lfantoniosi/CoCoTANG/README.md

# CoCoTANG

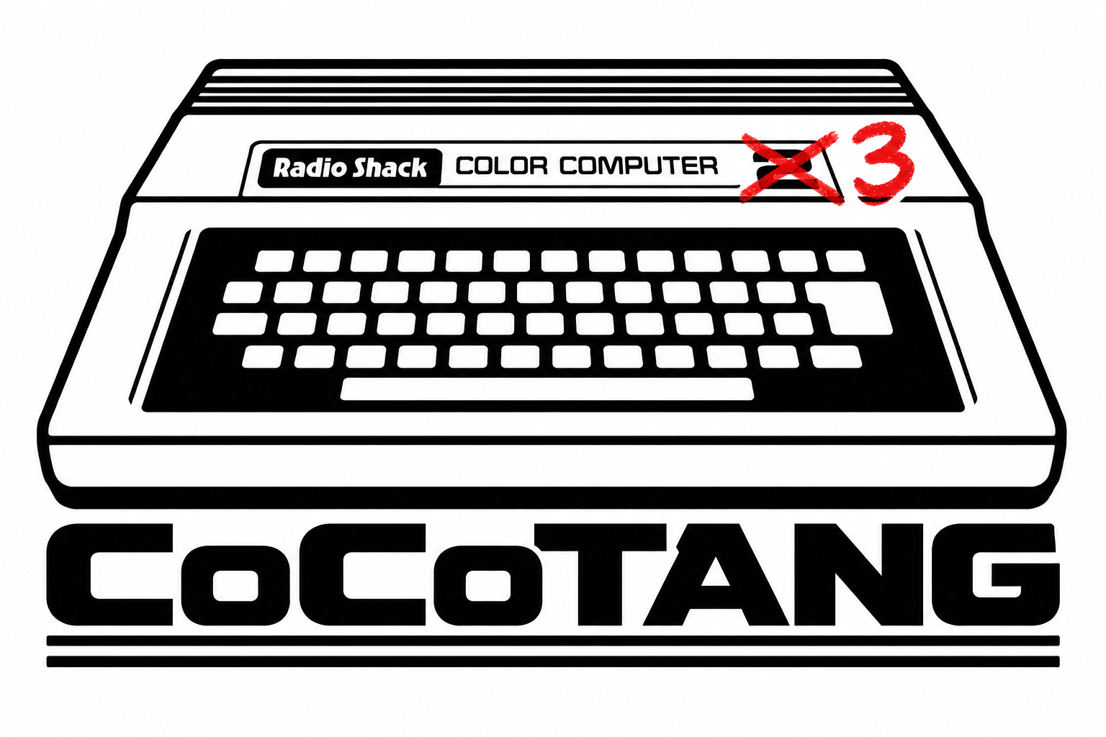
[picture p1: models/logo.png]
CoCoTANG logo


## Overview

CoCoTANG upgrades the Radio Shack/Tandy Color Computer 1 and 2 with a Tang Nano 20K FPGA board and CoCo 3 video and memory features. It retains the MC6809E CPU and motherboard PIAs while the FPGA implements the GIME video and memory subsystem, HDMI and analog video outputs, and a Glenside-compatible IDE interface backed by a microSD card. It also provides 8 MB of RAM, Orchestra-90 audio with stereo over HDMI, and Tandy Speech/Sound Cartridge (SSC) support.

This repository contains the FPGA sources, KiCad designs, fabrication files, and bill of materials.

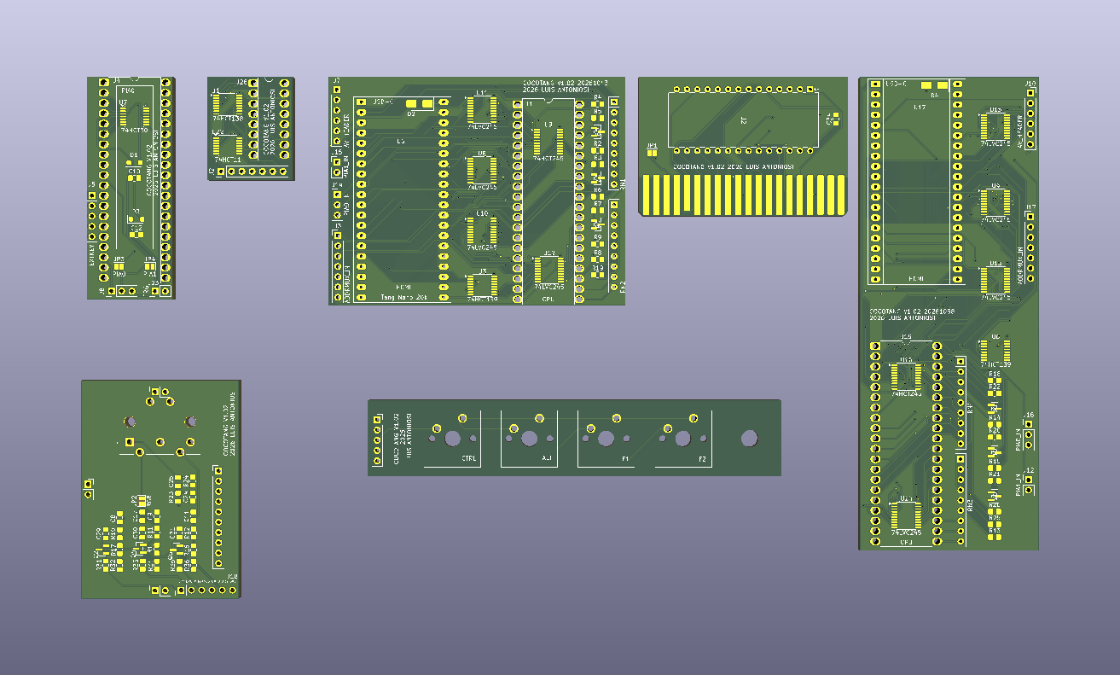
[picture p2: fpga/docs/board-panel.png]
Render of the complete CoCoTANG PCB panel


The assembly uses a **main board** for the CPU and Tang Nano 20K, **PIA0 and PIA1 adapter boards**, and an **address mux board** that replaces the motherboard 74LS138. An **analog video hat** and an **HDB-DOS ROM cartridge** are optional. The render above shows the boards arranged as a PCB panel. HDB-DOS can also be supplied through an FD-502 ROM socket or CoCo SDC flash bank.

The design uses NTSC machine clocking. The GIME's 50 Hz setting remains available, but selecting it does **not** switch to a PAL crystal. PAL-encoded CVBS/S-Video output is also supported. See [Build on macOS or Linux](#build-on-macos-or-linux) for video targets and the [FPGA pin and bus map](fpga/docs/pinout.md) for hardware connections.

## Compatibility

### Color Computer 1 power-supply noise

CoCoTANG has been confirmed working on a Color Computer 1 with added power-supply decoupling: **a 100 µF electrolytic capacitor and a 100 nF ceramic capacitor connected in parallel across the supply**, as shown below. This resolves the power-supply noise that previously caused rolling video interference and intermittent loss of analog sync, and also appeared to affect HDMI.

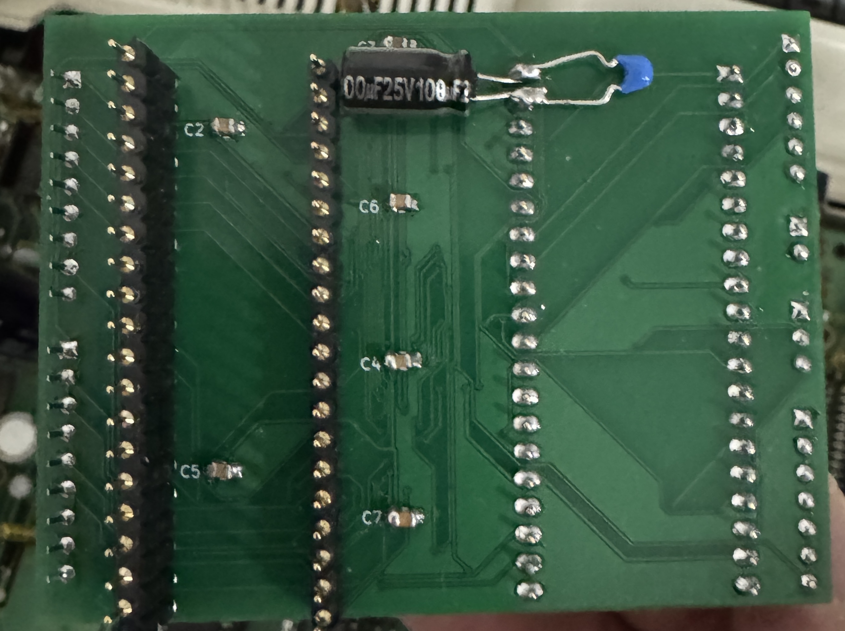
[picture p3: fpga/docs/coco1-decoupler.jpg]
100 µF electrolytic and 100 nF ceramic decoupling capacitors installed on the CoCoTANG board for CoCo 1 operation


### Games

So far, **The Contras is the only game found to fail to load in its original form**. CoCoTANG's **262.5-scanline timing drifts relative to the original CoCo 3**. The resulting timing difference affects an unprotected code section in the game and prevents the original version from loading.

Use the [patched version of The Contras](https://drive.google.com/file/d/1ANGJpljmbaEt34lFBowtTOSvq0qSiGtF/view?usp=sharing) instead. This patched version also includes **keyboard enhancements**.

### Multi-Pak Interface and real floppy drives

A **Multi-Pak Interface (MPI)** holds the cartridge data bus in a way that prevents access to CoCoTANG's internal peripheral registers. With an MPI connected, the **internal Glenside IDE, SSC sound/speech, and Orchestra-90 are unavailable**. Software that uses these internal devices must be run without the MPI.

**An MPI is required to use real floppy drives.** Plug the floppy disk controller into the MPI and connect the drives to that controller. This setup uses the external floppy controller, with the internal IDE, SSC, and Orchestra-90 unavailable as described above.

## Current FPGA features

- GIME video and memory mapping with 8 MB NoCan3-style RAM support and readable Disto MMU page bits.
- Simultaneous HDMI and analog video, with separate RGB, YPbPr, and CVBS/S-Video build targets.
- Six motherboard RESET selections combining normal, reversed, or disabled artifact colours with SSC sound/speech off or on.
- Tandy Speech/Sound Cartridge PSG, buffered allophones, and ASCII English text-to-speech, alongside the CoCo DAC and Orchestra-90 audio.
- HDMI status labels and an optional analog status banner with a larger font.

## Hardware and files

| Item | File or notes |
| --- | --- |
| PCB fabrication files | [Gerber/drill ZIPs for each board](kicad/gerber/) |
| KiCad schematic and PCB | [kicad/](kicad/) |
| Components | Full bill of materials below |
| FPGA project and sources | [fpga/](fpga/) |
| FPGA pin/bus map | [fpga/docs/pinout.md](fpga/docs/pinout.md) |

## Board quantities and Gerber downloads

For one CoCoTANG installation, you need **one main board, one address mux board, and two PIA boards**: one for PIA0 and one for PIA1. There are two main-board versions, for motherboard revisions **20261043** and **20261058**; choose the version that matches your motherboard. The HDB-DOS cartridge and video hat are optional.

| Board | Quantity per installation | Gerber/drill ZIP |
| --- | --- | --- |
| Main board (CPU / Tang Nano 20K) | 1 required; choose the matching version | See the compatibility table below |
| Address mux (addrmux) | 1 required | [gerber_addrmux.zip](kicad/gerber/gerber_addrmux.zip) |
| PIA card | 2 required: PIA0 and PIA1 | [gerber_pia.zip](kicad/gerber/gerber_pia.zip) |
| HDB-DOS cartridge | 1 optional | [gerber_cart.zip](kicad/gerber/gerber_cart.zip) |
| Video hat | 1 optional | [gerber_avideo.zip](kicad/gerber/gerber_avideo.zip) |
| External keyboard extension | 1 optional | [gerber_extkey.zip](kicad/gerber/gerber_extkey.zip) |

Use the same PIA Gerber ZIP to fabricate both PIA cards. Upload each desired board's ZIP separately to your PCB manufacturer and select the quantities above, subject to the manufacturer's minimum order quantity.

Select **1.2 mm PCB thickness** when ordering the adapter boards. The thinner boards reduce the installed profile and help the assembly fit under the keyboard.

## Motherboard compatibility

Tandy used several motherboard layouts for the CoCo 2. Identify your motherboard before ordering boards: the CPU and address mux adapters must fit its layout. Only the revisions marked compatible below are currently supported; other layouts may need different adapters.

| Motherboard revision | Compatible | Main board Gerber ZIP |
| --- | --- | --- |
| [20261043](fpga/docs/20261043.jpg) | Yes | [gerber_main_20261043.zip](kicad/gerber/gerber_main_20261043.zip) |
| [20261058](fpga/docs/20261058.jpg) | Yes | [gerber_main_20261058.zip](kicad/gerber/gerber_main_20261058.zip) |
| [20261044](fpga/docs/20261044.jpg) | No | — |
| [20261045](fpga/docs/20261045.jpg) | No | — |
| [20261059](fpga/docs/20261059.jpg) | No | — |

**CoCo 1 operation is confirmed with added 100 µF + 100 nF supply decoupling.** See the [decoupling details and installation photo](#color-computer-1-power-supply-noise).

## Bill of materials

Both main-board versions (**20261043** and **20261058**) use the same components and quantities; only the PCB layout differs. Use the fabrication drawing and silkscreen for the version you are assembling.

### Logic families and supply voltages

Use **HCT** parts for the 5 V logic: U9/U16 (74HCT245, depending on the main-board version), U1 (74HCT138), U22 (74HCT11), and U7 (74HCT30). Their TTL-compatible inputs accept the logic levels used at the motherboard interface. The table below gives the manufacturer part numbers, matching DigiKey part numbers, and TSSOP packages.

**U3/U6 are 74HC139 decoders powered from 3.3 V**, with their select inputs driven by the FPGA. Keep the HC version here: [74HCT139 is specified for a 4.5–5.5 V supply](https://assets.nexperia.com/documents/data-sheet/74HC_HCT139.pdf). A 3.3 V supply makes HC139 suitable for this 3.3 V logic domain; it does not turn HC into a generally TTL-compatible family. The KiCad labels now identify both decoder instances as HC139.

The four **74LVC245** buffers on each main board remain LVC parts for the 3.3 V interface; their reference designators are listed for both layouts below. Their TSSOP ordering code is **SN74LVC245APWR**.

### Main board — both versions

The reference columns identify the same components on each layout. Lists follow the same order across both columns. The three interrupt/reset resistors and the additional R/W pull-up are listed separately. The other adapter boards below are shared between both versions.

| Qty | Value | Description | DigiKey P/N | 20261043 references | 20261058 references | Alternative link |
| ---: | --- | --- | --- | --- | --- | --- |
| 1 | Tang Nano 20K | Tang Nano 20K FPGA Board | N/A | U5 | U17 | [AliExpress](https://www.aliexpress.com/item/1005010280135538.html) |
| 6 | 0.1 µF | CAP CER 0805 0.1UF 100VDC X7R | [399-C0805F104K1RACAUTOCT-ND](https://www.digikey.com/en/products/detail/kemet/C0805F104K1RACAUTO/26735352) | C2, C3, C4, C5, C6, C7 | C13, C16, C19, C14, C18, C15 |  |
| 3 | MMBT3904-TP | TRANS NPN 40V 0.2A SOT-23 | [MMBT3904TPMSCT-ND](https://www.digikey.com/en/products/detail/mcc-micro-commercial-components/MMBT3904-TP/717280) | Q7, Q8, Q9 | Q1, Q3, Q6 |  |
| 1 | SS14 | DIODE SCHOTTKY 40V 1A DO214AC | [SS14CT-ND](https://www.digikey.com/en/products/detail/onsemi/SS14/965474) | D2 | D4 |  |
| 3 | 10K | RES 10K OHM 1% 1/8W 0805 | [311-10.0KCRCT-ND](https://www.digikey.com/en/products/detail/yageo/RC0805FR-0710KL/727535) | R2, R4, R6 | R14, R18, R15 |  |
| 3 | 4.7K | RES 4.7K OHM 1% 1/8W 0805 | [311-4.70KCRCT-ND](https://www.digikey.com/en/products/detail/yageo/RC0805FR-074K7L/730876) | R3, R5, R7 | R20, R22, R21 |  |
| 1 | 4.7K | R/W pull-up, 1% 1/8W 0805 | [311-4.70KCRCT-ND](https://www.digikey.com/en/products/detail/yageo/RC0805FR-074K7L/730876) | R19 | R13 |  |
| 2 | 47K | RES SMD 47K OHM 1% 1/8W 0805 | [YAG3735CT-ND](https://www.digikey.com/en/products/detail/yageo/AC0805FR-0747KL/6006584) | R8, R9 | R25, R26 |  |
| 2 | 4.7K | RES ARRAY 8 RES 4.7K OHM 9SIP | [4609X-101-472LF-ND](https://www.digikey.ca/en/products/detail/bourns-inc/4609X-101-472LF/3593671) | RN1, RN2 | RN4, RN3 |  |
| 4 | SN74LVC245APWR | 8-bit bus transceiver, 1.65–3.6 V, TSSOP-20 | [296-1233-1-ND](https://www.digikey.com/en/products/detail/texas-instruments/SN74LVC245APWR/276501) | U8, U10, U11, U12 | U4, U13, U15, U14 |  |
| 1 | SN74HCT245PWR | 8-bit bus transceiver, TTL inputs, 4.5–5.5 V, TSSOP-20 | [296-8404-1-ND](https://www.digikey.com/en/products/detail/texas-instruments/SN74HCT245PWR/376998) | U9 | U16 |  |
| 1 | 74HC139PW,118 | Dual 2-to-4 decoder, CMOS inputs, 2–6 V; used at 3.3 V, TSSOP-16 | [1727-6580-1-ND](https://www.digikey.com/en/products/detail/nexperia-usa-inc/74HC139PW-118/2813773) | U3 | U6 |  |
| 1 | SIL FEMALE HDR | MACHINE PIN SOCKET 40P 2.54MM PI | [SMC-1A-40-1-GT-HT](https://www.digikey.com/en/products/detail/adam-tech/SMC-1A-40-1-GT-HT/9831942) | U5 | U17 | [AliExpress](https://www.aliexpress.com/item/1005008648234734.html) |
| 1 | DIP-40 SOCKET | MACHINE PIN SOCKET, IC, DIP, 40P | [ICM-640-1-GT-HT](https://www.digikey.com/en/products/detail/adam-tech/ICM-640-1-GT-HT/9832971) | J1 | J19 | [AliExpress](https://www.aliexpress.com/item/1005006139495909.html) |

### PIA0 adapter

| Qty | Value | Description | DigiKey P/N | References | Alternative link |
| ---: | --- | --- | --- | --- | --- |
| 1 | 0.1 µF | CAP CER 0805 0.1UF 100VDC X7R | [399-C0805F104K1RACAUTOCT-ND](https://www.digikey.com/en/products/detail/kemet/C0805F104K1RACAUTO/26735352) | C1 | |
| 1 | DIP-40 SOCKET | MACHINE PIN SOCKET, IC, DIP, 40P | [ICM-640-1-GT-HT](https://www.digikey.com/en/products/detail/adam-tech/ICM-640-1-GT-HT/9832971) | J4 | [AliExpress](https://www.aliexpress.com/item/1005006139495909.html) |
| 1 | 74HCT30PW,118 | 8-input NAND gate, TTL inputs, 4.5–5.5 V, TSSOP-14 | [1727-6632-1-ND](https://www.digikey.com/en/products/detail/nexperia-usa-inc/74HCT30PW-118/1230819) | U7 | |
| 2 | 1,800 pF | CAP CER 1800PF 250V C0G/NP0 0805 | [490-GCM21A5C2E182FX01DCT-ND](https://www.digikey.ca/en/products/detail/murata-electronics/GCM21A5C2E182FX01D/17845644) | C10,C12 | |
| 2 | SD103BW | DIODE SCHOTTKY 30V 0.35A SOD123F | [4878-SD103BWCT-ND](https://www.digikey.com/en/products/detail/diotec-semiconductor/SD103BW/22600375) | D1,D3 | |

### PIA1 adapter

| Qty | Value | Description | DigiKey P/N | References | Alternative link |
| ---: | --- | --- | --- | --- | --- |
| 1 | DIP-40 SOCKET | MACHINE PIN SOCKET, IC, DIP, 40P | [ICM-640-1-GT-HT](https://www.digikey.com/en/products/detail/adam-tech/ICM-640-1-GT-HT/9832971) | J4 | [AliExpress](https://www.aliexpress.com/item/1005006139495909.html) |

### Address mux board

| Qty | Value | Description | DigiKey P/N | References | Alternative link |
| ---: | --- | --- | --- | --- | --- |
| 2 | 0.1 µF | CAP CER 0805 0.1UF 100VDC X7R | [399-C0805F104K1RACAUTOCT-ND](https://www.digikey.com/en/products/detail/kemet/C0805F104K1RACAUTO/26735352) | C32,C33 | |
| 1 | SN74HCT138PWR | 3-to-8 decoder, TTL inputs, 4.5–5.5 V, TSSOP-16 | [296-8388-1-ND](https://www.digikey.com/en/products/detail/texas-instruments/SN74HCT138PWR/377055) | U1 | |
| 1 | 74HCT11PW,118 | Triple 3-input AND gate, TTL inputs, 4.5–5.5 V, TSSOP-14 | [1727-7964-1-ND](https://www.digikey.com/en/products/detail/nexperia-usa-inc/74HCT11PW-118/1230602) | U22 | |
| 1 | DIP-16 SOCKET | CONN IC DIP SOCKET 16POS GOLD | [SA163000](https://www.digikey.com/en/products/detail/on-shore-technology-inc/SA163000/3313525) | J28 | [AliExpress](https://www.aliexpress.com/item/32866483409.html) |

### HDB-DOS cartridge

| Qty | Value | Description | DigiKey P/N | References | Alternative link |
| ---: | --- | --- | --- | --- | --- |
| 1 | DIP-28 SOCKET | CONN IC DIP SOCKET 28POS GOLD | [110-41-628-41-001000](https://www.digikey.com/en/products/detail/mill-max-manufacturing-corp/110-41-628-41-001000/2538108) | U2 | [AliExpress](https://www.aliexpress.com/item/32866483409.html) |
| 1 | 0.1 µF | CAP CER 0805 0.1UF 100VDC X7R | [399-C0805F104K1RACAUTOCT-ND](https://www.digikey.com/en/products/detail/kemet/C0805F104K1RACAUTO/26735352) | C34 | |
| 1 | AT28C64B-15PU | IC EEPROM 64KBIT PARALLEL 28DIP | [AT28C64B-15PU-ND](https://www.digikey.com/en/products/detail/microchip-technology/AT28C64B-15PU/1008529) | U2 | |

### Analog video board

| Qty | Value | Description | DigiKey P/N | References | Alternative link |
| ---: | --- | --- | --- | --- | --- |
| 3 | 0.1 µF | CAP CER 0805 0.1UF 100VDC X7R | [399-C0805F104K1RACAUTOCT-ND](https://www.digikey.com/en/products/detail/kemet/C0805F104K1RACAUTO/26735352) | C29,C30,C31 | |
| 3 | 470 pF | CAP CER 470PF 50V C0G/NP0 0805 | [490-1617-1-ND](https://www.digikey.com/en/products/detail/murata-electronics/GRM2165C1H471JA01D/587515) | C8,C9,C11 | |
| 1 | 1 µF | CAP CER 1UF 25V X7R 0805 | [399-C0805C105K3RACTUCT-ND](https://www.digikey.com/en/products/detail/kemet/C0805C105K3RACTU/3471727) | C15 | |
| 6 | 1K | RES 1K OHM 1% 1/8W 0805 | [541-3977-1-ND](https://www.digikey.com/en/products/detail/vishay-dale/CRCW08051K00FKEAC/7928660) | R31,R17,R33,R1,R35,R16 | |
| 3 | 75 | RES 75 OHM 1% 1/8W 0805 | [541-CRCW080575R0FKEACCT-ND](https://www.digikey.com/en/products/detail/vishay-dale/CRCW080575R0FKEAC/12745060) | R10,R11,R12 | |
| 3 | 4.7K | RES 4.7K OHM 1% 1/8W 0805 | [311-4.70KCRCT-ND](https://www.digikey.com/en/products/detail/yageo/RC0805FR-074K7L/730876) | R32,R34,R36 | |
| 1 | 6.8 nF | CAP CER 6800PF 250V C0G/NP0 0805 | [490-GCM21B5C2E682JX0ALCT-ND](https://www.digikey.com/en/products/detail/murata-electronics/GCM21B5C2E682JX0AL/17846799) | C24 | |
| 1 | 4.7 µF | CAP CER 4.7UF 16V X7R 0805 | [732-7666-1-ND](https://www.digikey.com/en/products/detail/w%C3%BCrth-elektronik/885012207053/5453521) | C25 | |
| 1 | 100K | RES 100K OHM 1% 1/8W 0805 | [541-3978-1-ND](https://www.digikey.com/en/products/detail/vishay-dale/CRCW0805100KFKEAC/7928661) | R24 | |
| 3 | MMBT3904-TP | TRANS NPN 40V 0.2A SOT-23 | [MMBT3904TPMSCT-ND](https://www.digikey.com/en/products/detail/mcc-micro-commercial-components/MMBT3904-TP/717280) | Q2,Q4,Q5 | |
| 1 | DIN-5 FEMALE | D5 PIN DIN SOCKET 180 DEGREE | [4654-FC680805-ND](https://www.digikey.ca/en/products/detail/cliff-electronic-components-ltd/FC680805/24420883) | J24 | [AliExpress](https://www.aliexpress.com/item/32981543684.html)|

## Boards Interconnection
| Qty | Value | Description | DigiKey P/N | References | Alternative link |
| ---: | --- | --- | --- | --- | --- |
| 2 | PRPC040SBAN-M71RC | CONN HEADER R/A 40POS 2.54MM | [S1111EC-40-ND](https://www.digikey.ca/en/products/detail/sullins-connector-solutions/PRPC040SBAN-M71RC/2775294) | 
| 2 |1950 | JUMPER WIRE F TO F 6" 28AWG | [1528-1961-ND](https://www.digikey.ca/en/products/detail/adafruit-industries-llc/1950/6827084)

*NOTE:* You may need more than one jumper wires pack or source at different place like Amazon. CoCo1 requires longer jumper wires  

## Assembly

Print the [fabrication drawing](fpga/docs/fab.pdf) and use it with the board silkscreen to identify component positions. Check diode orientation before soldering. The main-board bill of materials applies to both supported versions; component positions differ between layouts.

Several adapters have oversized socket holes. They require machined-pin sockets whose pins extend through the adapter to connect to the motherboard socket while holding the original IC above it. Use 1.2 mm PCBs to reduce the overall assembly height and improve clearance under the keyboard.

1. Locate and desolder the CPU, VDG, SAM, PIA0, PIA1, and 74LS138.
2. Keep the SAM, VDG, and 74LS138 as spares; the FPGA replaces their functions.
3. Install sockets in the motherboard. Do not solder the adapter boards directly to it.
4. Check clearance around the adapters. Some original capacitors marked `104` are oversized, and nearby radial capacitors may also interfere. Where necessary, desolder and reposition their leads before bending the capacitors closer to the motherboard.
5. Populate the adapter boards, checking diode orientation. Configure each PIA adapter as described in [PIA adapter configuration](#pia-adapter-configuration).
6. Modify pin 5 of each joystick connector and wire it to the PIA0 adapter as described in [Joystick second-button support](#joystick-second-button-support).
7. Fit the CPU and PIAs to their adapters, install the adapters, and connect the boards as shown in the [installed prototype](fpga/docs/installed_prototype.jpg).
8. Program the Tang Nano 20K with the desired `.fs` bitstream and CoCo 3 ROM, following the programming instructions below.
9. If using the optional HDB-DOS cartridge, program its EEPROM with [hdblba.rom](fpga/roms/hdblba.rom) using an EEPROM programmer.
10. Turn on the computer. The boot screen should look like the example below.

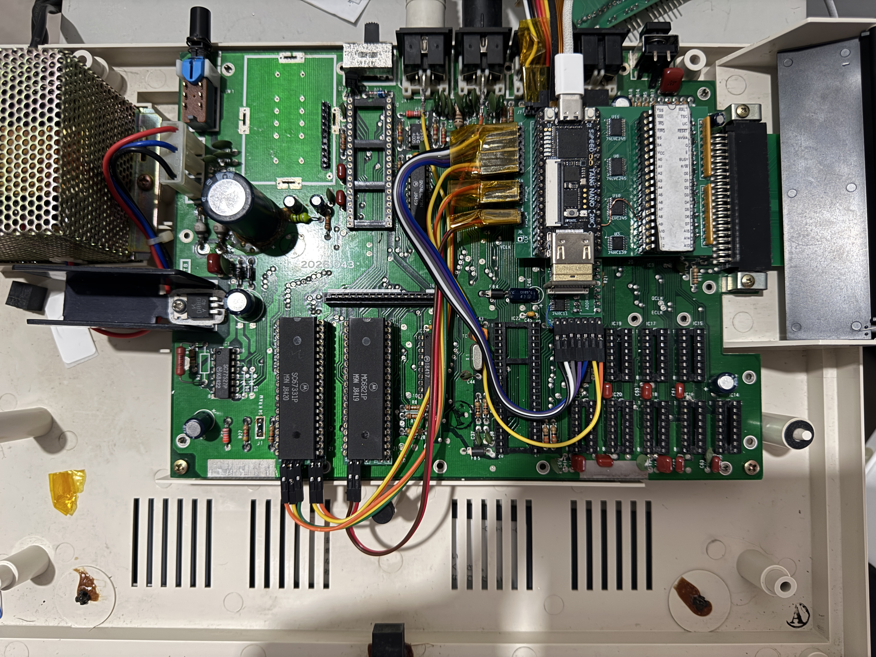
[picture p4: fpga/docs/installed_prototype.jpg]
Installed CoCoTANG prototype showing the adapter boards and wiring


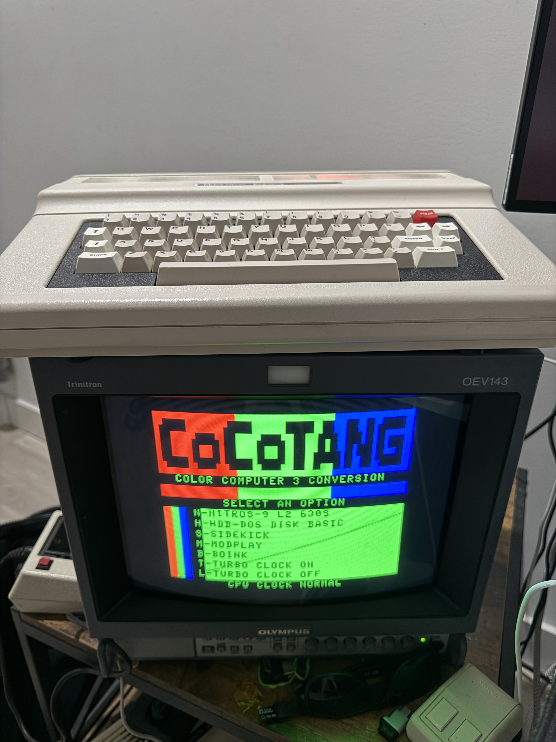
[picture p5: fpga/docs/CoCoTANG-RGB.jpg]
CoCoTANG boot screen


### Assembled boards

The photos below show the component population and header placement, in assembly order. Front and back views are included where available.

#### Main board

The main board carries the CPU socket, Tang Nano 20K headers, bus buffers, and connections to the other adapters. The photos show the assembled board before fitting the CPU and FPGA module. Choose the layout that matches your motherboard revision.

| Front | Back |
| --- | --- |
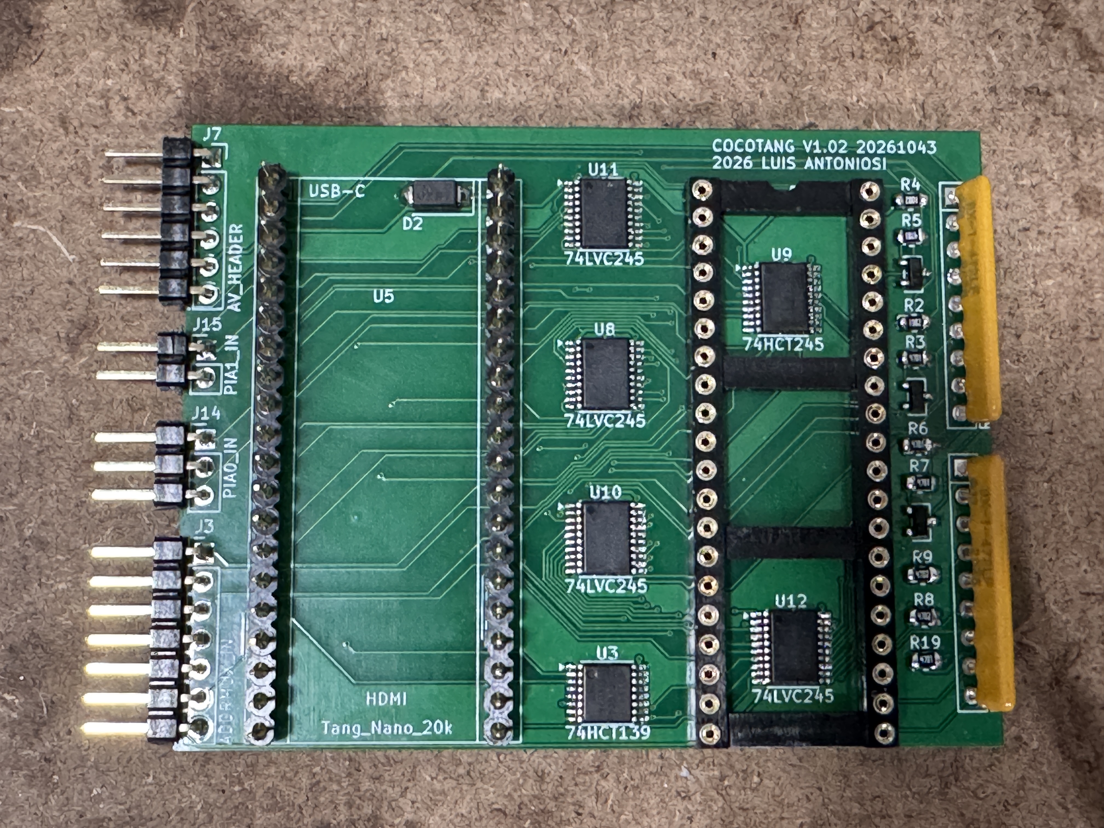
[picture p6: fpga/docs/main-front.JPG]
Assembled main board, front, showing CPU socket, FPGA headers, and bus buffers
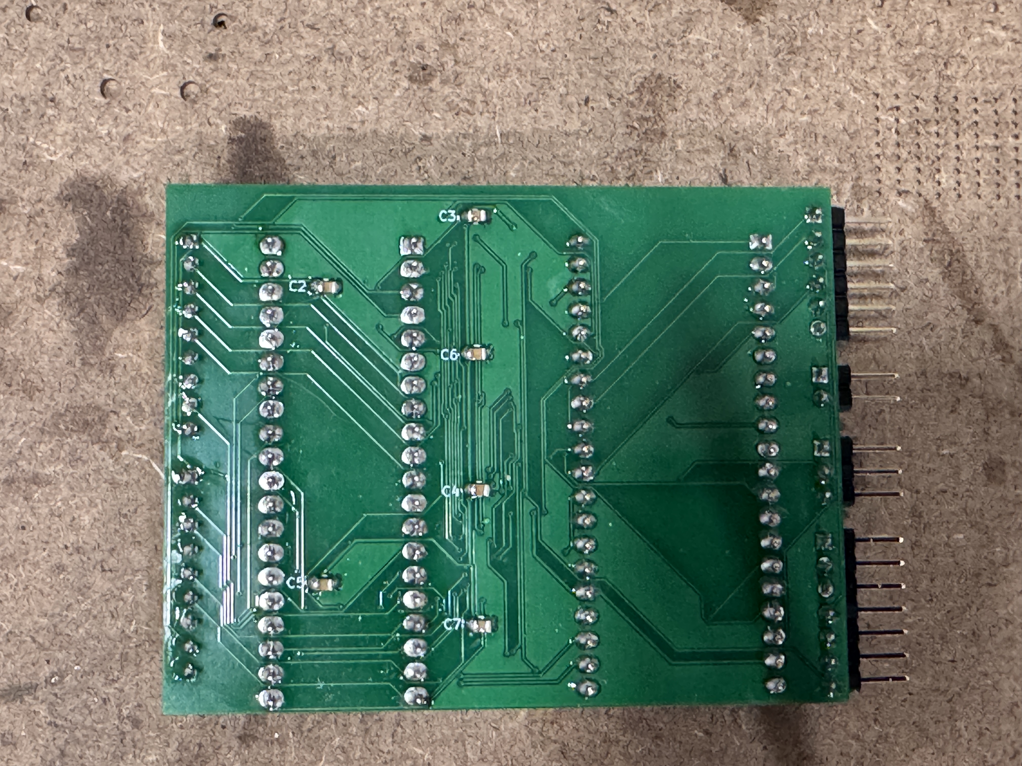
[picture p7: fpga/docs/main-back.JPG]
Assembled main board, back, showing motherboard connection pins
|  |  |

#### ADDRMUX board

The address mux adapter plugs into the motherboard's former **74LS138** position and connects to the main board. **Leave the 74LS138 socket on the ADDRMUX adapter empty; do not reinstall the original IC in it.** The adapter's onboard logic replaces its function.

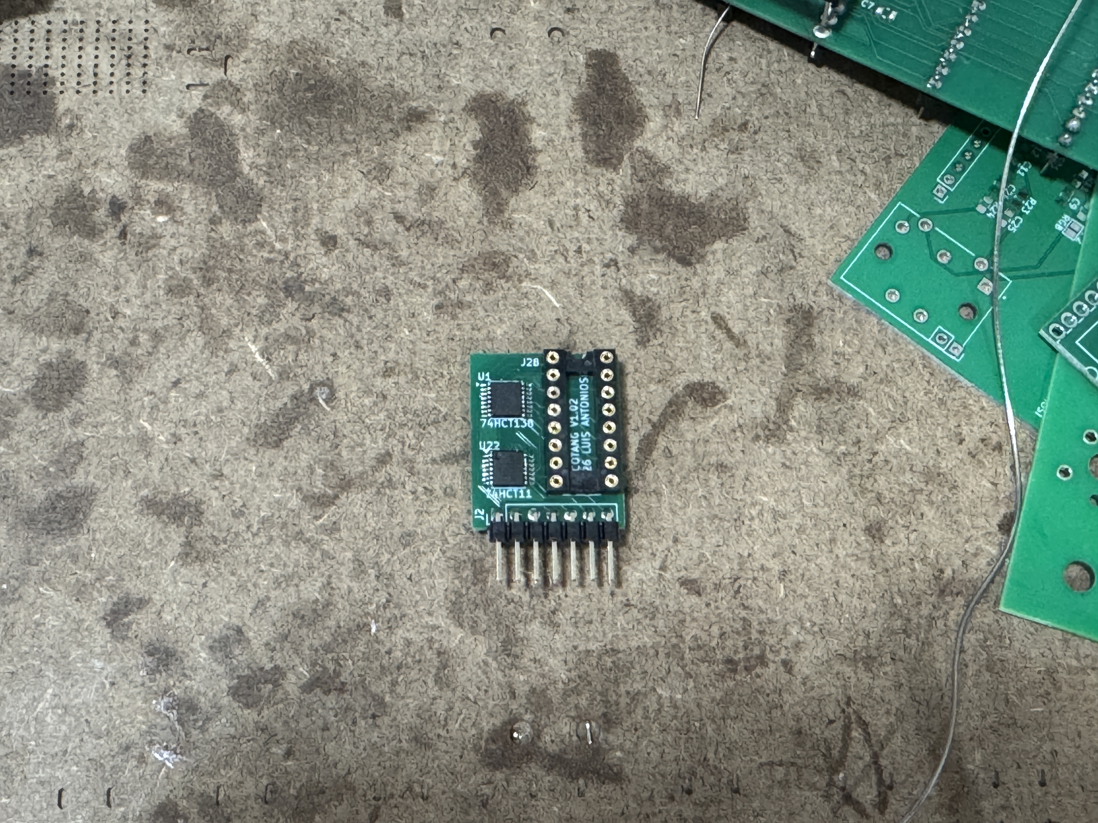
[picture p8: fpga/docs/addrmux-front.JPG]
Assembled ADDRMUX board with its 74LS138 socket deliberately left empty


#### PIA0 adapter

Populate the logic IC, diodes, capacitors, and headers required for PIA0, and select the **PIA0** jumper setting. The external keyboard header is fitted only on this adapter. These photos show the board before installing the PIA.

| Front | Back |
| --- | --- |
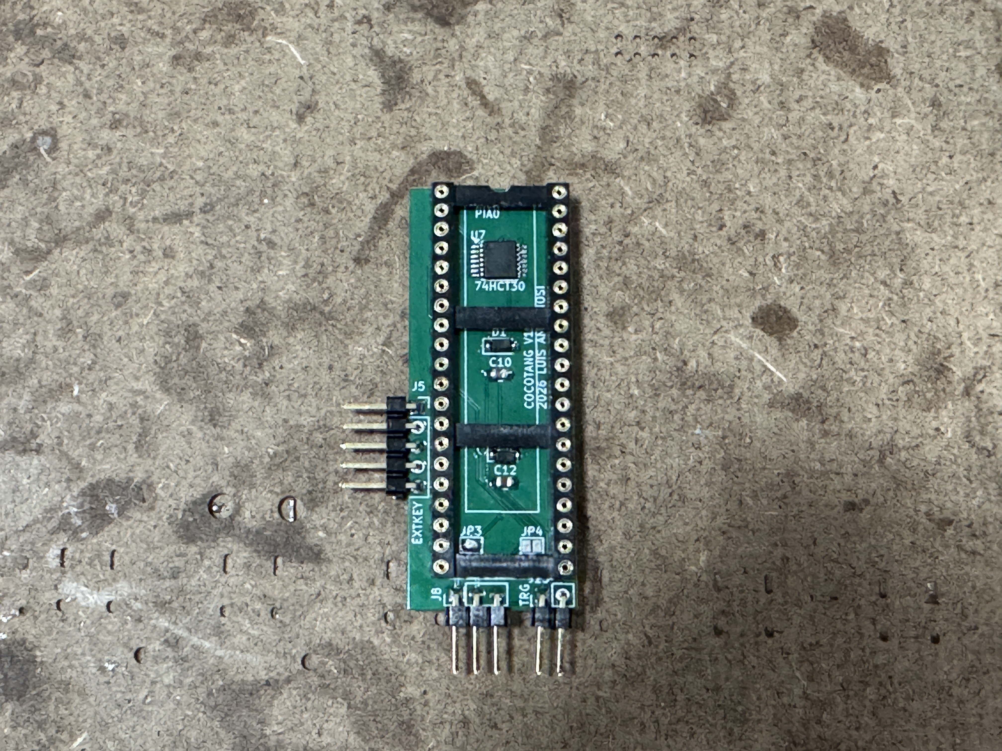
[picture p9: fpga/docs/pia0-front.JPG]
Assembled PIA0 adapter, front, showing populated logic and headers
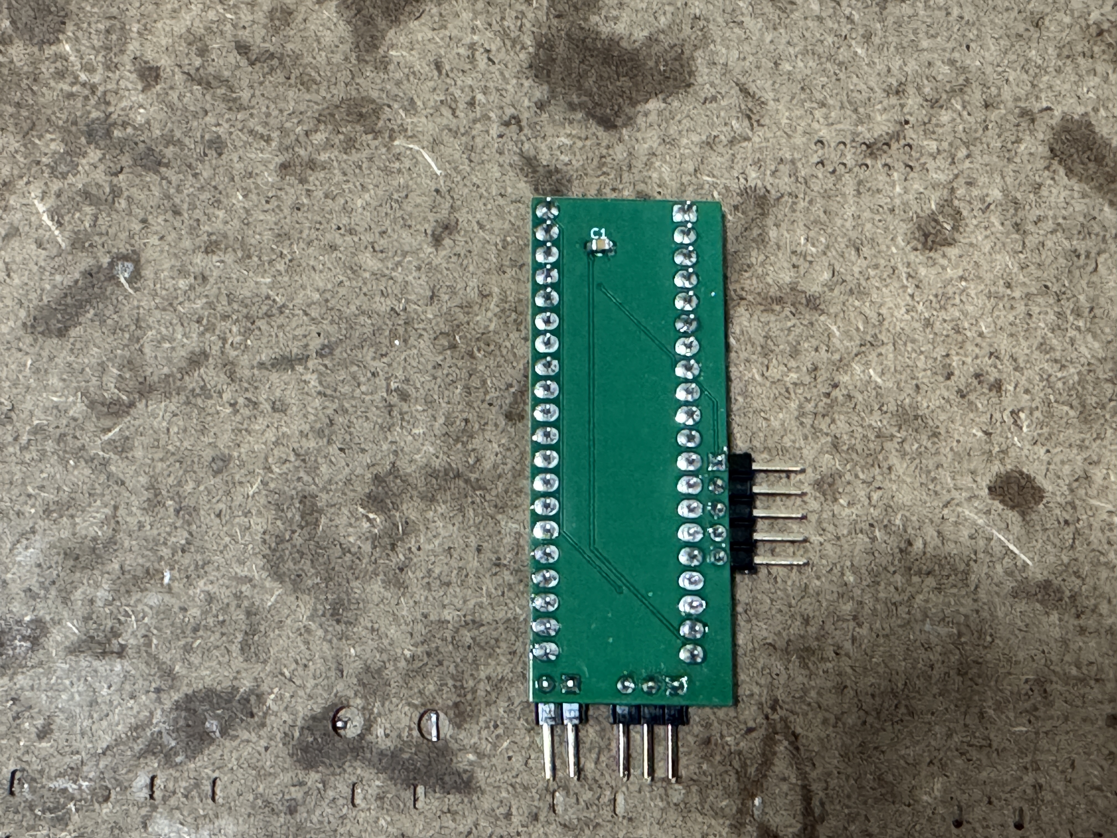
[picture p10: fpga/docs/pia0-back.JPG]
Assembled PIA0 adapter, back, showing motherboard connection pins
|  |  |

#### PIA1 adapter

PIA1 uses the same PCB with the **PIA1** jumper setting. Fit the socket and required signal header; leave the PIA0-only logic, diodes, capacitors, and external keyboard header unpopulated. These photos show the board before installing the PIA.

| Front | Back |
| --- | --- |
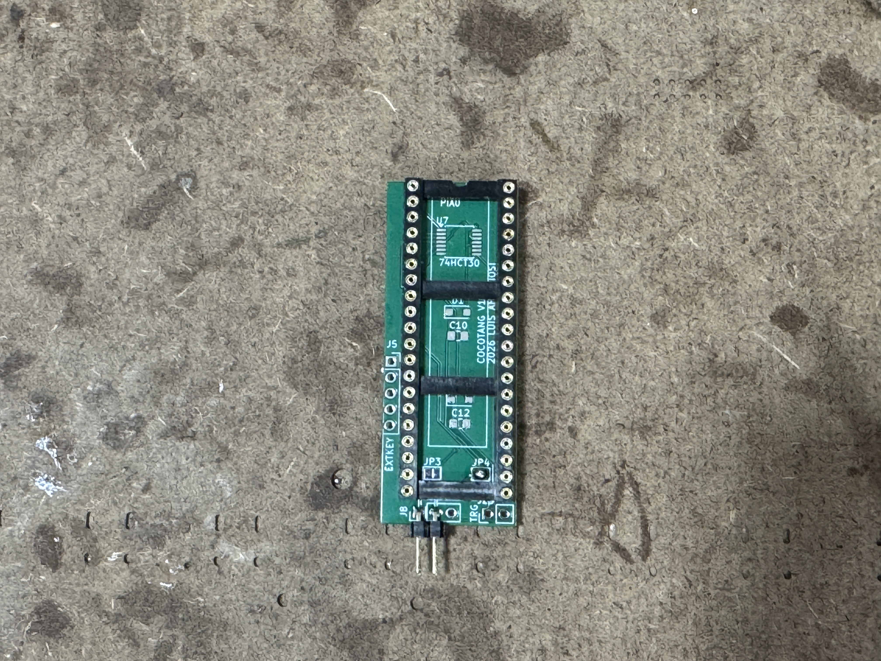
[picture p11: fpga/docs/pia1-front.JPG]
Assembled PIA1 adapter, front, showing the reduced component population
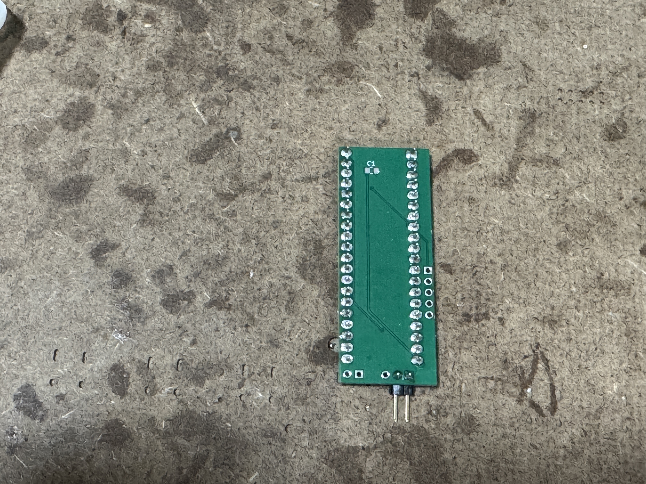
[picture p12: fpga/docs/pia1-back.JPG]
Assembled PIA1 adapter, back, showing motherboard connection pins
|  |  |

#### AVIDEO board

The optional analog audio/video board can be mounted in the **original RF modulator/shield location**. Enlarge the opening in the CoCo's cover to clear the 5-pin DIN connector. Use **pin headers on the back of the AVIDEO PCB to secure it to the CoCo motherboard**, as shown in the back view.

| Front | Back / mounting headers |
| --- | --- |
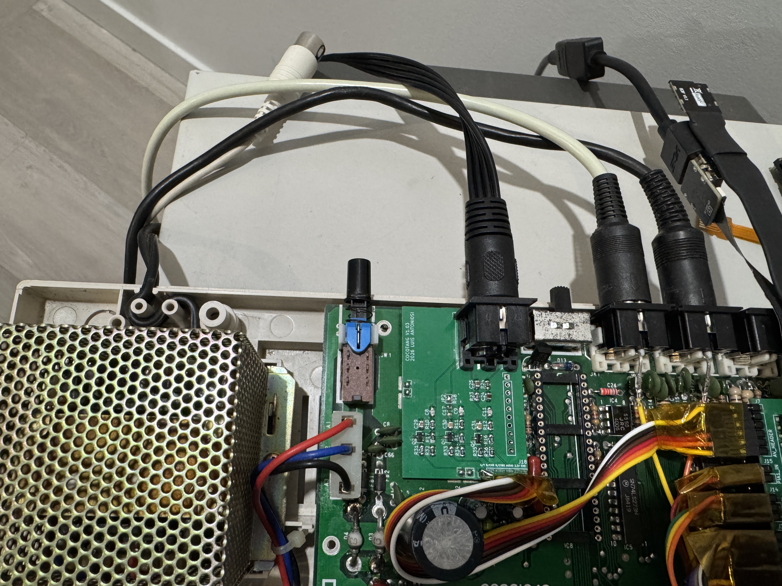
[picture p13: fpga/docs/avideo-front.JPG]
Assembled AVIDEO board, front, showing the analog output circuitry and connector
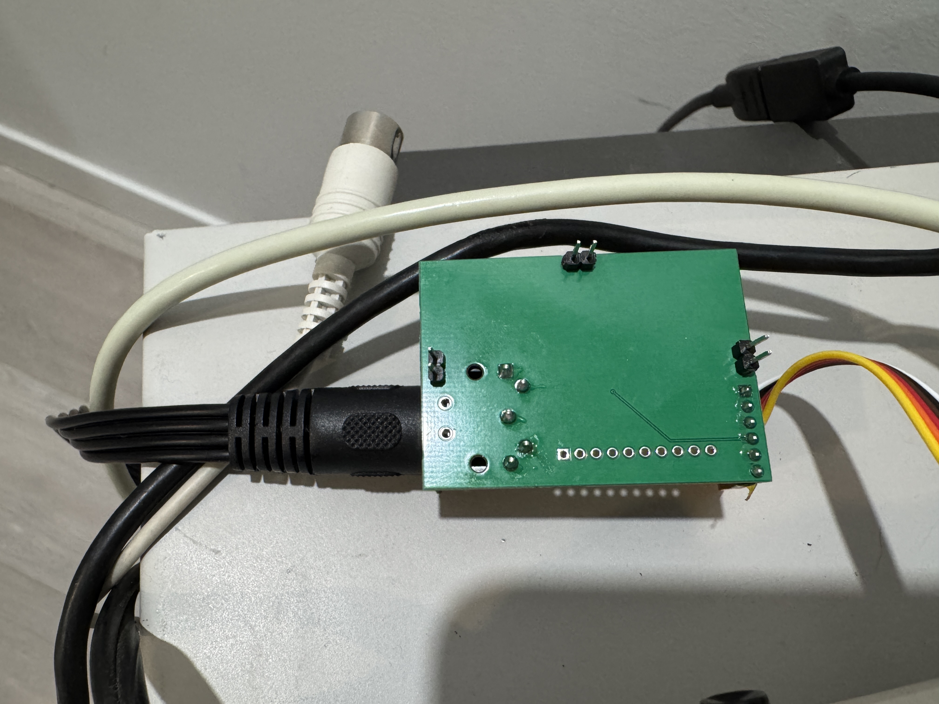
[picture p14: fpga/docs/avideo-back.JPG]
AVIDEO board, back, showing the pin headers used to secure it to the CoCo motherboard
|  |  |

The completed installation brings the main board, ADDRMUX, PIA adapters, and AVIDEO board together:

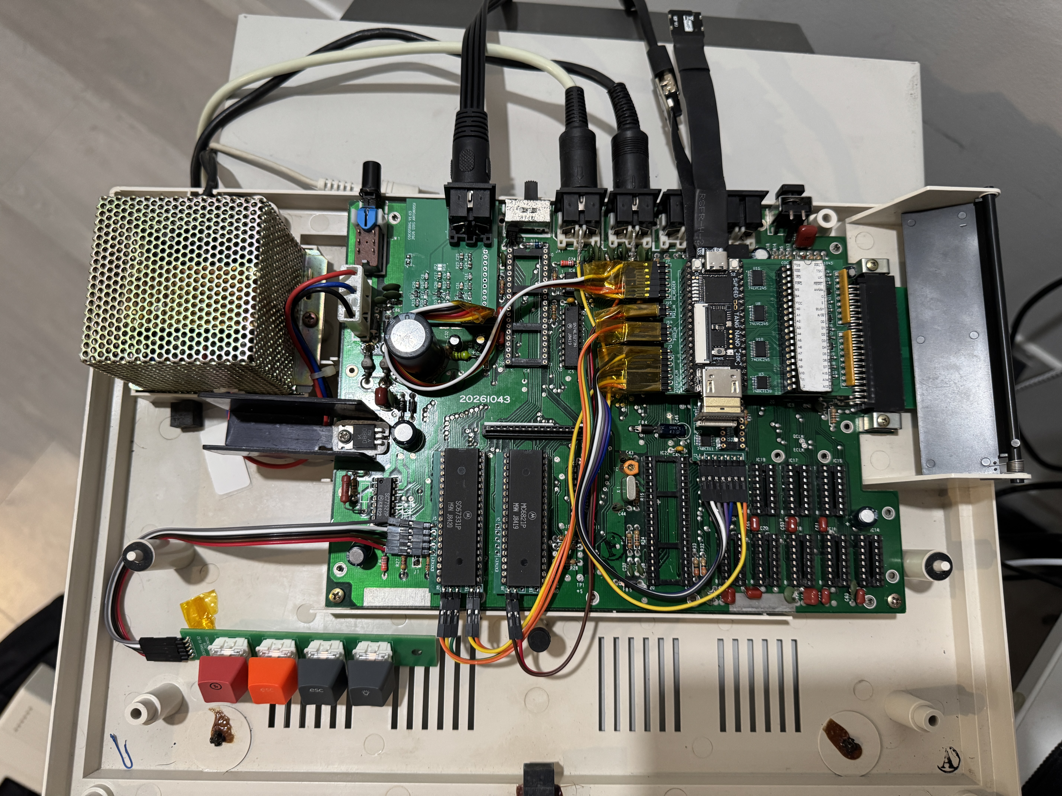
[picture p15: fpga/docs/fully-assembled.JPG]
Fully assembled CoCoTANG installation


### Complete assembly and umbilical cables

The photo below shows the fully assembled main board, PIA0, PIA1, ADDRMUX, AVIDEO, and external keyboard companion with their umbilical cables connected. Use it as an overview alongside the [pin and bus map](fpga/docs/pinout.md) when connecting the boards.

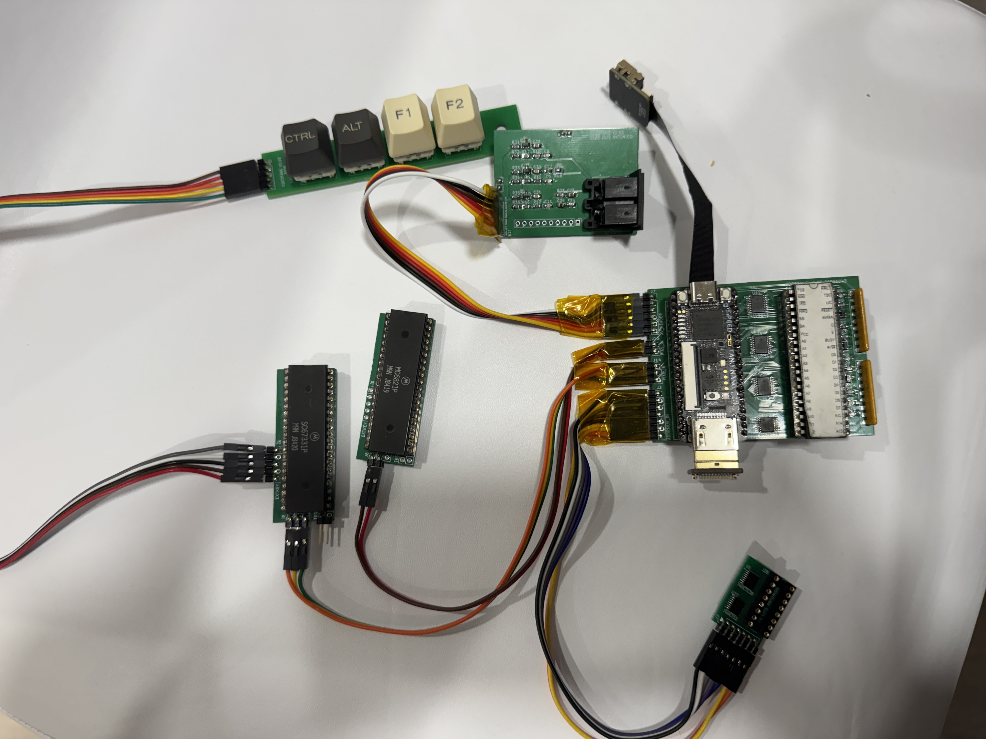
[picture p16: fpga/docs/full-assembled-umbelicals.JPG]
Complete CoCoTANG assembly with the FPGA module, CPU, PIAs, ADDRMUX, AVIDEO, keyboard companion, and connecting umbilical cables


### AVIDEO mounting and case opening

#### Prepare the RF modulator area

With the original RF module removed, prepare its mounting position for AVIDEO. Remove the plastic spacers from the mounting header pins so the AVIDEO PCB can sit close to the motherboard. Leave the metal pins in place for soldering the board, as shown below.

Former RF modulator position prepared for AVIDEO, with the plastic header spacers removed from the mounting pins


#### Trim the underside and solder the board close to the motherboard

Clip all excess component leads and header-pin ends on the **underside of AVIDEO**, and remove excess solder that would prevent the board from sitting close to the motherboard. Retain the mounting pins needed to secure it. Fit the board over the prepared RF-area mounting pins, align the DIN-5 connector with the rear of the case, and solder the mounting pins with the PCB close to the motherboard. Keep clearance between the underside solder joints and the motherboard.

| Trimmed AVIDEO underside | Mounted board, side view |
| --- | --- |
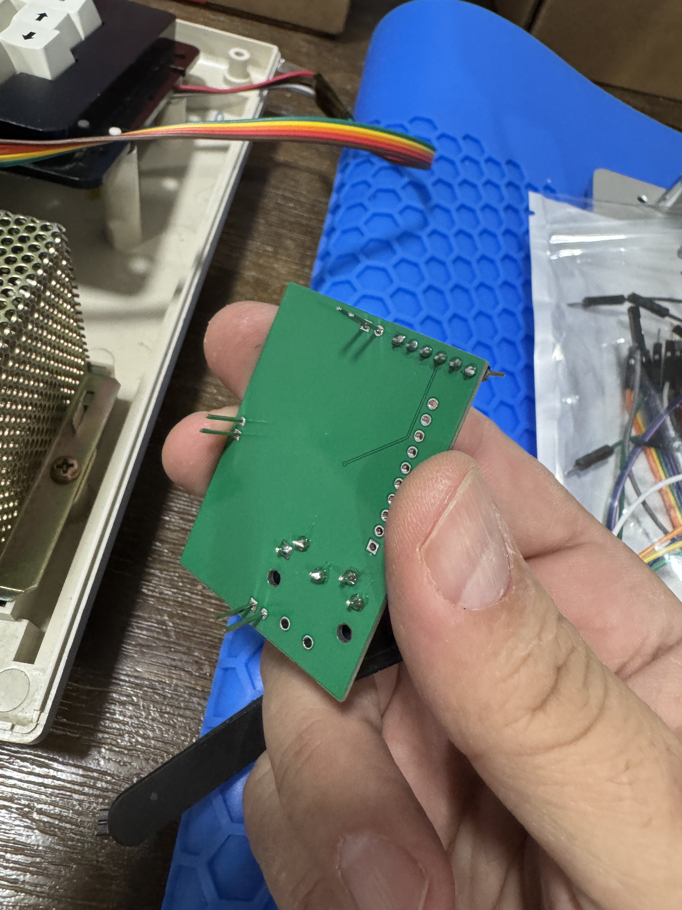
[picture p18: fpga/docs/under-avideo.JPG]
AVIDEO underside showing trimmed component leads and solder joints before mounting
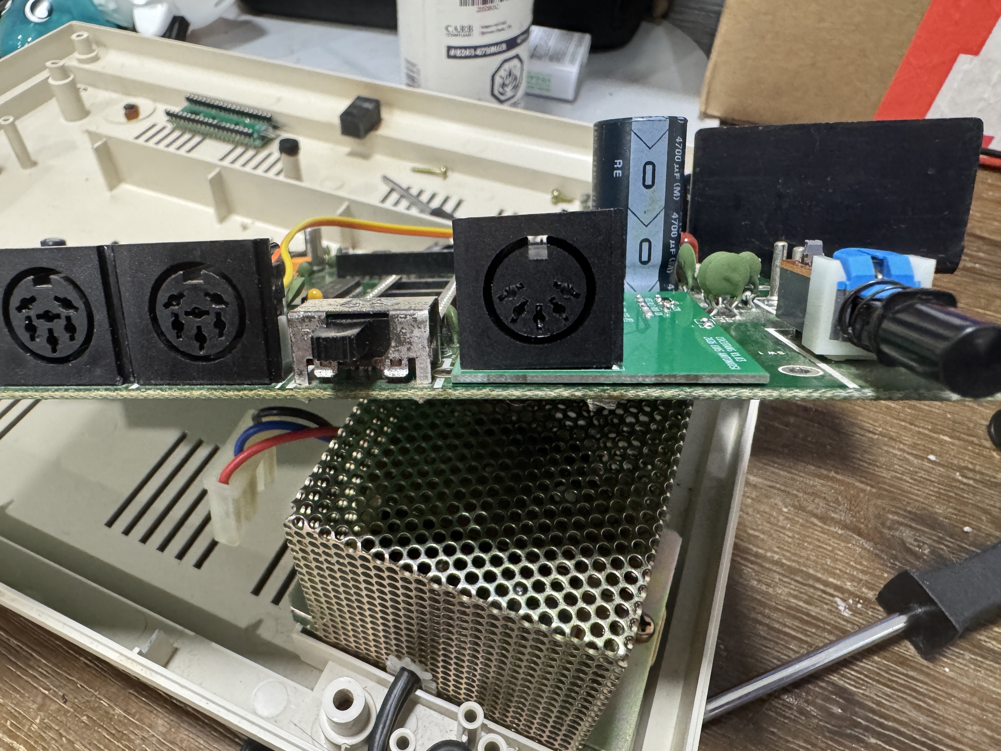
[picture p19: fpga/docs/soldered-close.JPG]
AVIDEO soldered close to the motherboard in the former RF modulator position, with the DIN-5 connector facing the rear
|  |  |

#### Copy an existing opening onto tape

Use a neighboring DIN connector opening as a template. Apply masking tape over it and copy its outline by trimming the tape to match the opening. Peel off the tape and stick it over the original **TO TV** opening, aligning the bottom edge and checking its position against the installed AVIDEO connector. The transferred outline marks the enlarged opening needed for the DIN-5 plug.

| Copy the opening onto masking tape | Transfer the tape to the TO TV opening |
| --- | --- |
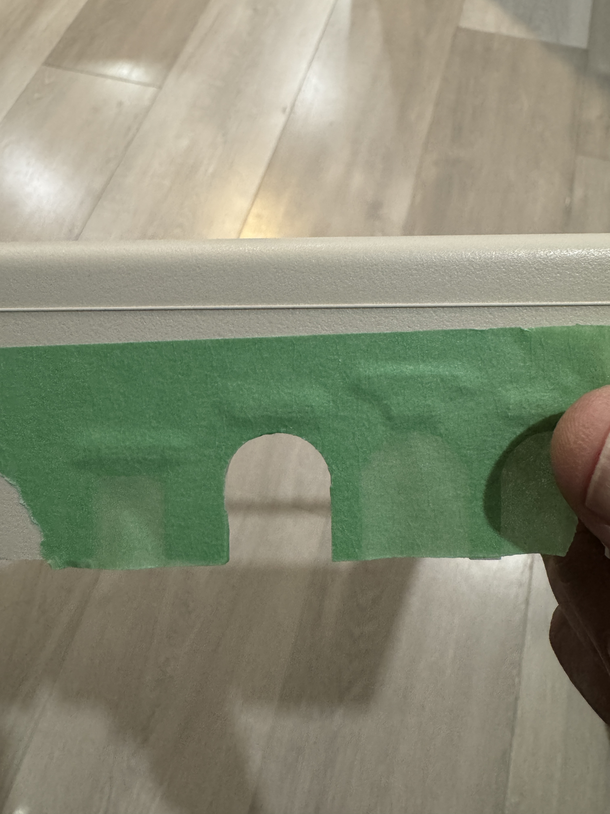
[picture p20: fpga/docs/copy-tape.JPG]
Masking tape cut to copy the shape of an existing DIN connector opening
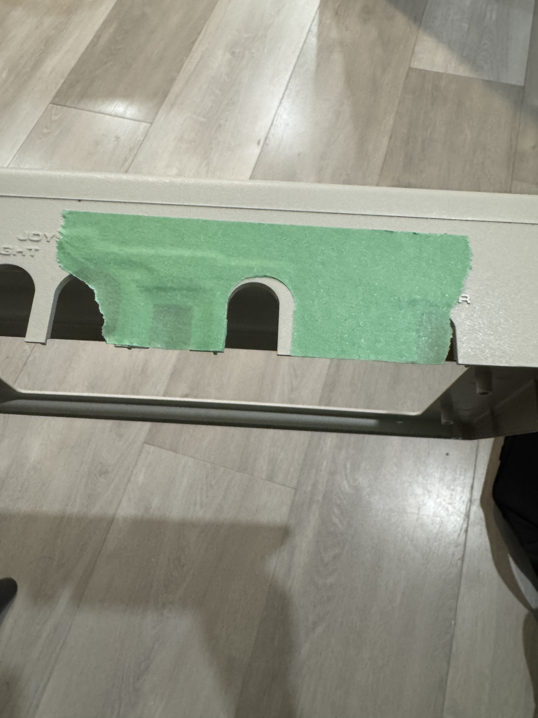
[picture p21: fpga/docs/paste-tape.JPG]
Tape template transferred to the original TO TV opening to mark the larger DIN-5 cutout
|  |  |

#### Enlarge the opening with a Dremel bit

Remove the cover from the computer before machining it. Use a Dremel or similar rotary tool with a bit like the one shown to enlarge the opening to the tape outline. Remove material gradually, smooth the edges, and check the fit of the DIN-5 plug. Clear away the plastic debris before refitting the cover.

| Rotary-tool bit | Finished opening |
| --- | --- |
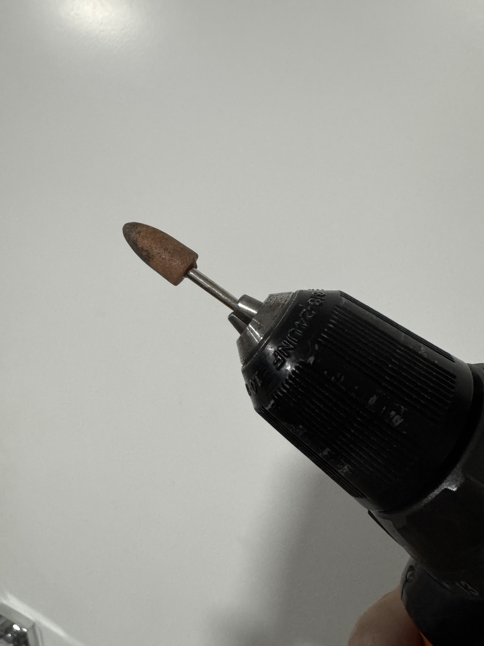
[picture p22: fpga/docs/dremel-bit.JPG]
Rounded abrasive rotary-tool bit used to enlarge the plastic case opening
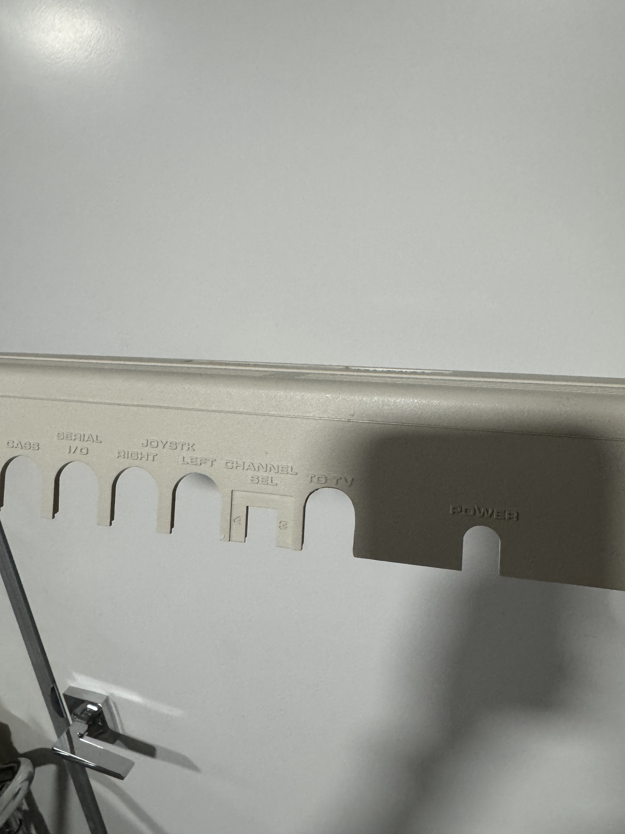
[picture p23: fpga/docs/final-hole.JPG]
Finished enlarged TO TV opening shaped to clear the AVIDEO DIN-5 plug
|  |  |

#### Close the lid and connect the DIN-5 cable

Refit the cover, checking that the internal cables are clear of its edges. The DIN-5 plug should fit through the enlarged opening and seat fully in the AVIDEO socket. The finished installation below shows the closed lid, connected DIN-5 cable, and external keyboard companion.

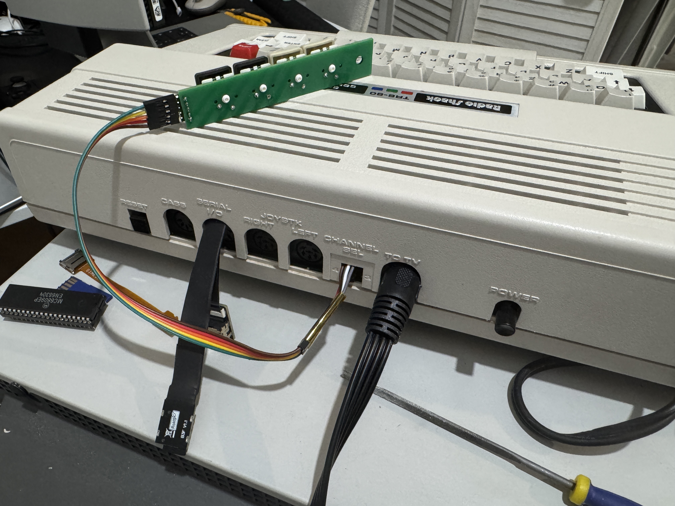
[picture p24: fpga/docs/closed-lid.JPG]
Completed CoCoTANG installation with the lid closed, DIN-5 cable connected through the enlarged TO TV opening, and external keyboard companion attached


### PIA adapter configuration

Both PIAs use the same adapter PCB, but they require different component populations and jumper settings:

- **PIA0:** populate the adapter's logic IC, diodes, and capacitors listed in the PIA0 bill of materials, and set the selection jumper to **PIA0**. The photo below shows PIA0 fitted with the **SC67331P** chip.
- **PIA1:** fit the PIA socket; the additional logic IC, diodes, and capacitors are not required. This adapter brings out only two signal pins. Set its selection jumper to **PIA1**.

The new PIA PCB also includes a pinout for an external keyboard. Populate and connect the external keyboard header **only on PIA0**.

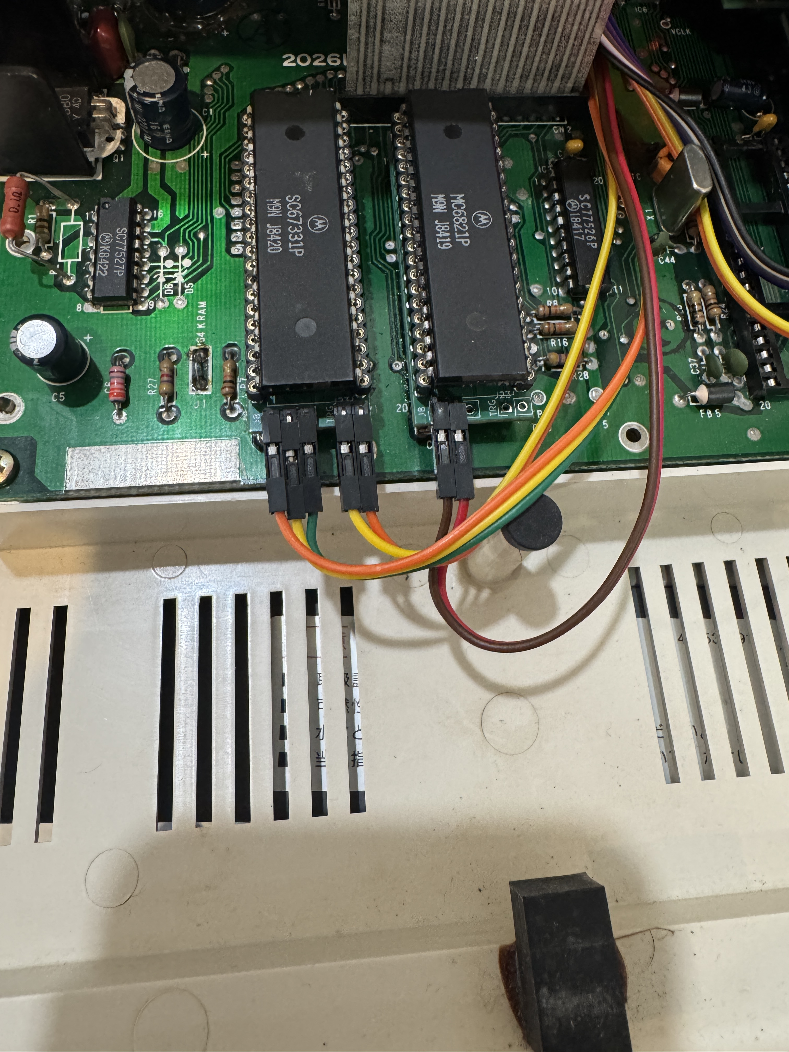
[picture p25: fpga/docs/pias.jpg]
PIA0 and PIA1 adapters showing their installed configuration and wiring


### External keyboard companion

The optional four-key companion board uses **4 Cherry MX key switches**, labeled **CTRL, ALT, F1, and F2**, and connects to the **external keyboard header on PIA0**. The photo shows the assembled companion beside the CoCo 2's built-in keyboard, with its cable attached. The PCB fabrication files are available as [gerber_extkey.zip](kicad/gerber/gerber_extkey.zip).

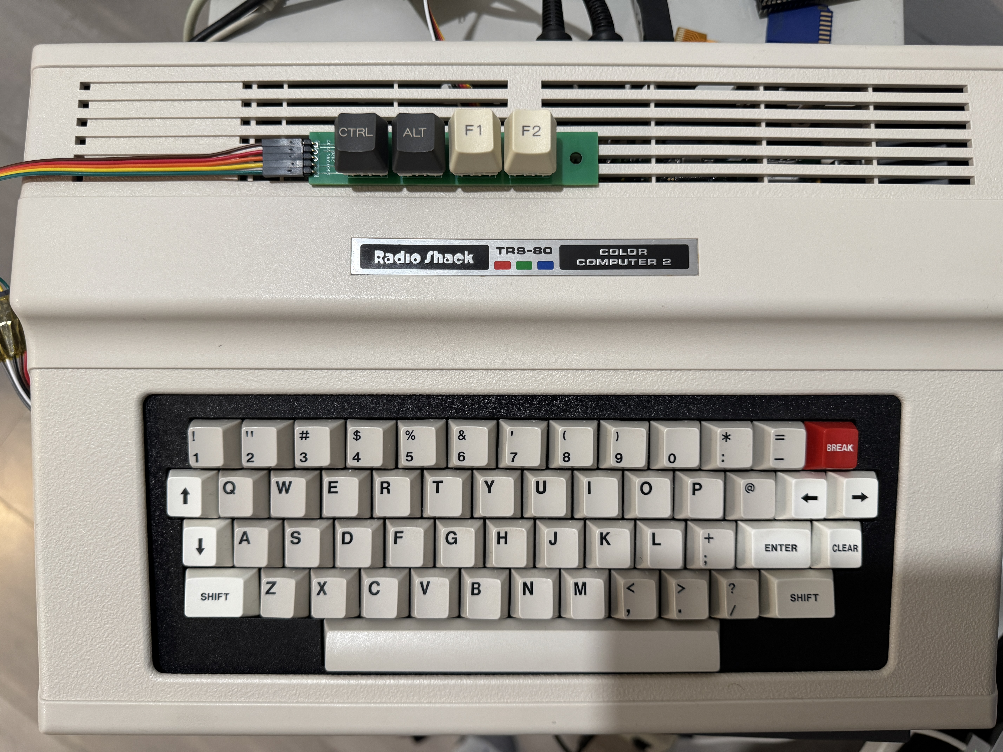
[picture p26: fpga/docs/keyboard-companion.JPG]
Assembled external four-key keyboard companion beside the CoCo 2 keyboard


### Joystick second-button support

To support a second button on each joystick, disconnect **pin 5 of each joystick connector** from its original motherboard ground connection. Desolder the pin, pull it clear of the motherboard, and bend it upward as shown below. Keep the lifted pin clear of its original pad.

Use **two jumper wires**, one from each lifted pin, to connect the joystick second-button signals to the corresponding connections on the **PIA0 adapter (SC67331P in the PIA photo above)**. To attach a jumper lead to a lifted pin, remove the plastic housing at that end and gently widen the metal contact to fit.

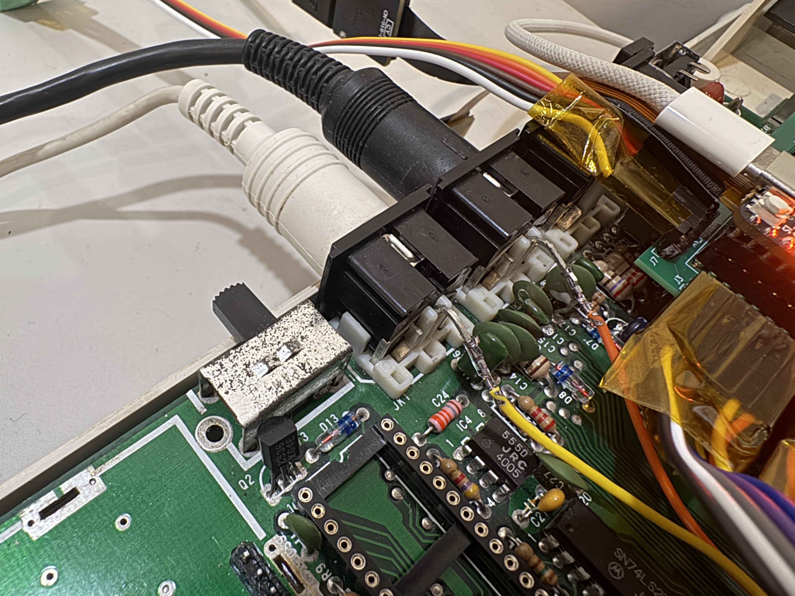
[picture p27: fpga/docs/joy_button.jpg]
Joystick connector pin 5 lifted from the motherboard and connected with jumper wires


## CPU choice: MC6809E or HD6309E

While the CPU is removed, you can replace the MC6809E with an HD6309E. NitrOS-9 supports the HD6309's native mode, and compatible applications can use its additional instructions. Choose the disk image that matches your installed CPU.

## Audio / Video

### HDMI

You can use [this](https://www.aliexpress.com/item/1005002515211106.html) HDMI flat cable to expose the HDMI port outside the CoCo2 case. Being as flat just let it go through some port. Choose a model like A1-A4.

### Audio Video Board

The optional CoCoTANG Audio/Video board provides a 5-pin DIN output and fits in the original RF modulator/shield location. Enlarge the cover opening for the connector and secure the PCB to the motherboard using the rear pin headers shown in the [AVIDEO assembly photos](#avideo-board). Follow the illustrated [mounting and case-opening guide](#avideo-mounting-and-case-opening) to prepare the RF area and enlarge the cover opening.

The revised **J24 DIN-5 connector follows the Atari 800XL monitor pin assignment**, with chroma connected to pin 5. The diagram shows the **female socket viewed from the front**, looking into the connector on the computer, with the keyway at the bottom. The cable plug's mating-face view is mirrored.

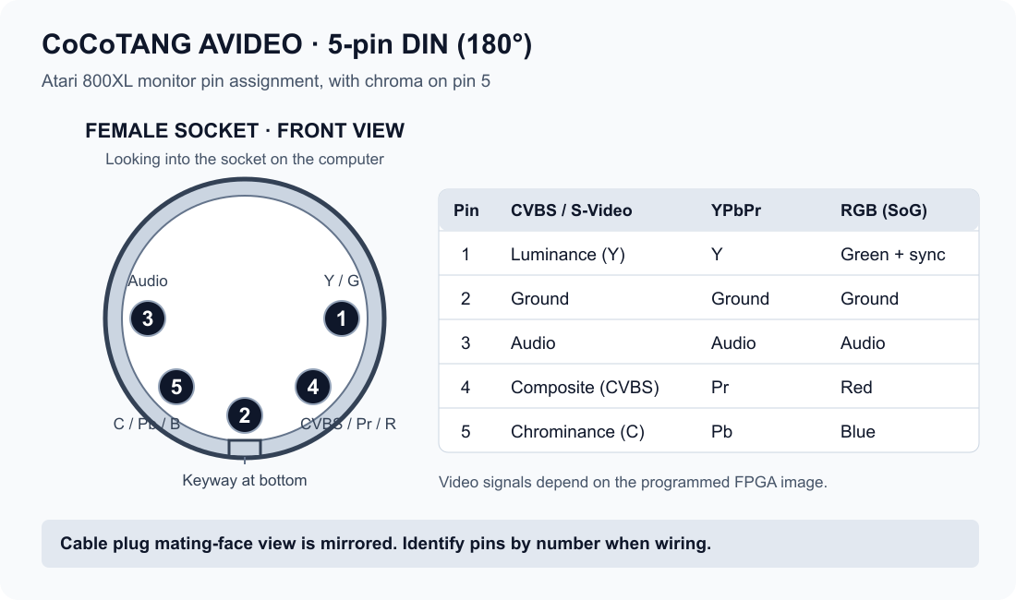
[picture p28: fpga/docs/din5-av-pinout.png]
CoCoTANG DIN-5 pinout: female socket front view, with Atari 800XL-style CVBS/S-Video wiring and YPbPr/RGB assignments


| DIN pin | CVBS / S-Video | YPbPr component | RGB with sync on green |
| --- | --- | --- | --- |
| 1 | Luminance (Y) | Y | Green + sync |
| 2 | Ground | Ground | Ground |
| 3 | Audio | Audio | Audio |
| 4 | Composite video (CVBS) | Pr | Red |
| 5 | Chrominance (C) | Pb | Blue |

Select the matching FPGA video image; the same physical pins carry different signals in each mode. For composite, use pins **4 (video), 3 (audio), and 2 (ground)**. For S-Video, use **1 (Y), 5 (C), and 2 (ground)**, with audio on pin 3.

For an example lead, see this [5-pin DIN to four-RCA cable](https://www.aliexpress.com/item/1005003227813806.html); select the **5-pin version** and verify its wiring against the table above.

Use an Atari 800XL-style monitor cable wired to this table for CVBS/S-Video. RGB and YPbPr need cables wired for their respective columns. Check the actual DIN pin connections rather than relying on RCA plug colors or the connector's pin count. This pinout applies to the revised AVIDEO PCB; check older boards before reusing a cable.

The assignments above match J24's current PCB nets: `1=G_Y`, `2=GND`, `3=AUDIO_RCA`, `4=R_CVBS`, `5=B_CHR`. The diagram's editable source is [din5-av-pinout.svg](fpga/docs/din5-av-pinout.svg). For the Atari monitor-port reference, see the [Atari 800XL service manual](https://www.atarimania.com/documents/Atari%20800XL%20Service%20manual.pdf) and [Atari connector FAQ](https://www.atarimania.com/machines/atari-400-800-xl-xe/faq/16). CoCoTANG supplies chroma on pin 5, which was unconnected on many original 800XL machines.

### Display compatibility and PVM connections

**YPbPr component:** use a TV or monitor that accepts **15 kHz standard-definition 480i/240p signals** over its component inputs, such as a compatible PVM or a CRT TV with YPbPr inputs. Check that the particular display accepts 240p; support for 480i alone does not guarantee it. Connect DIN pin **1 to Y**, **5 to Pb**, and **4 to Pr**, with pin **3 for audio**.

**RGB with sync on green (SoG):** use a cable wired specifically for CoCoTANG's RGB pinout and a display that accepts sync on green. On a compatible PVM, you can instead use the same **5-pin DIN to four-RCA lead** linked above, with **RCA-to-BNC adapters** on the three video leads:

| DIN pin / lead | PVM input |
| --- | --- |
| 1 — Green + sync | G / Y |
| 4 — Red | R / Pr |
| 5 — Blue | B / Pb |
| 3 — Audio | Audio input |

Select **RGB** on the PVM and choose **internal sync (INT)**, or turn **EXT SYNC off**, so it takes sync from green. The fourth RCA lead carries audio; a separate external-sync connection is not needed. For YPbPr, use the same three video connections but select **component / YPbPr** instead. Control names vary by model; see, for example, the [Sony PVM-D14L5A/D20L5A operating instructions](https://pro.sony/s3/cms-static-content/operation-manual/4089510121.pdf).

## Preparing the microSD card

Download the appropriate CPU version of the [microSD disk image](https://drive.google.com/file/d/1VkAMsVHzRIia8T7F_5E-AXlJXhQMgnkP/view?usp=sharing) and write it to the microSD card used by CoCoTANG. These images require HDB-DOS, supplied by the optional cartridge or another supported ROM source.

On Linux, identify and unmount the card, then write the image to the **whole device**, replacing `/dev/sdX` with the correct device path:

```sh
sudo dd if=CF_6309.IMG of=/dev/sdX bs=1M
sync
```

The example uses the HD6309 image. Writing the image replaces the card's contents, so verify the destination device before running the command.

## Artifact colours and SSC sound/speech

The standard build includes the Tandy Speech/Sound Cartridge (SSC) PSG and speech engine. **SSC always starts disabled at cold boot.** Press the CoCo motherboard RESET to advance through these selections:

| RESET presses since cold boot | Status label | SSC PSG and speech |
| --- | --- | --- |
| 0 (cold boot) | `ARTIFACT NORMAL` | Disabled |
| 1 | `ARTIFACT REVERSE` | Disabled |
| 2 | `NO ARTIFACT` | Disabled |
| 3 | `ARTIFACT NORMAL - SSC` | Enabled |
| 4 | `ARTIFACT REVERSE - SSC` | Enabled |
| 5 | `NO ARTIFACT - SSC` | Enabled |

The next RESET returns to `ARTIFACT NORMAL` with SSC disabled. RESET is debounced, and holding it down advances only once. Disabled SSC stays silent, holds both synthesizers in reset, and leaves `$FF7D`/`$FF7E` available to the motherboard/cartridge bus. Software cannot enable SSC by writing its registers while an SSC-off selection is active.

HDMI shows the selected label for about four seconds. The analog banner is optional and **off by default**: set `ENABLE_ANALOG_BANNER=1` in `fpga/src/top_coco3.v` and rebuild to include it. Its font is doubled in both dimensions, with each font row occupying two analog scanlines. This applies to RGB, YPbPr, CVBS, and S-Video; the HDMI label keeps its original size.

When SSC is selected, software resets its interface by writing `1` then `0` to `$FF7D`. `$FF7E` accepts commands/data and returns status; bit 7 high means ready. The implementation supports direct PSG register writes, buffered sound events/register streams, buffered AL2 allophones, and immediate ASCII text terminated by carriage return. English text uses NRL letter-to-sound rules; this is command-level compatibility rather than a TMS7040 CPU emulation. The [speech interface source](fpga/src/audio/coco_ssc_speech.v) documents the supported commands.

PSG and speech are combined and mixed into both HDMI channels and the physical mono output at **1.5× gain (about +3.5 dB)**. The CoCo DAC and Orchestra-90 gains are unchanged. The final sum saturates at the signed PCM limits instead of wrapping, and disabling SSC clamps its contribution to silence.

In custom builds, `ENABLE_SSC_SPEECH=0` removes speech while retaining the PSG; `ENABLE_SSC_PSG=0` removes both SSC engines and restores the three artifact-only reset selections. `make test-ssc-toggle` checks the real top-level reset cycle, disabled bus/audio behavior, and both analog-banner settings using Gowin's installed simulation library.

## Orchestra-90 audio

Orchestra-90 audio is enabled by default and provides two 8-bit DACs without the cartridge ROM. Software writes unsigned samples to **`$FF7A` (left)** and **`$FF7B` (right)**; `128` is the digital midpoint. Each channel holds its last sample until the next write. These are write-only DACs: reading the addresses does not change their values or provide readback.

Orchestra-90 requires no additional cartridge ROM or audio hardware. It is enabled by default in every normal machine image; no separate Orchestra-90 build is needed.

HDMI sends stereo PCM at 48 kHz. The existing CoCo PIA DAC is mixed equally into both channels at its normal gain; each Orchestra-90 DAC contributes at half gain, and the mixer clips at the signed PCM limits to prevent overflow. Both Orchestra-90 channels reset to the midpoint so they contribute silence before software uses them. The analog `audio_out` pin carries a mono mix of both Orchestra-90 channels and the CoCo PIA DAC. Each Orchestra-90 channel contributes at quarter gain to this downmix, while the CoCo PIA DAC keeps its normal gain; the sum is clipped before conversion to the physical 8-bit sigma-delta DAC.

To omit Orchestra-90 audio in a custom build, set the `top_coco3` parameter `ENABLE_ORCHESTRA90=0`. Address and channel assignments follow [XRoar's Orchestra-90 documentation](https://www.6809.org.uk/xroar/doc/xroar.shtml#Orchestra-90_002dCC-sound-cartridge) and [MAME's Orchestra-90 implementation](https://github.com/mamedev/mame/blob/master/src/devices/bus/coco/coco_orch90.cpp).

## Build on macOS or Linux

1. Download **GOWIN EDA Education** for your OS from [Gowin's official download page](https://www.gowinsemi.com/en/support/download_eda/) (an account may be required). Install the full EDA package, not only Gowin Programmer. The Education edition is intended for noncommercial education/research; check Gowin's current terms for your use.
2. Install [openFPGALoader](https://trabucayre.github.io/openFPGALoader/guide/install.html) and, for simulation, Icarus Verilog (`iverilog` and `vvp`). On macOS, `brew install openfpgaloader icarus-verilog` is one option. On Debian/Ubuntu, `sudo apt install openfpgaloader iverilog` is one option. Linux may also need the [openFPGALoader udev rules](https://trabucayre.github.io/openFPGALoader/guide/install.html) for non-root USB access.
3. From the FPGA directory, build and check the routed design:

   ```sh
   cd fpga
   make test
   make rebuild
   make timing
   ```

   `make test` is optional for building the bitstream. Its current recipes write simulation executables to `/private/tmp`, so on Linux that directory must exist and be writable if you run the tests; `make rebuild` and `make timing` do not need it.

The output is [`fpga/impl/pnr/CoCoTANG.fs`](fpga/impl/pnr/CoCoTANG.fs). `make rebuild` always runs synthesis and place-and-route; `make build` rebuilds only when Make considers an input newer than the bitstream. The Makefile expects Gowin at `/Applications/GowinIDE.app/Contents/Resources/Gowin_EDA/IDE` on macOS or `/opt/Gowin/IDE` on Linux. If yours is elsewhere, pass `GOWIN_IDE=/path/to/Gowin_EDA/IDE` to Make.

### Select an analog video output

Each mode has its own bitstream and fixed video-mode setting, independent of the default `ANALOG_VIDEO_MODE` in `src/top_coco3.v`:

| Output | Build if needed and program | Program existing image | Bitstream in `fpga/impl/pnr/` |
| --- | --- | --- | --- |
| RGB with sync on green | `make program-rgb` | `make reprogram-rgb` | `CoCoTANG-rgb.fs` |
| YPbPr component | `make program-ypbpr` | `make reprogram-ypbpr` | `CoCoTANG-ypbpr.fs` |
| NTSC CVBS and S-Video | `make program-cvbs` | `make reprogram-cvbs` | `CoCoTANG-cvbs-minimal.fs` |

Run these commands from `fpga/`. To build without programming, use `make build-rgb`, `make build-ypbpr`, or `make build-cvbs`. Use `make rebuild-rgb`, `make rebuild-ypbpr`, or `make rebuild-cvbs` to force a rebuild, and the corresponding `make timing-rgb`, `make timing-ypbpr`, or `make timing-cvbs` to check the routed timing. The `reprogram-*` targets never rebuild; their named image must already exist.

The artifact/SSC status banner is off on analog outputs by default. Set `ENABLE_ANALOG_BANNER=1` in `fpga/src/top_coco3.v` and rebuild to enable its larger font in any analog video mode. The HDMI status label and reset selector are always available.

### Rebuild every variation

Run these commands from `fpga/`:

```sh
make build-all     # build missing or outdated images
make rebuild-all   # force synthesis and place-and-route for every image
```

Both targets cover six images: standard, RGB, YPbPr, CVBS/S-Video, PAL, and the standalone bus tester. The NTSC S-Video targets share the confirmed CVBS image, so it is built once. Logger/debug images are excluded.

Builds run sequentially, even with `make -j`, because Gowin shares the `impl/` directory between projects. Every variant is attempted, and routed timing is checked after each successful build. The target returns a failure status if any build or timing check fails; it never programs the board or changes placement settings. Per-variant logs and `summary.json` are written to `fpga/impl/build-all/` or `fpga/impl/rebuild-all/`.

### Debug and bus testing

The standalone bus tester is included in the aggregate builds. The normal production images keep the bus logger disabled; logger/debug projects are not restored by the aggregate targets.

For board bring-up, `make data-test-program-sram` builds the standalone bus tester if needed and loads it into FPGA SRAM for a temporary test. Use `make data-test-program` to store the tester in flash. It holds the CPU in reset and displays the data sweep and bus readback over HDMI. See the [bus tester notes](fpga/docs/pinout.md#standalone-bus-tester) for controls and verification commands.

## Program on macOS or Linux

Connect the Tang Nano 20K by USB. The FPGA configuration and CoCo 3 ROM are **two separate writes** to the module's external SPI flash:

| Flash address | Contents | Command from `fpga/` |
| --- | --- | --- |
| `0x000000` | FPGA configuration (`impl/pnr/CoCoTANG.fs`) | `make program` or `make reprogram` |
| `0x100000` (1,048,576 decimal) | 32 KiB CoCo 3 ROM (`roms/coco3.rom`) | `make rom` |

```sh
cd fpga
make program     # builds if needed, then writes persistent FPGA configuration
make rom         # writes the ROM at 0x100000; needed for first setup
```

`make reprogram` flashes the existing bitstream without rebuilding. These Make targets use [openFPGALoader's `tangnano20k` board support](https://trabucayre.github.io/openFPGALoader/vendors/gowin.html). The ROM offset is set by `ROM_OFFSET=1048576` in the Makefile and by the FPGA flash loader; **do not write the ROM at address zero**, or it will overwrite the FPGA configuration. After both writes, power-cycle the board. The FPGA holds the CPU until its clocks, SDRAM, and ROM load are ready.

### Test the bus and addresses in SRAM

Run `make data-test-program-sram` from `fpga/` to build the standalone bus tester if needed and load `CoCoTANG-data-test.fs` into the FPGA's volatile SRAM. The tester holds the CPU in reset and displays the data sweep, address bus readback, and control signals over HDMI. It does not need a CoCo 3 ROM.

This leaves the stored FPGA configuration and ROM unchanged. Power-cycling restores the configuration stored in flash.

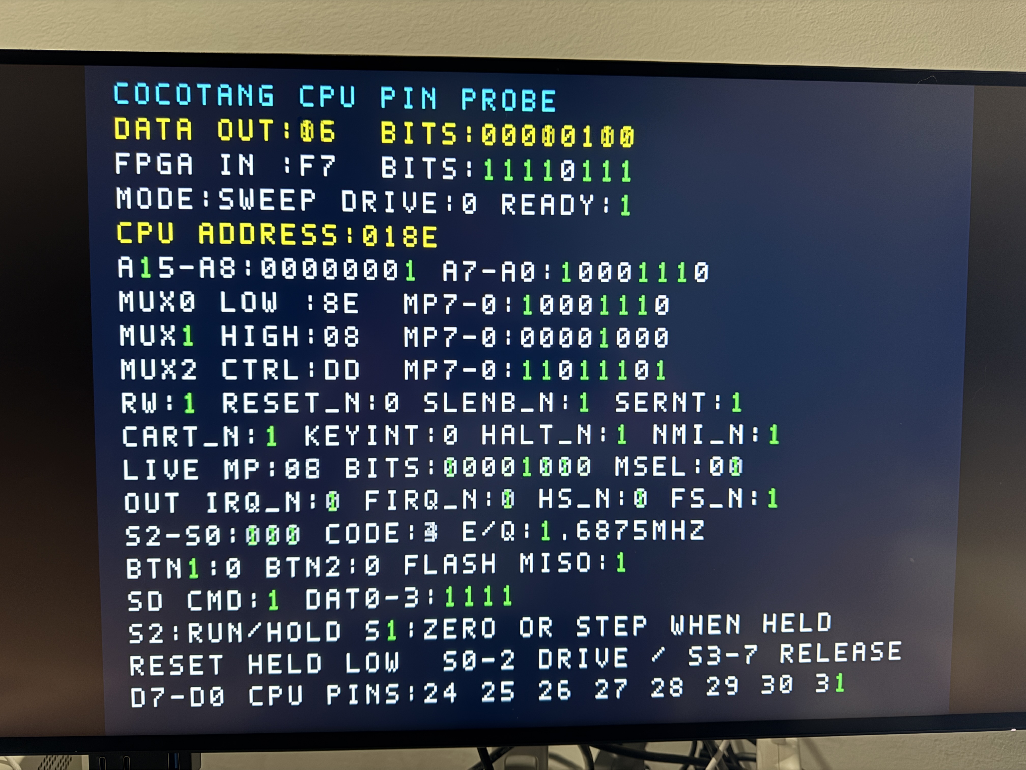
[picture p29: fpga/docs/test-program.jpg]
CoCoTANG standalone bus tester showing data, address, and control signal readback over HDMI


#### Using the tester to diagnose the board

The tester helps locate missing connections, solder bridges, swapped bus lines, and faults in the bus buffers or address mux. `FPGA IN` shows the data bus at the FPGA side of the data transceiver. `CPU ADDRESS` and the `A15–A8` / `A7–A0` fields show the address sampled through the mux; the tester reads these lines rather than driving them.

Use the Tang Nano's **S2** button to switch between sweep and hold. In hold mode, **S1** advances the data byte and S code by one; in sweep mode, S1 restarts both at zero. The S code controls motherboard device selection, so hold mode is useful when probing a fixed condition.

**Prepare for manual pin testing:** turn off the computer and remove the CPU before attaching jumpers. Removing it lets you set each address line independently without fighting the CPU's outputs. Make connections on the CPU/motherboard side of the adapters, using motherboard ground and the board's normal logic levels; do not apply 5 V directly to Tang Nano pins.

**Test each data line:**

1. Load the tester with `make data-test-program-sram` and connect HDMI.
2. Ground **R/W** for manual data-input testing. Check that the screen shows `RW:0` and `DRIVE:0` before grounding any data pin. R/W low releases the FPGA's data outputs and selects the input direction through the data transceiver.
3. With the other data inputs at a known high level through suitable pull-ups, ground **D0** and check that only bit 0 of `FPGA IN` goes low. The expected byte is `$FE`.
4. Move the ground connection to D1 through D7, one pin at a time. The expected bytes are `$FD`, `$FB`, `$F7`, `$EF`, `$DF`, `$BF`, and `$7F`. Remove each connection before testing the next pin. These values assume all ungrounded data lines remain high; floating inputs are not a reliable reference.

`DATA OUT` is the sweep generator's requested byte. While `DRIVE:0`, it is not being driven onto the data bus, so it does not need to match `FPGA IN`. A pin that does not change its displayed bit suggests an open connection or buffer problem; a different bit changing suggests swapped wiring, and two bits changing together suggests a short.

**Test each address line:**

1. Keep the CPU removed and R/W grounded. Establish known levels on A0–A15 using the board's pull-ups or suitable test pull-ups.
2. Ground **A0**, then A1 through A15, one at a time. Check that only the corresponding bit changes in `CPU ADDRESS` and the address bit fields. With all other address lines high, grounding A0 gives `$FFFE`, grounding A1 gives `$FFFD`, and grounding A15 gives `$7FFF`.
3. Check `MUX0 LOW` for A0–A7 and `MUX1 HIGH` for A8–A15. The high-address mux uses a remapped bit order; use the decoded address fields to identify CPU address bits.

A line that never changes can indicate an open joint, missing connection, or buffer/mux fault. An unexpected address bit changing can indicate incorrect wiring or an address-remap problem. The display shows the FPGA's sampled result; a meter or logic analyzer at the CPU socket and buffer pins helps locate where the signal is lost.

Turn off the computer before removing the test jumpers or reinstalling the CPU. Remove the R/W ground connection before returning to normal operation. Power-cycling also restores the FPGA image stored in flash.

## Windows: Gowin Programmer

For Windows, use the [Gowin Programmer](https://www.gowinsemi.com/en/support/download_eda/) supplied with Gowin EDA Education (or Gowin's standalone Programmer). The repository's Makefile is written for macOS/Linux and uses `openFPGALoader`; it is not a native Windows programming recipe. Gowin's [Programmer User Guide](https://www.gowinsemi.com/en/document/main/database/14/) describes the device-configuration dialog.

1. Install Gowin's USB programmer driver, connect the Tang Nano 20K, and open **Gowin Programmer**. Scan the cable/device; the board uses a GW2AR-18C in a QN88 package.
2. To test without preserving the configuration after power-off, choose **SRAM Mode → SRAM Program** and select `fpga/impl/pnr/CoCoTANG.fs`.
3. To make the FPGA configuration persistent, open **Edit → Configure Device**, choose **External Flash Mode**, select **exFlash Erase, Program thru GAO-Bridge** (or its verify variant), choose `fpga/impl/pnr/CoCoTANG.fs`, set **External Flash Options → Start Address** to `0x000000`, save, then click **Program/Configure**.
4. Program the ROM as a **separate raw binary** operation: configure **External Flash Mode**, choose **exFlash C Bin Erase, Program thru GAO-Bridge** (or its verify variant), select `fpga/roms/coco3.rom` under **FW/MCU/Binary Input Options → Firmware/Binary File**, choose **Generic Flash** if a flash-device choice is required, and set **External Flash Options → Start Address** to **`0x100000`**. Save and program. The dialog wording varies between Gowin releases; the important distinction is the raw-binary operation and the 1 MiB start address.
5. Power-cycle the board. If the FPGA configures but the CPU does not start, recheck the ROM write and its offset.

**Windows USB driver choice:** Gowin Programmer and openFPGALoader may require different USB drivers. The normal Windows path above uses Gowin's driver. If you choose to use openFPGALoader on Windows instead, install its Windows build and use [Zadig](https://zadig.akeo.ie/) to bind **WinUSB** to the Tang Nano 20K's *programming/JTAG interface* (enable **Options → List All Devices** if necessary). Check the device/interface identity before clicking **Install/Replace Driver**—do not replace an unrelated USB interface. Switching to WinUSB can stop Gowin Programmer from seeing the board; restore the Gowin driver in Device Manager or reinstall it when returning to Gowin Programmer. [libusb's Windows guidance](https://github.com/libusb/libusb/wiki/Windows) recommends WinUSB for libusb applications.

## Troubleshooting

### Green screen

If CoCoTANG shows a green screen, check that you have programmed the CoCo 3 ROM with `make rom`. Run this command from the `fpga/` directory, then power-cycle the board:

```sh
make rom
```

A faulty **74LVC245 bus buffer** or a poor connection on the data or address bus can also cause a green screen. If programming the ROM does not resolve it:

1. With power off, inspect all data and address bus connections, especially the LVC245 pins, for solder bridges, unsoldered pins, and poor solder joints.
2. Follow the [KiCad schematics](kicad/) and check continuity along each bus line through the sockets, adapters, buffers, and interconnecting cables. Check for shorts between adjacent lines as well as missing connections.
3. Run the SRAM diagnostic from `fpga/` with `make data-test-program-sram`. Follow the [bus and address test procedure](#using-the-tester-to-diagnose-the-board), including its CPU-removal and jumper instructions, to verify **every data line D0–D7 and address line A0–A15 individually**. Each line must change only its corresponding bit in the HDMI readback.
4. If a line fails, trace it through the circuit to locate the open connection, short, or faulty LVC245 buffer. Repair the fault and repeat the test.

### CoCo SDC failures

If the CoCo SDC fails to work reliably, check the CPU's speed rating against the operating clock speed. Try a different CPU, such as an **MC68B09E** or **HD6309E**, using the externally clocked E variant required by the motherboard. See [CPU choice](#cpu-choice-mc6809e-or-hd6309e).

## Project status

This is an actively developed hardware/RTL project. Review the [pin and bus map](fpga/docs/pinout.md), fabrication drawing, and KiCad files before building hardware. Flashing a new FPGA image or ROM changes the board's nonvolatile contents; keep a known-good image available while experimenting.

## Showcase

CoCo 1 booting and running NitrOS-9 with CoCoTANG and the decoupling modification shown above:

| CoCo 1 boot | CoCo 1 NitrOS-9 Level 2 |
| --- | --- |
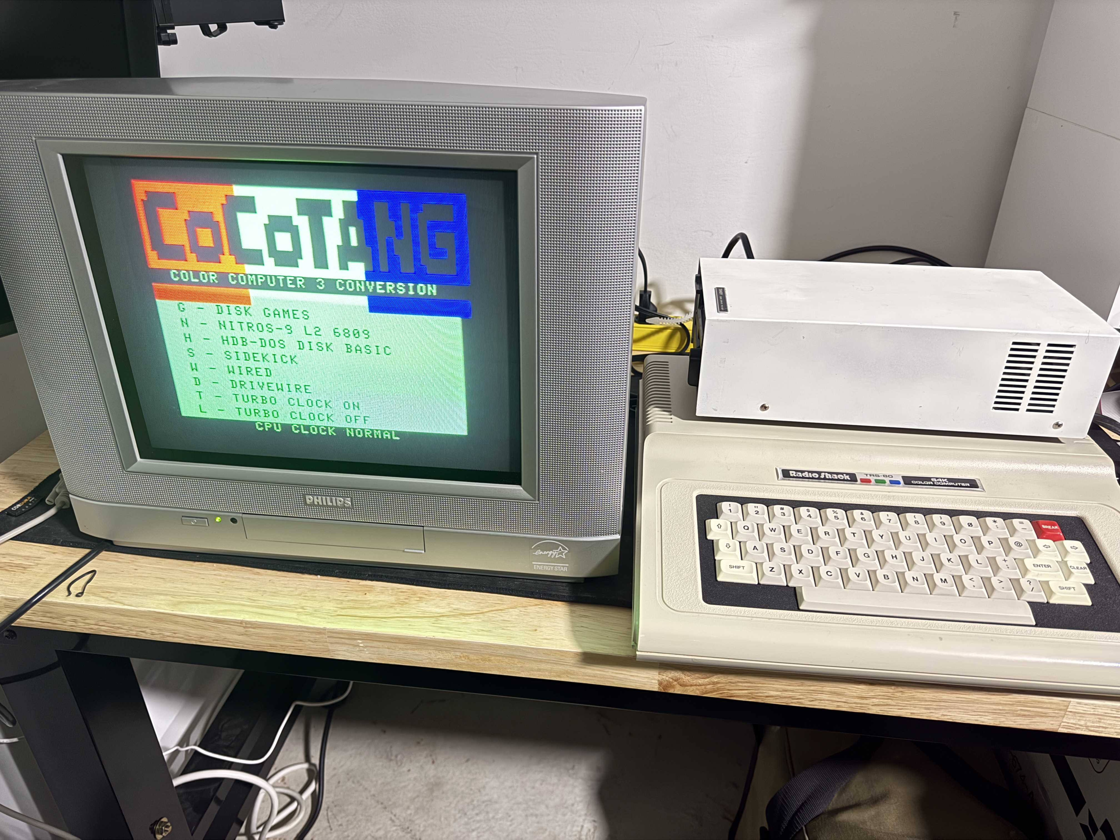
[picture p30: fpga/docs/coco1-boot-screen.JPG]
CoCo 1 boot screen with CoCoTANG
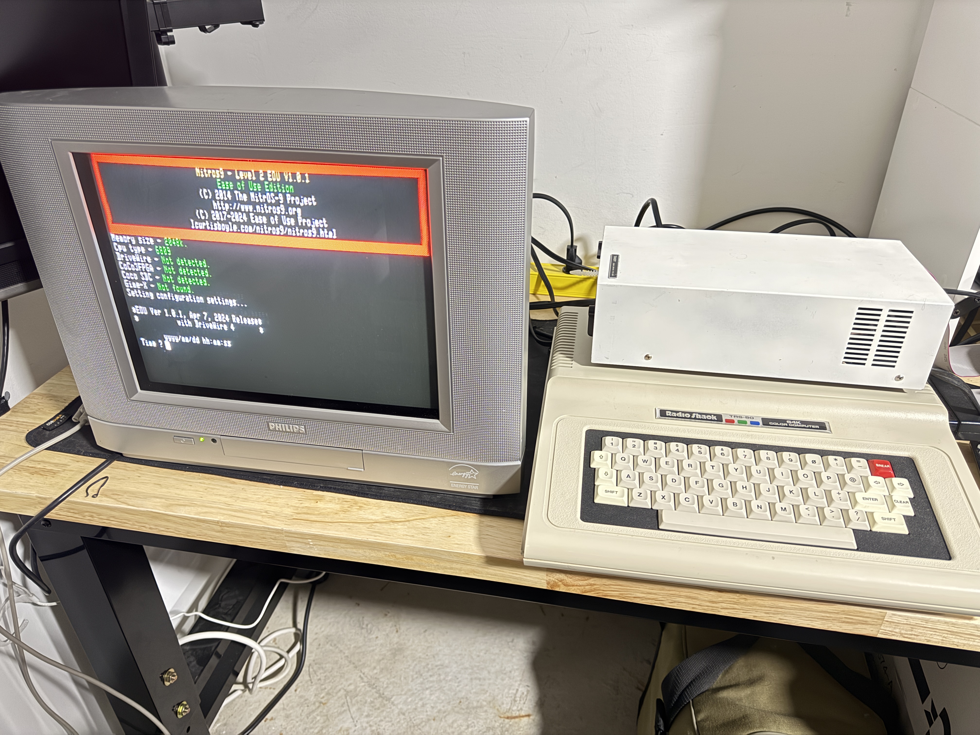
[picture p31: fpga/docs/coco1-nos9l2.JPG]
CoCo 1 running NitrOS-9 Level 2 with CoCoTANG
|  |  |

Games, NitrOS-9, and a graphics demo running on CoCoTANG:

| Calixto Island | Contras |
| --- | --- |
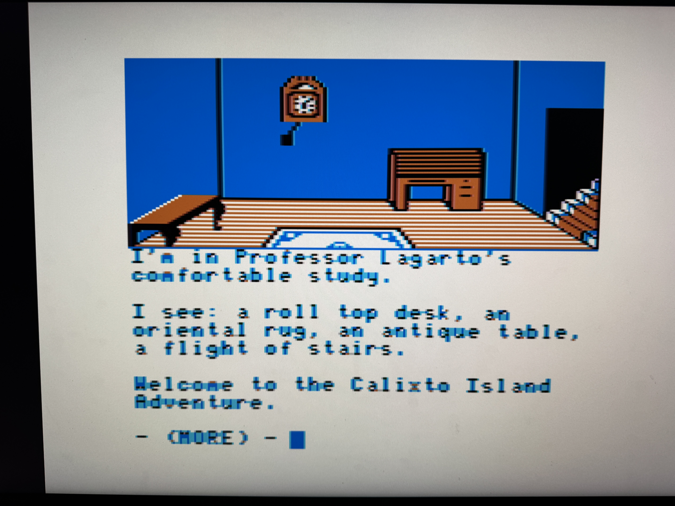
[picture p32: fpga/docs/calixto.JPG]
Calixto Island adventure running on CoCoTANG
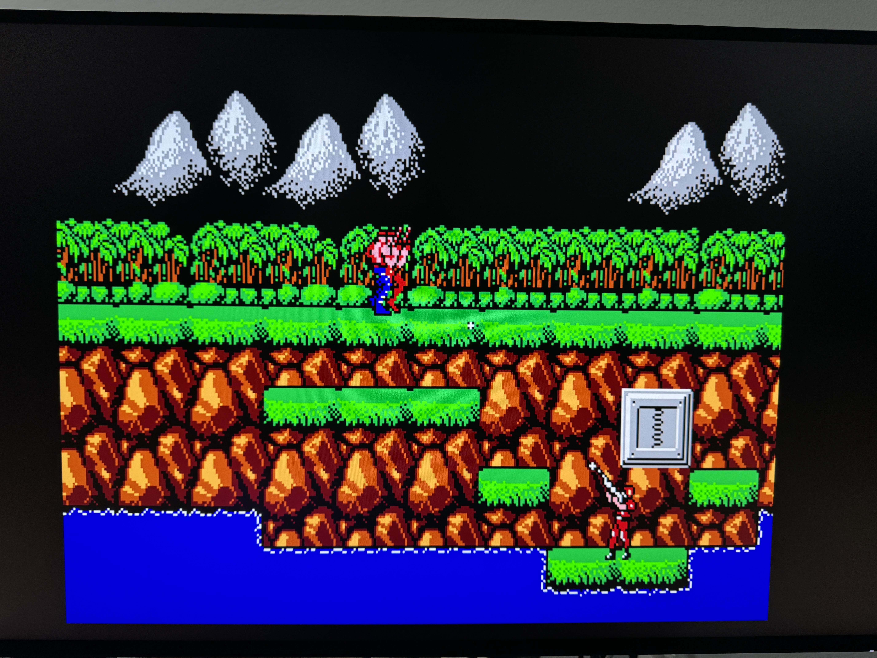
[picture p33: fpga/docs/contras.JPG]
Contras gameplay running on CoCoTANG
|  |  |

| NitrOS-9 | Sock Master's Drive Thru demo |
| --- | --- |
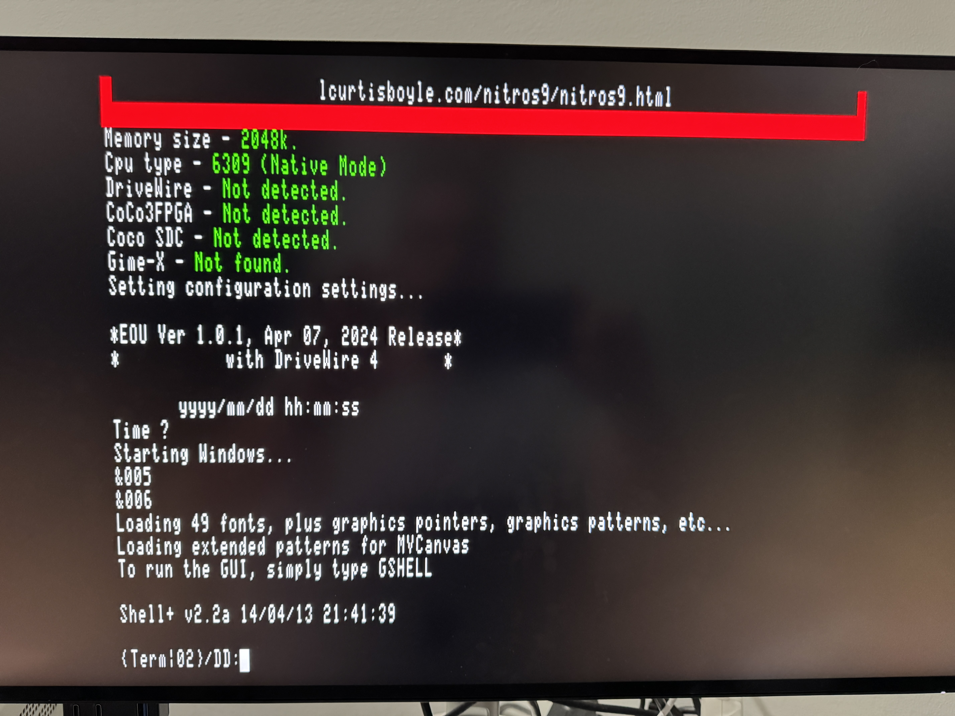
[picture p34: fpga/docs/nitros9.JPG]
NitrOS-9 EOU running on CoCoTANG with a 6309 CPU in native mode
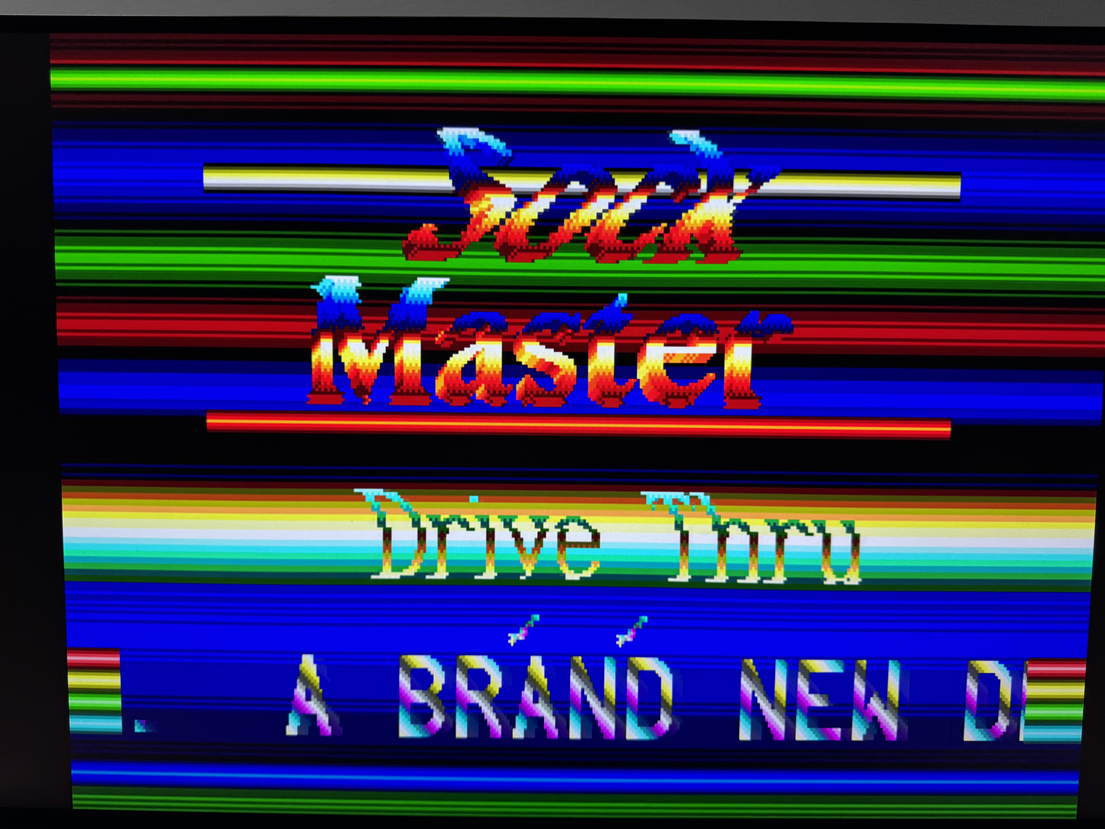
[picture p35: fpga/docs/sockdemo.JPG]
Sock Master's colorful Drive Thru graphics demo running on CoCoTANG
|  |  |
