lfantoniosi/CoCoTANG/fpga/docs/5-pin-din.jpg

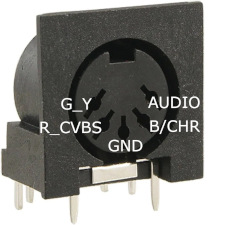
fpga/docs/5-pin-din.jpg
