lfantoniosi/CoCoTANG/fpga/docs/20261043.jpg

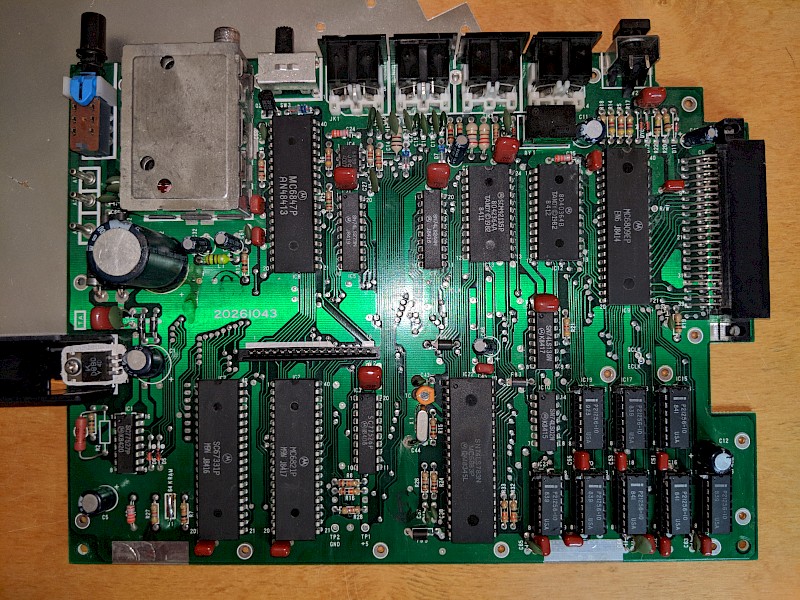
fpga/docs/20261043.jpg
