lfantoniosi/CoCoTANG/fpga/docs/20261044.jpg

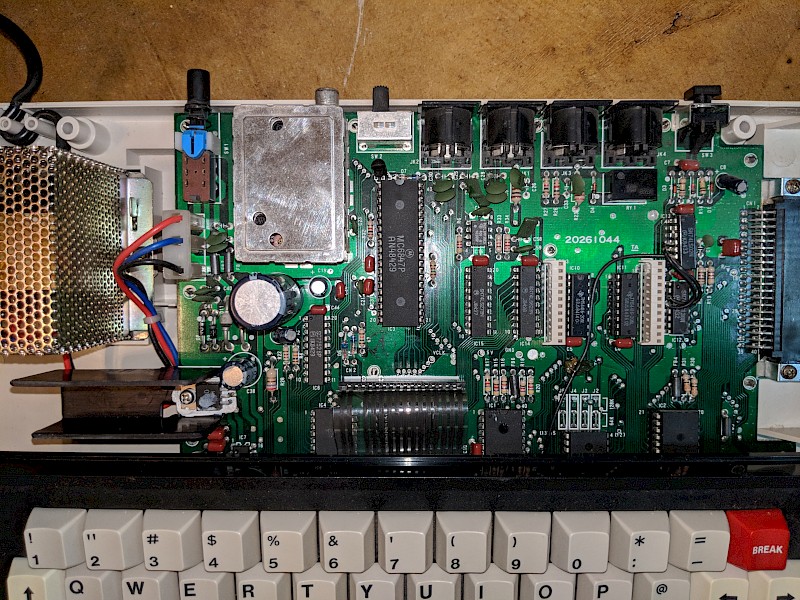
fpga/docs/20261044.jpg
