lfantoniosi/CoCoTANG/fpga/docs/20261045.jpg

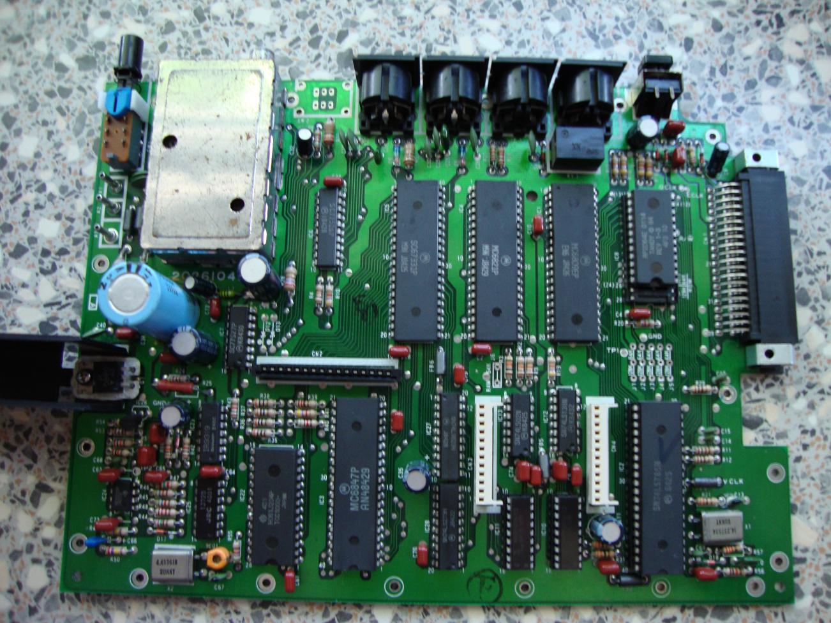
fpga/docs/20261045.jpg
