lfantoniosi/CoCoTANG/fpga/docs/20261058.jpg

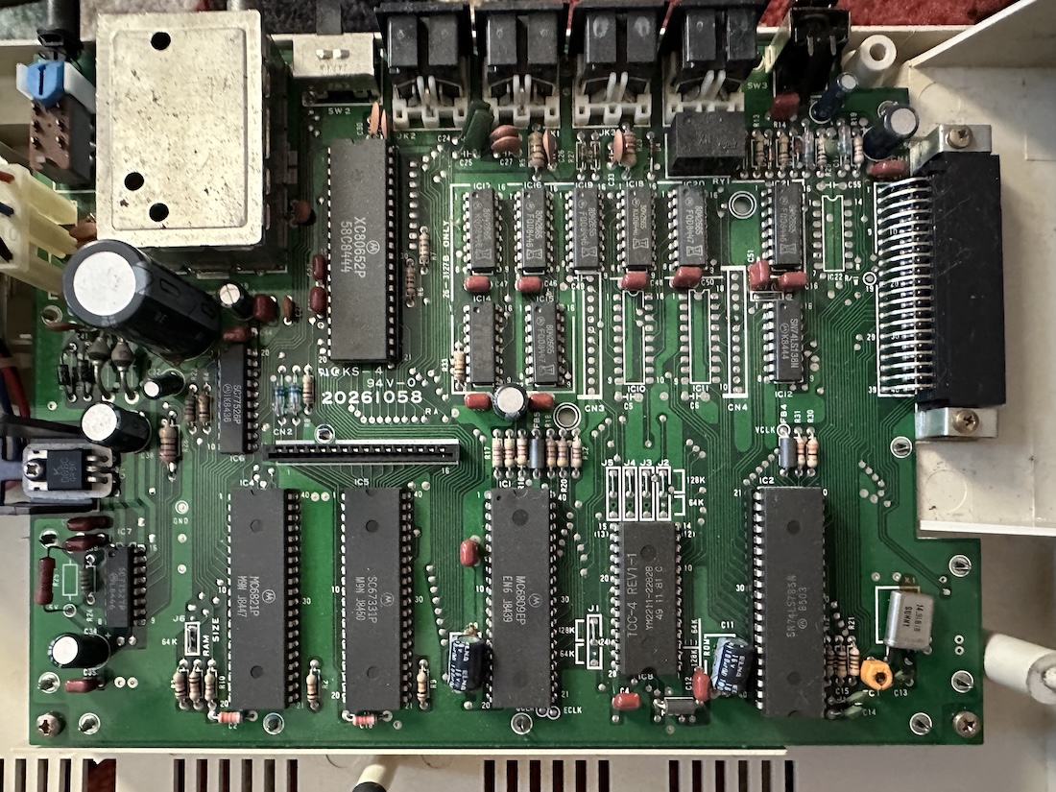
fpga/docs/20261058.jpg
