lfantoniosi/CoCoTANG/fpga/docs/20261059.jpg

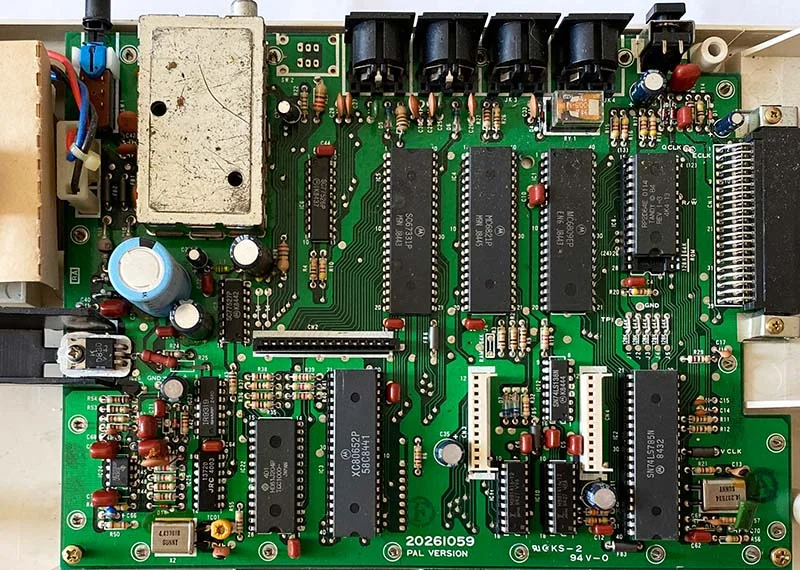
fpga/docs/20261059.jpg
