lfantoniosi/CoCoTANG/fpga/docs/cp400-II.jpg

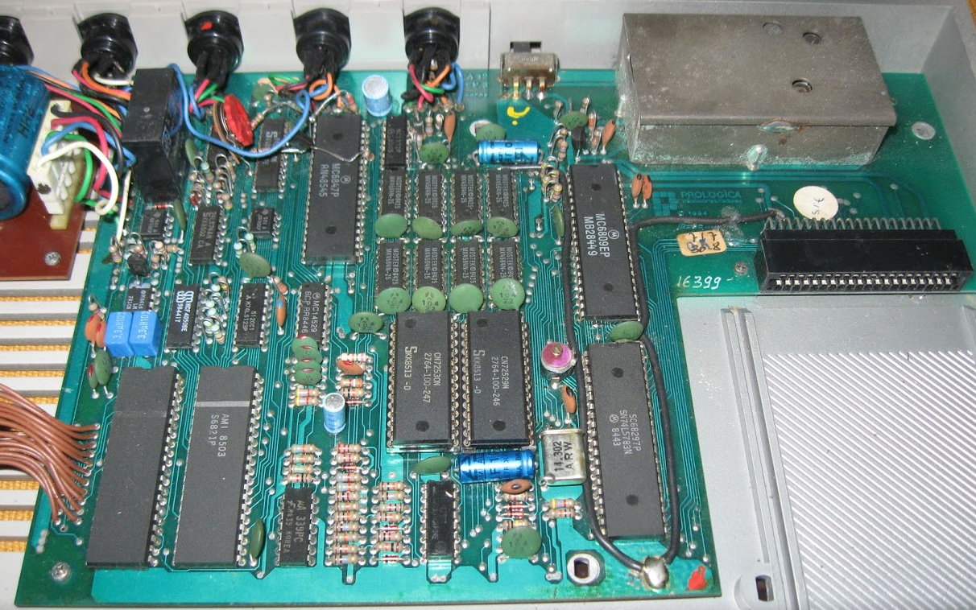
fpga/docs/cp400-II.jpg
