lfantoniosi/CoCoTANG/fpga/docs/IMG_6913.JPG

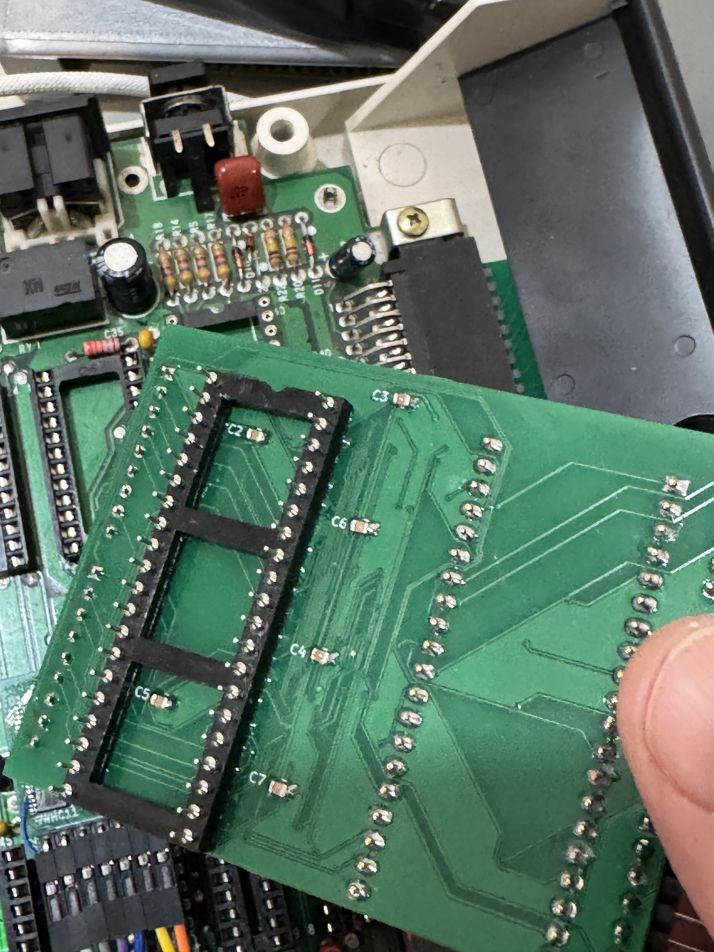
fpga/docs/IMG_6913.JPG
