lfantoniosi/CoCoTANG/fpga/docs/stacking-multiple.JPG

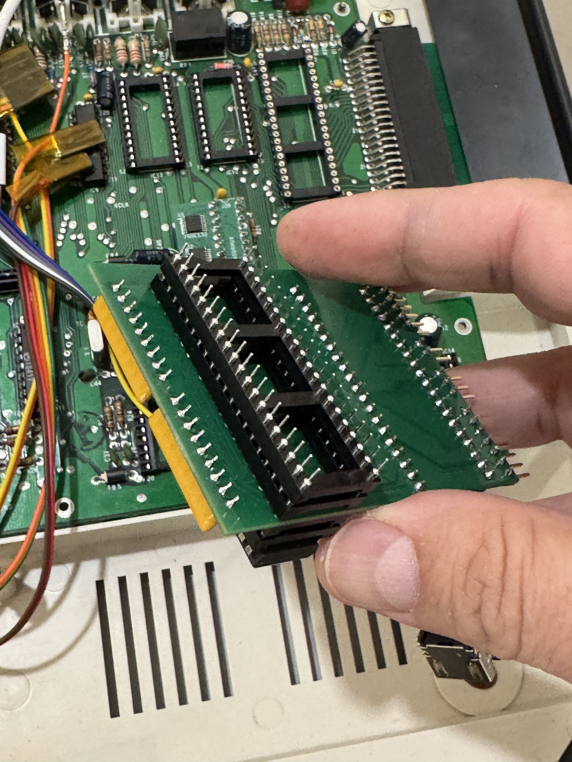
fpga/docs/stacking-multiple.JPG
