lfantoniosi/CoCoTANG/bom/BOM.txt

Qty	Value	Description	DigiKey P/N	References	AliExpress Link
16	0.1uF	CAP CER 0805 0.1UF 100VDC X7R	399-C0805F104K1RACAUTOCT-ND	C1,C2,C3,C4,C5,C6,C7,C26,C27,C28,C29,C30,C31,C32,C33,C34	
6	470pF	CAP CER 470PF 50V C0G/NP0 0805	490-1617-1-ND	C8,C9,C11,C13,C14,C16	
1	1uF	CAP CER 1UF 25V X7R 0805	399-C0805C105K3RACTUCT-ND	C15	
2	6.8nF	CAP CER 6800PF 250V C0G/NP0 0805	490-GCM21B5C2E682JX0ALCT-ND	C22,C24	
2	4.7uF	CAP CER 4.7UF 16V X7R 0805	732-7666-1-ND	C23,C25	
2	SD103BW	DIODE SCHOTTKY 30V 0.35A SOD123F	4878-SD103BWCT-ND	D1,D3	
1	SS14	DIODE SCHOTTKY 40V 1A DO214AC	SS14CT-ND	D2	
14	1K	RES 1K OHM 1% 1/8W 0805	541-3977-1-ND	R1,R16,R17,R18,R23,R25,R27,R29,R31,R33,R35,R37,R38,R39	
3	10K	RES 10K OHM 1% 1/8W 0805	311-10.0KCRCT-ND	R2,R4,R6	
9	4.7K	RES 4.7K OHM 1% 1/8W 0805	311-4.70KCRCT-ND	R3,R5,R7,R26,R28,R30,R32,R34,R36	
2	47K	RES SMD 47K OHM 1% 1/8W 0805	YAG3735CT-ND	R8,R9	
6	75	RES 75 OHM 1% 1/8W 0805	541-CRCW080575R0FKEACCT-ND	R10,R11,R12,R13,R14,R15	
2	100K	RES 100K OHM 1% 1/8W 0805	541-3978-1-ND	R22,R24	
9	MMBT3904-TP	TRANS NPN 40V 0.2A SOT-23	MMBT3904TPMSCT-ND	Q1,Q2,Q3,Q4,Q5,Q6,Q7,Q8,Q9	
1	SN74HC138PWR	IC DECODER/DEMUX 1X3:8 16-TSSOP	296-8228-1-ND	U1	
1	74HC139	IC DECODER/DEMUX 1X2:4 16-TSSOP	1727-6580-1-ND	U3	
1	Tang Nano 20K	Tang Nano 20K FPGA Board	N/A	U5	https://www.aliexpress.com/item/1005010280135538.html
1	74HC30	IC NAND 1-CIR 8-IN 14-TSSOP	1727-6596-1-ND	U7	
4	SN74LVC245AN	IC TXRX 1.65V/3.6V 20-TSSOP	296-1233-1-ND	U8,U10,U11,U12	
1	SN74HC245PWR	IC TXRX 2V/6V 20-TSSOP	296-8279-1-ND	U9	
1	74HC11	IC AND 3-CIR 3-IN 14-TSSOP	296-13611-1-ND	U22	
3	CABLE FFC/FPC 40POS 0.5MM 8"	CABLE FFC/FPC 40POS 0.5MM 8"	WM19595-ND	J2,J22,J26,J24,J29,J8	https://www.aliexpress.com/item/1005007302750085.html
1	CABLE FFC/FPC 16POS 0.5MM 8"	CABLE FFC/FPC 16POS 0.5MM 8"	0151660176-ND	J11,J10	https://www.aliexpress.com/item/1005007302750085.html
1	DIP-16 SOCKET	CONN IC DIP SOCKET 16POS GOLD	SA163000	74LS138	
6	ZIF-CONN 40 POS	CONN FFC FPC 40POS 0.5MM R/A	2987-CF4240FH0R0-05-NHCT-ND	J2,J22,J26,J24,J29,J8	
2	ZIF-CONN 16 POS	CONN FFC FPC 16POS 0.5MM R/A	2987-CF4216FH0R0-05-NHCT-ND	J11,J10	
6	DIP-40 SOCKET	MACHINE PIN SOCKET, IC, DIP, 40P	ICM-640-1-GT-HT	J1,J4,J5,PIA0,PIA1,CPU	https://www.aliexpress.com/item/1005006139495909.html
1	SIL FEMALE HDR	MACHINE PIN SOCKET 40P 2.54MM PI	SMC-1A-40-1-GT-HT	U5	https://www.aliexpress.com/item/1005008648234734.html
8	SIL HEADER	CONN SIL HDR MALE PIN 20POS 	D01-9922046	J9,12,J13,U5	https://www.aliexpress.com/item/1005007563971977.html
2	SIL MALE HEADER	CONN HDR .100" 8POS	TS-108-T-A-1	J28	https://www.aliexpress.com/item/1005007563971977.html
1	AT28C64B-15PU	IC EEPROM 64KBIT PARALLEL 28DIP	AT28C64B-15PU-ND	U2	
1	DIP-28 SOCKET	CONN IC DIP SOCKET 28POS GOLD	110-41-628-41-001000	U2	
1	5-PIN DIN	RECEPTACLE - DIN 5 PIN FEMALE -	NYS325		
1	JUMPER CABLES FEMALE HDR	SET OF MALE-FEMALE CABLES, 40 PI	555035		
1	HEADER PINS RIGHT ANGLE	CONN HEADER R/A 40POS 	PEC36SBAN		https://www.aliexpress.com/item/1005006181766297.html
