lfantoniosi/CoCoTANG/bom/2026-09-24T173707.csv

Index | Quantity | Part Number | Manufacturer Part Number | Description | Unit of Measure | Customer Reference | Available | Backorder | Unit Price | Extended Price CAD
1 | 5 | 296-13611-1-ND | SN74HC11PWR | IC AND 3-CIR 3-IN 14-TSSOP |  |  | 5 | 0 | 0.64000 | $3.20
2 | 10 | 296-8279-1-ND | SN74HC245PWR | IC TXRX 2V/6V 20-TSSOP |  |  | 10 | 0 | 0.98300 | $9.83
3 | 2 | WM1443CT-ND | 5034801600 | CONN FFC FPC 16POS 0.5MM R/A |  |  | 2 | 0 | 2.42000 | $4.84
4 | 6 | WM19595-ND | 0151660440 | CABLE FFC/FPC 40POS 0.5MM 8" |  |  | 6 | 0 | 5.95000 | $35.70
5 | 2 | 0151660176-ND | 0151660176 | CABLE FFC/FPC 16POS 0.5MM 8" |  |  | 2 | 0 | 4.02000 | $8.04
6 | 5 | 296-8228-1-ND | SN74HC138PWR | IC DECODER/DEMUX 1X3:8 16-TSSOP |  |  | 5 | 0 | 0.72000 | $3.60
7 | 10 | 4878-SD103BWCT-ND | SD103BW | DIODE SCHOTTKY 30V 0.35A SOD123F |  |  | 10 | 0 | 0.17400 | $1.74
8 | 6 | 2987-CF4216FH0R0-05-NHCT-ND | CF4216FH0R0-05-NH | CONN FFC FPC 16POS 0.5MM R/A |  |  | 6 | 0 | 0.43000 | $2.58
9 | 20 | 2987-CF4240FH0R0-05-NHCT-ND | CF4240FH0R0-05-NH | CONN FFC FPC 40POS 0.5MM R/A |  |  | 20 | 0 | 0.53200 | $10.64
