lfantoniosi/CoCoTANG/fpga/cpu_test/impl/pnr/CoCoTANG_cpu_test.rpt.txt

//Copyright (C)2014-2025 Gowin Semiconductor Corporation.
//All rights reserved.

1. PnR Messages

  <Report Title>: PnR Report
  <Design File>: /Users/felipe/src/fpga/CoCoTANG/fpga/cpu_test/impl/gwsynthesis/CoCoTANG_cpu_test.vg
  <Physical Constraints File>: /Users/felipe/src/fpga/CoCoTANG/fpga/src/top.cst
  <Timing Constraints File>: /Users/felipe/src/fpga/CoCoTANG/fpga/src/top.sdc
  <Tool Version>: V1.9.11.03 Education
  <Part Number>: GW2AR-LV18QN88C8/I7
  <Device>: GW2AR-18
  <Device Version>: C
  <Created Time>:Tue Sep 15 21:44:50 2026

2. PnR Details

  Running placement:
    Placement Phase 0: CPU time = 0h 0m 0.079s, Elapsed time = 0h 0m 0.079s
    Placement Phase 1: CPU time = 0h 0m 0.063s, Elapsed time = 0h 0m 0.063s
    Placement Phase 2: CPU time = 0h 0m 0.098s, Elapsed time = 0h 0m 0.098s
    Placement Phase 3: CPU time = 0h 0m 0.348s, Elapsed time = 0h 0m 0.348s
    Total Placement: CPU time = 0h 0m 0.588s, Elapsed time = 0h 0m 0.588s
 Running routing:
    Routing Phase 0: CPU time = 0h 0m 0s, Elapsed time = 0h 0m 0s
    Routing Phase 1: CPU time = 0h 0m 0.689s, Elapsed time = 0h 0m 0.689s
    Routing Phase 2: CPU time = 0h 0m 0.389s, Elapsed time = 0h 0m 0.389s
    Routing Phase 3: CPU time = 0h 0m 0s, Elapsed time = 0h 0m 0s
    Total Routing: CPU time = 0h 0m 1s, Elapsed time = 0h 0m 1s
 Generate output files:
    CPU time = 0h 0m 0.576s, Elapsed time = 0h 0m 0.577s

 Total Time and Memory Usage: CPU time = 0h 0m 2s, Elapsed time = 0h 0m 2s, Peak memory usage = 466MB

3. Resource Usage Summary

  --------------------------------------------------------------------------------
  Resources                   | Usage                               | Utilization
  --------------------------------------------------------------------------------
  Logic                       | 1972/20736                          |  10%
    --LUT,ALU,ROM16           | 1972(1713 LUT, 259 ALU, 0 ROM16)    | -
    --SSRAM(RAM16)            | 0                                   | -
  Register                    | 1201/15915                          |  8%
    --Logic Register as Latch | 0/15552                             |  0%
    --Logic Register as FF    | 1150/15552                          |  8%
    --I/O Register as Latch   | 0/363                               |  0%
    --I/O Register as FF      | 51/363                              |  15%
  CLS                         | 1378/10368                          |  14%
  I/O Port                    | 46/66                               |  70%
  I/O Buf                     | 40                                  | -
    --Input Buf               | 11                                  | -
    --Output Buf              | 21                                  | -
    --Inout Buf               | 8                                   | -
  IOLOGIC                     | 14/121                              | 12%
    --ODDR                    | 8
    --OSER10                  | 3
  BSRAM                       | 3/46                                | 7%
    --SDPB                    | 2
    --pROM                    | 1
  ================================================================================

4. I/O Bank Usage Summary

  --------------------------------------
  I/O Bank  | Usage       | Utilization 
  --------------------------------------
  bank 0   | 2/8         | 25%         
  bank 1   | 6/9         | 67%         
  bank 2   | 0/4         | 0%          
  bank 3   | 14/17       | 83%         
  bank 4   | 8/8         | 100%        
  bank 5   | 9/10        | 90%         
  bank 6   | 6/9         | 67%         
  bank 7   | 1/1         | 100%        
  ======================================

5. Clock Resource Usage Summary

  ------------------------------------------
  Clock Resource| Usage         | Utilization 
  ------------------------------------------
  PRIMARY       | 6/8           | 75%
  LW            | 4/8           | 50%
  GCLK_PIN      | 2/5           | 40%
  CLKDIV        | 1/8           | 13%
  rPLL          | 2/2           | 100%
  ==========================================

6. Global Clock Signals

  -------------------------------------------
  Signal         | Global Clock   | Location
  -------------------------------------------
  clkin_d        | PRIMARY        |  TR TL BR BL
  clk27          | PRIMARY        |  TR BR BL
  clk108         | PRIMARY        |  TR TL BR BL
  O_sdram_clk_d  | PRIMARY        |  TR
  clk270         | PRIMARY        |  TR BR
  clk135         | PRIMARY        |  TR TL BR
  board_reset_n_Z| LW             |  -
  sdram_reset_n_Z| LW             |  -
  n283_12        | LW             |  -
  vdg/vdg_0/n2389_5| LW             |  -
  clk135         | HCLK           | BANK4_BANK5_HCLK0
  ===========================================

7. Pinout by Port Name

-------------------------------------------------------------------------------------------------------------------------------------------------------------------------------------------------------------------------
Port Name         | Diff Pair | Loc./Bank     | Constraint | Dir.  | Site     | CFG             | IO Type    | Drive | Pull Mode | PCI Clamp | Hysteresis | Open Drain | Vref       | Single Resistor | Diff Resistor | BankVccio 
-------------------------------------------------------------------------------------------------------------------------------------------------------------------------------------------------------------------------
clkin             | -         | 4/7           | Y          | in    | IOL7[A]  | LPLL1_T_in      | LVCMOS33   | NA    | NONE      | ON        | NONE       | NA         | NA         | OFF             | NA            | 3.3       
s1                | -         | 88/3          | Y          | in    | IOR30[A] | MODE0           | LVCMOS33   | NA    | DOWN      | ON        | NONE       | NA         | NA         | OFF             | NA            | 3.3       
s2                | -         | 87/3          | Y          | in    | IOR30[B] | MODE1           | LVCMOS33   | NA    | DOWN      | ON        | NONE       | NA         | NA         | OFF             | NA            | 3.3       
mp[0]             | -         | 77/1          | Y          | in    | IOT30[A] | GCLKT_1         | LVCMOS33   | NA    | NONE      | ON        | NONE       | NA         | NA         | NA              | NA            | 3.3       
mp[1]             | -         | 27/5          | Y          | in    | IOB8[A]  | -               | LVCMOS33   | NA    | NONE      | ON        | NONE       | NA         | NA         | NA              | NA            | 3.3       
mp[2]             | -         | 28/5          | Y          | in    | IOB8[B]  | -               | LVCMOS33   | NA    | NONE      | ON        | NONE       | NA         | NA         | NA              | NA            | 3.3       
mp[3]             | -         | 25/5          | Y          | in    | IOB6[A]  | -               | LVCMOS33   | NA    | NONE      | ON        | NONE       | NA         | NA         | NA              | NA            | 3.3       
mp[4]             | -         | 26/5          | Y          | in    | IOB6[B]  | -               | LVCMOS33   | NA    | NONE      | ON        | NONE       | NA         | NA         | NA              | NA            | 3.3       
mp[5]             | -         | 29/5          | Y          | in    | IOB14[A] | -               | LVCMOS33   | NA    | NONE      | ON        | NONE       | NA         | NA         | NA              | NA            | 3.3       
mp[6]             | -         | 30/5          | Y          | in    | IOB14[B] | -               | LVCMOS33   | NA    | NONE      | ON        | NONE       | NA         | NA         | NA              | NA            | 3.3       
mp[7]             | -         | 31/5          | Y          | in    | IOB18[A] | -               | LVCMOS33   | NA    | NONE      | ON        | NONE       | NA         | NA         | NA              | NA            | 3.3       
audio_in          | -         | 55/3          | Y          | in    | IOR36[B] | SSPI_CS_N/D0    | LVCMOS33   | NA    | DOWN      | ON        | NONE       | NA         | NA         | OFF             | NA            | 3.3       
mspi_miso         | -         | 62/3          | Y          | in    | IOR33[A] | MI/D7           | LVCMOS33   | NA    | UP        | ON        | NONE       | NA         | NA         | OFF             | NA            | 3.3       
msel[0]           | -         | 17/6          | Y          | out   | IOL49[A] | -               | LVCMOS33   | 8     | UP        | NA        | NA         | OFF        | NA         | OFF             | NA            | 3.3       
msel[1]           | -         | 20/6          | Y          | out   | IOL51[B] | -               | LVCMOS33   | 8     | UP        | NA        | NA         | OFF        | NA         | OFF             | NA            | 3.3       
irq_n_in          | -         | 19/6          | Y          | out   | IOL51[A] | -               | LVCMOS33   | 8     | DOWN      | NA        | NA         | OFF        | NA         | OFF             | NA            | 3.3       
firq_n_in         | -         | 18/6          | Y          | out   | IOL49[B] | -               | LVCMOS33   | 8     | DOWN      | NA        | NA         | OFF        | NA         | OFF             | NA            | 3.3       
halt_drive        | -         | 42/4          | Y          | out   | IOB42[B] | -               | LVCMOS33   | 8     | DOWN      | NA        | NA         | OFF        | NA         | NA              | NA            | 3.3       
e_out             | -         | 51/3          | Y          | out   | IOR45[A] | RPLL2_T_in      | LVCMOS33   | 8     | DOWN      | NA        | NA         | OFF        | NA         | OFF             | NA            | 3.3       
q_out             | -         | 76/1          | Y          | out   | IOT30[B] | GCLKC_1         | LVCMOS33   | 8     | DOWN      | NA        | NA         | OFF        | NA         | NA              | NA            | 3.3       
hs_n              | -         | 73/1          | Y          | out   | IOT40[A] | -               | LVCMOS33   | 8     | UP        | NA        | NA         | OFF        | NA         | NA              | NA            | 3.3       
fs_n              | -         | 74/1          | Y          | out   | IOT34[B] | -               | LVCMOS33   | 8     | UP        | NA        | NA         | OFF        | NA         | NA              | NA            | 3.3       
sam_s[0]          | -         | 15/6          | Y          | out   | IOL47[A] | LPLL2_T_fb      | LVCMOS33   | 8     | DOWN      | NA        | NA         | OFF        | NA         | OFF             | NA            | 3.3       
sam_s[1]          | -         | 41/4          | Y          | out   | IOB43[A] | -               | LVCMOS33   | 8     | DOWN      | NA        | NA         | OFF        | NA         | NA              | NA            | 3.3       
sam_s[2]          | -         | 16/6          | Y          | out   | IOL47[B] | LPLL2_C_fb      | LVCMOS33   | 8     | DOWN      | NA        | NA         | OFF        | NA         | OFF             | NA            | 3.3       
y_out             | -         | 56/3          | Y          | out   | IOR36[A] | SO/D1           | LVCMOS33   | 8     | DOWN      | NA        | NA         | OFF        | NA         | OFF             | NA            | 3.3       
pb_out            | -         | 54/3          | Y          | out   | IOR38[A] | DIN/CLKHOLD_N   | LVCMOS33   | 8     | DOWN      | NA        | NA         | OFF        | NA         | OFF             | NA            | 3.3       
tmds_clk_p        | tmds_clk_n | 33,34/5       | Y          | out   | IOB24    | -               | LVCMOS33D  | 8     | NONE      | NA        | NA         | NA         | NA         | NA              | NA            | 3.3       
tmds_data_p[0]    | tmds_data_n[0] | 35,36/4       | Y          | out   | IOB30    | GCLKT_4         | LVCMOS33D  | 8     | NONE      | NA        | NA         | NA         | NA         | NA              | NA            | 3.3       
tmds_data_p[1]    | tmds_data_n[1] | 37,38/4       | Y          | out   | IOB34    | -               | LVCMOS33D  | 8     | NONE      | NA        | NA         | NA         | NA         | NA              | NA            | 3.3       
tmds_data_p[2]    | tmds_data_n[2] | 39,40/4       | Y          | out   | IOB40    | -               | LVCMOS33D  | 8     | NONE      | NA        | NA         | NA         | NA         | NA              | NA            | 3.3       
mspi_sclk         | -         | 59/3          | Y          | out   | IOR34[B] | MCLK/D4         | LVCMOS33   | 8     | UP        | NA        | NA         | OFF        | NA         | OFF             | NA            | 3.3       
mspi_cs           | -         | 60/3          | Y          | out   | IOR34[A] | MCS_N/D5        | LVCMOS33   | 8     | UP        | NA        | NA         | OFF        | NA         | OFF             | NA            | 3.3       
mspi_mosi         | -         | 61/3          | Y          | out   | IOR33[B] | MO/D6           | LVCMOS33   | 8     | UP        | NA        | NA         | OFF        | NA         | OFF             | NA            | 3.3       
O_sdram_clk       | -         | p73/2         | -          | out   | IOR11[B] | -               | LVTTL33    | -     | UP        | -         | -          | -          | -          | -               | -             | -         
O_sdram_cke       | -         | p18/7         | -          | out   | IOL13[A] | -               | LVTTL33    | -     | UP        | -         | -          | -          | -          | -               | -             | -         
O_sdram_cs_n      | -         | p22/7         | -          | out   | IOL14[B] | -               | LVTTL33    | -     | UP        | -         | -          | -          | -          | -               | -             | -         
O_sdram_cas_n     | -         | p20/7         | -          | out   | IOL14[A] | -               | LVTTL33    | -     | UP        | -         | -          | -          | -          | -               | -             | -         
O_sdram_ras_n     | -         | p21/7         | -          | out   | IOL13[B] | -               | LVTTL33    | -     | UP        | -         | -          | -          | -          | -               | -             | -         
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
cpu_data[1]       | -         | 49/3          | Y          | io    | IOR49[A] | -               | LVCMOS33   | 8     | UP        | NA        | NONE       | OFF        | NA         | OFF             | NA            | 3.3       
cpu_data[2]       | -         | 86/0          | Y          | io    | IOT4[A]  | -               | LVCMOS33   | 8     | UP        | NA        | NONE       | OFF        | NA         | NA              | NA            | 3.3       
cpu_data[3]       | -         | 79/0          | Y          | io    | IOT27[B] | GCLKC_0         | LVCMOS33   | 8     | UP        | NA        | NONE       | OFF        | NA         | NA              | NA            | 3.3       
cpu_data[4]       | -         | 72/1          | Y          | io    | IOT40[B] | -               | LVCMOS33   | 8     | UP        | NA        | NONE       | OFF        | NA         | NA              | NA            | 3.3       
cpu_data[5]       | -         | 71/1          | Y          | io    | IOT44[A] | -               | LVCMOS33   | 8     | UP        | NA        | NONE       | OFF        | NA         | NA              | NA            | 3.3       
cpu_data[6]       | -         | 53/3          | Y          | io    | IOR38[B] | DOUT/WE_N       | LVCMOS33   | 8     | UP        | NA        | NONE       | OFF        | NA         | OFF             | NA            | 3.3       
cpu_data[7]       | -         | 52/3          | Y          | io    | IOR39[A] | SCLK            | LVCMOS33   | 8     | UP        | NA        | NONE       | OFF        | NA         | OFF             | NA            | 3.3       
IO_sdram_dq[0]    | -         | p1/7          | -          | io    | IOL3[A]  | -               | LVTTL33    | -     | UP        | -         | -          | -          | -          | -               | -             | -         
IO_sdram_dq[1]    | -         | p2/7          | -          | io    | IOL3[B]  | -               | LVTTL33    | -     | UP        | -         | -          | -          | -          | -               | -             | -         
IO_sdram_dq[2]    | -         | p5/7          | -          | io    | IOL8[A]  | LPLL1_T_fb      | LVTTL33    | -     | UP        | -         | -          | -          | -          | -               | -             | -         
IO_sdram_dq[3]    | -         | p6/7          | -          | io    | IOL8[B]  | LPLL1_C_fb      | LVTTL33    | -     | UP        | -         | -          | -          | -          | -               | -             | -         
IO_sdram_dq[4]    | -         | p7/7          | -          | io    | IOL9[A]  | -               | LVTTL33    | -     | UP        | -         | -          | -          | -          | -               | -             | -         
IO_sdram_dq[5]    | -         | p8/7          | -          | io    | IOL9[B]  | -               | LVTTL33    | -     | UP        | -         | -          | -          | -          | -               | -             | -         
IO_sdram_dq[6]    | -         | p11/7         | -          | io    | IOL11[A] | -               | LVTTL33    | -     | UP        | -         | -          | -          | -          | -               | -             | -         
IO_sdram_dq[7]    | -         | p12/7         | -          | io    | IOL11[B] | -               | LVTTL33    | -     | UP        | -         | -          | -          | -          | -               | -             | -         
IO_sdram_dq[8]    | -         | p78/2         | -          | io    | IOR9[B]  | -               | LVTTL33    | -     | UP        | -         | -          | -          | -          | -               | -             | -         
IO_sdram_dq[9]    | -         | p79/2         | -          | io    | IOR9[A]  | -               | LVTTL33    | -     | UP        | -         | -          | -          | -          | -               | -             | -         
IO_sdram_dq[10]   | -         | p82/2         | -          | io    | IOR5[B]  | -               | LVTTL33    | -     | UP        | -         | -          | -          | -          | -               | -             | -         
IO_sdram_dq[11]   | -         | p83/2         | -          | io    | IOR6[A]  | -               | LVTTL33    | -     | UP        | -         | -          | -          | -          | -               | -             | -         
IO_sdram_dq[12]   | -         | p84/2         | -          | io    | IOR5[A]  | -               | LVTTL33    | -     | UP        | -         | -          | -          | -          | -               | -             | -         
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
=========================================================================================================================================================================================================================

8. All Package Pins

----------------------------------------------------------------------------------------------------------------------------------------------------------------------------------------------
Loc./Bank| Signal            | Dir.  | Site     | CFG             | IO Type  | Drive | Pull Mode | PCI Clamp | Hysteresis | Open Drain | Vref       | Single Resistor | Diff Resistor | Bank Vccio
----------------------------------------------------------------------------------------------------------------------------------------------------------------------------------------------
86/0     | cpu_data[2]       | io    | IOT4[A]  | -               | LVCMOS33 | 8     | UP        | NA        | NONE       | OFF        | NA         | NA              | NA            | 3.3  
85/0     | -                 | in    | IOT4[B]  | -               | LVCMOS33 | NA    | UP        | ON        | NONE       | NA         | NA         | NA              | NA            | 3.3  
84/0     | -                 | in    | IOT6[A]  | -               | LVCMOS33 | NA    | UP        | ON        | NONE       | NA         | NA         | NA              | NA            | 3.3  
83/0     | -                 | in    | IOT6[B]  | -               | LVCMOS33 | NA    | UP        | ON        | NONE       | NA         | NA         | NA              | NA            | 3.3  
82/0     | -                 | in    | IOT17[A] | -               | LVCMOS33 | NA    | UP        | ON        | NONE       | NA         | NA         | NA              | NA            | 3.3  
81/0     | -                 | in    | IOT17[B] | -               | LVCMOS33 | NA    | UP        | ON        | NONE       | NA         | NA         | NA              | NA            | 3.3  
80/0     | -                 | in    | IOT27[A] | GCLKT_0         | LVCMOS33 | NA    | UP        | ON        | NONE       | NA         | NA         | NA              | NA            | 3.3  
79/0     | cpu_data[3]       | io    | IOT27[B] | GCLKC_0         | LVCMOS33 | 8     | UP        | NA        | NONE       | OFF        | NA         | NA              | NA            | 3.3  
77/1     | mp[0]             | in    | IOT30[A] | GCLKT_1         | LVCMOS33 | NA    | NONE      | ON        | NONE       | NA         | NA         | NA              | NA            | 3.3  
76/1     | q_out             | out   | IOT30[B] | GCLKC_1         | LVCMOS33 | 8     | DOWN      | NA        | NA         | OFF        | NA         | NA              | NA            | 3.3  
75/1     | -                 | in    | IOT34[A] | -               | LVCMOS33 | NA    | UP        | ON        | NONE       | NA         | NA         | NA              | NA            | 3.3  
74/1     | fs_n              | out   | IOT34[B] | -               | LVCMOS33 | 8     | UP        | NA        | NA         | OFF        | NA         | NA              | NA            | 3.3  
73/1     | hs_n              | out   | IOT40[A] | -               | LVCMOS33 | 8     | UP        | NA        | NA         | OFF        | NA         | NA              | NA            | 3.3  
72/1     | cpu_data[4]       | io    | IOT40[B] | -               | LVCMOS33 | 8     | UP        | NA        | NONE       | OFF        | NA         | NA              | NA            | 3.3  
71/1     | cpu_data[5]       | io    | IOT44[A] | -               | LVCMOS33 | 8     | UP        | NA        | NONE       | OFF        | NA         | NA              | NA            | 3.3  
70/1     | -                 | in    | IOT44[B] | -               | LVCMOS33 | NA    | UP        | ON        | NONE       | NA         | NA         | NA              | NA            | 3.3  
69/1     | -                 | in    | IOT50[A] | -               | LVCMOS33 | NA    | UP        | ON        | NONE       | NA         | NA         | NA              | NA            | 3.3  
----------------------------------------------------------------------------------------------------------------------------------------------------------------------------------------------
25/5     | mp[3]             | in    | IOB6[A]  | -               | LVCMOS33 | NA    | NONE      | ON        | NONE       | NA         | NA         | NA              | NA            | 3.3  
26/5     | mp[4]             | in    | IOB6[B]  | -               | LVCMOS33 | NA    | NONE      | ON        | NONE       | NA         | NA         | NA              | NA            | 3.3  
27/5     | mp[1]             | in    | IOB8[A]  | -               | LVCMOS33 | NA    | NONE      | ON        | NONE       | NA         | NA         | NA              | NA            | 3.3  
28/5     | mp[2]             | in    | IOB8[B]  | -               | LVCMOS33 | NA    | NONE      | ON        | NONE       | NA         | NA         | NA              | NA            | 3.3  
29/5     | mp[5]             | in    | IOB14[A] | -               | LVCMOS33 | NA    | NONE      | ON        | NONE       | NA         | NA         | NA              | NA            | 3.3  
30/5     | mp[6]             | in    | IOB14[B] | -               | LVCMOS33 | NA    | NONE      | ON        | NONE       | NA         | NA         | NA              | NA            | 3.3  
31/5     | mp[7]             | in    | IOB18[A] | -               | LVCMOS33 | NA    | NONE      | ON        | NONE       | NA         | NA         | NA              | NA            | 3.3  
32/5     | -                 | in    | IOB18[B] | -               | LVCMOS33 | NA    | UP        | ON        | NONE       | NA         | NA         | NA              | NA            | 3.3  
33/5     | tmds_clk_p        | out   | IOB24[A] | -               | LVCMOS33D | 8     | NONE      | NA        | NA         | NA         | NA         | NA              | NA            | 3.3  
34/5     | tmds_clk_n        | out   | IOB24[B] | -               | LVCMOS33D | 8     | NONE      | NA        | NA         | NA         | NA         | NA              | NA            | 3.3  
35/4     | tmds_data_p[0]    | out   | IOB30[A] | GCLKT_4         | LVCMOS33D | 8     | NONE      | NA        | NA         | NA         | NA         | NA              | NA            | 3.3  
36/4     | tmds_data_n[0]    | out   | IOB30[B] | GCLKC_4         | LVCMOS33D | 8     | NONE      | NA        | NA         | NA         | NA         | NA              | NA            | 3.3  
37/4     | tmds_data_p[1]    | out   | IOB34[A] | -               | LVCMOS33D | 8     | NONE      | NA        | NA         | NA         | NA         | NA              | NA            | 3.3  
38/4     | tmds_data_n[1]    | out   | IOB34[B] | -               | LVCMOS33D | 8     | NONE      | NA        | NA         | NA         | NA         | NA              | NA            | 3.3  
39/4     | tmds_data_p[2]    | out   | IOB40[A] | -               | LVCMOS33D | 8     | NONE      | NA        | NA         | NA         | NA         | NA              | NA            | 3.3  
40/4     | tmds_data_n[2]    | out   | IOB40[B] | -               | LVCMOS33D | 8     | NONE      | NA        | NA         | NA         | NA         | NA              | NA            | 3.3  
42/4     | halt_drive        | out   | IOB42[B] | -               | LVCMOS33 | 8     | DOWN      | NA        | NA         | OFF        | NA         | NA              | NA            | 3.3  
41/4     | sam_s[1]          | out   | IOB43[A] | -               | LVCMOS33 | 8     | DOWN      | NA        | NA         | OFF        | NA         | NA              | NA            | 3.3  
----------------------------------------------------------------------------------------------------------------------------------------------------------------------------------------------
p1/7     | IO_sdram_dq[0]    | io    | IOL3[A]  | -               | LVTTL33  | -     | UP        | -         | -          | -          | -          | -               | -             | -    
p2/7     | IO_sdram_dq[1]    | io    | IOL3[B]  | -               | LVTTL33  | -     | UP        | -         | -          | -          | -          | -               | -             | -    
4/7      | clkin             | in    | IOL7[A]  | LPLL1_T_in      | LVCMOS33 | NA    | NONE      | ON        | NONE       | NA         | NA         | OFF             | NA            | 3.3  
p5/7     | IO_sdram_dq[2]    | io    | IOL8[A]  | LPLL1_T_fb      | LVTTL33  | -     | UP        | -         | -          | -          | -          | -               | -             | -    
p6/7     | IO_sdram_dq[3]    | io    | IOL8[B]  | LPLL1_C_fb      | LVTTL33  | -     | UP        | -         | -          | -          | -          | -               | -             | -    
p7/7     | IO_sdram_dq[4]    | io    | IOL9[A]  | -               | LVTTL33  | -     | UP        | -         | -          | -          | -          | -               | -             | -    
p8/7     | IO_sdram_dq[5]    | io    | IOL9[B]  | -               | LVTTL33  | -     | UP        | -         | -          | -          | -          | -               | -             | -    
p11/7    | IO_sdram_dq[6]    | io    | IOL11[A] | -               | LVTTL33  | -     | UP        | -         | -          | -          | -          | -               | -             | -    
p12/7    | IO_sdram_dq[7]    | io    | IOL11[B] | -               | LVTTL33  | -     | UP        | -         | -          | -          | -          | -               | -             | -    
p14/7    | O_sdram_dqm[0]    | out   | IOL12[A] | -               | LVTTL33  | -     | UP        | -         | -          | -          | -          | -               | -             | -    
p19/7    | O_sdram_wen_n     | out   | IOL12[B] | -               | LVTTL33  | -     | UP        | -         | -          | -          | -          | -               | -             | -    
p18/7    | O_sdram_cke       | out   | IOL13[A] | -               | LVTTL33  | -     | UP        | -         | -          | -          | -          | -               | -             | -    
p21/7    | O_sdram_ras_n     | out   | IOL13[B] | -               | LVTTL33  | -     | UP        | -         | -          | -          | -          | -               | -             | -    
p20/7    | O_sdram_cas_n     | out   | IOL14[A] | -               | LVTTL33  | -     | UP        | -         | -          | -          | -          | -               | -             | -    
p22/7    | O_sdram_cs_n      | out   | IOL14[B] | -               | LVTTL33  | -     | UP        | -         | -          | -          | -          | -               | -             | -    
p23/7    | O_sdram_addr[9]   | out   | IOL15[A] | -               | LVTTL33  | -     | UP        | -         | -          | -          | -          | -               | -             | -    
p24/7    | O_sdram_addr[8]   | out   | IOL15[B] | -               | LVTTL33  | -     | UP        | -         | -          | -          | -          | -               | -             | -    
p26/7    | O_sdram_addr[6]   | out   | IOL16[A] | -               | LVTTL33  | -     | UP        | -         | -          | -          | -          | -               | -             | -    
p28/7    | O_sdram_addr[4]   | out   | IOL16[B] | -               | LVTTL33  | -     | UP        | -         | -          | -          | -          | -               | -             | -    
p25/7    | O_sdram_addr[7]   | out   | IOL17[A] | -               | LVTTL33  | -     | UP        | -         | -          | -          | -          | -               | -             | -    
p27/7    | O_sdram_addr[5]   | out   | IOL17[B] | -               | LVTTL33  | -     | UP        | -         | -          | -          | -          | -               | -             | -    
p29/7    | O_sdram_dqm[2]    | out   | IOL18[A] | -               | LVTTL33  | -     | UP        | -         | -          | -          | -          | -               | -             | -    
p31/7    | IO_sdram_dq[23]   | io    | IOL18[B] | -               | LVTTL33  | -     | UP        | -         | -          | -          | -          | -               | -             | -    
p32/7    | IO_sdram_dq[22]   | io    | IOL20[A] | -               | LVTTL33  | -     | UP        | -         | -          | -          | -          | -               | -             | -    
10/6     | -                 | in    | IOL29[A] | GCLKT_6         | LVCMOS33 | NA    | UP        | ON        | NONE       | NA         | NA         | NA              | NA            | 3.3  
11/6     | -                 | in    | IOL29[B] | GCLKC_6         | LVCMOS33 | NA    | UP        | ON        | NONE       | NA         | NA         | NA              | NA            | 3.3  
p35/6    | IO_sdram_dq[21]   | io    | IOL30[A] | -               | LVTTL33  | -     | UP        | -         | -          | -          | -          | -               | -             | -    
p36/6    | IO_sdram_dq[20]   | io    | IOL30[B] | -               | LVTTL33  | -     | UP        | -         | -          | -          | -          | -               | -             | -    
p37/6    | IO_sdram_dq[19]   | io    | IOL35[A] | -               | LVTTL33  | -     | UP        | -         | -          | -          | -          | -               | -             | -    
p38/6    | IO_sdram_dq[18]   | io    | IOL35[B] | -               | LVTTL33  | -     | UP        | -         | -          | -          | -          | -               | -             | -    
p41/6    | IO_sdram_dq[17]   | io    | IOL39[A] | -               | LVTTL33  | -     | UP        | -         | -          | -          | -          | -               | -             | -    
p42/6    | IO_sdram_dq[16]   | io    | IOL39[B] | -               | LVTTL33  | -     | UP        | -         | -          | -          | -          | -               | -             | -    
13/6     | -                 | in    | IOL45[A] | LPLL2_T_in      | LVCMOS33 | NA    | UP        | ON        | NONE       | NA         | NA         | NA              | NA            | 3.3  
15/6     | sam_s[0]          | out   | IOL47[A] | LPLL2_T_fb      | LVCMOS33 | 8     | DOWN      | NA        | NA         | OFF        | NA         | OFF             | NA            | 3.3  
16/6     | sam_s[2]          | out   | IOL47[B] | LPLL2_C_fb      | LVCMOS33 | 8     | DOWN      | NA        | NA         | OFF        | NA         | OFF             | NA            | 3.3  
17/6     | msel[0]           | out   | IOL49[A] | -               | LVCMOS33 | 8     | UP        | NA        | NA         | OFF        | NA         | OFF             | NA            | 3.3  
18/6     | firq_n_in         | out   | IOL49[B] | -               | LVCMOS33 | 8     | DOWN      | NA        | NA         | OFF        | NA         | OFF             | NA            | 3.3  
19/6     | irq_n_in          | out   | IOL51[A] | -               | LVCMOS33 | 8     | DOWN      | NA        | NA         | OFF        | NA         | OFF             | NA            | 3.3  
20/6     | msel[1]           | out   | IOL51[B] | -               | LVCMOS33 | 8     | UP        | NA        | NA         | OFF        | NA         | OFF             | NA            | 3.3  
----------------------------------------------------------------------------------------------------------------------------------------------------------------------------------------------
p89/2    | IO_sdram_dq[15]   | io    | IOR3[A]  | -               | LVTTL33  | -     | UP        | -         | -          | -          | -          | -               | -             | -    
p88/2    | IO_sdram_dq[14]   | io    | IOR3[B]  | -               | LVTTL33  | -     | UP        | -         | -          | -          | -          | -               | -             | -    
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
8/2      | -                 | out   | IOR25[A] | TDO             | LVCMOS33 | 8     | UP        | NA        | NA         | OFF        | NA         | NA              | NA            | 3.3  
5/2      | -                 | in    | IOR25[B] | TMS             | LVCMOS33 | NA    | UP        | ON        | NONE       | NA         | NA         | NA              | NA            | 3.3  
6/2      | -                 | in    | IOR26[A] | TCK             | LVCMOS33 | NA    | UP        | ON        | NONE       | NA         | NA         | NA              | NA            | 3.3  
7/2      | -                 | in    | IOR26[B] | TDI             | LVCMOS33 | NA    | UP        | ON        | NONE       | NA         | NA         | NA              | NA            | 3.3  
63/3     | -                 | in    | IOR29[A] | GCLKT_3         | LVCMOS33 | NA    | UP        | ON        | NONE       | NA         | NA         | NA              | NA            | 3.3  
88/3     | s1                | in    | IOR30[A] | MODE0           | LVCMOS33 | NA    | DOWN      | ON        | NONE       | NA         | NA         | OFF             | NA            | 3.3  
87/3     | s2                | in    | IOR30[B] | MODE1           | LVCMOS33 | NA    | DOWN      | ON        | NONE       | NA         | NA         | OFF             | NA            | 3.3  
9/3      | -                 | in    | IOR31[B] | RECONFIG_N      | LVCMOS33 | NA    | UP        | ON        | NONE       | NA         | NA         | NA              | NA            | 3.3  
62/3     | mspi_miso         | in    | IOR33[A] | MI/D7           | LVCMOS33 | NA    | UP        | ON        | NONE       | NA         | NA         | OFF             | NA            | 3.3  
61/3     | mspi_mosi         | out   | IOR33[B] | MO/D6           | LVCMOS33 | 8     | UP        | NA        | NA         | OFF        | NA         | OFF             | NA            | 3.3  
60/3     | mspi_cs           | out   | IOR34[A] | MCS_N/D5        | LVCMOS33 | 8     | UP        | NA        | NA         | OFF        | NA         | OFF             | NA            | 3.3  
59/3     | mspi_sclk         | out   | IOR34[B] | MCLK/D4         | LVCMOS33 | 8     | UP        | NA        | NA         | OFF        | NA         | OFF             | NA            | 3.3  
57/3     | -                 | in    | IOR35[A] | FASTRD_N/D3     | LVCMOS33 | NA    | UP        | ON        | NONE       | NA         | NA         | NA              | NA            | 3.3  
56/3     | y_out             | out   | IOR36[A] | SO/D1           | LVCMOS33 | 8     | DOWN      | NA        | NA         | OFF        | NA         | OFF             | NA            | 3.3  
55/3     | audio_in          | in    | IOR36[B] | SSPI_CS_N/D0    | LVCMOS33 | NA    | DOWN      | ON        | NONE       | NA         | NA         | OFF             | NA            | 3.3  
54/3     | pb_out            | out   | IOR38[A] | DIN/CLKHOLD_N   | LVCMOS33 | 8     | DOWN      | NA        | NA         | OFF        | NA         | OFF             | NA            | 3.3  
53/3     | cpu_data[6]       | io    | IOR38[B] | DOUT/WE_N       | LVCMOS33 | 8     | UP        | NA        | NONE       | OFF        | NA         | OFF             | NA            | 3.3  
52/3     | cpu_data[7]       | io    | IOR39[A] | SCLK            | LVCMOS33 | 8     | UP        | NA        | NONE       | OFF        | NA         | OFF             | NA            | 3.3  
p49/3    | IO_sdram_dq[30]   | io    | IOR44[A] | -               | LVTTL33  | -     | UP        | -         | -          | -          | -          | -               | -             | -    
p48/3    | IO_sdram_dq[31]   | io    | IOR44[B] | -               | LVTTL33  | -     | UP        | -         | -          | -          | -          | -               | -             | -    
51/3     | e_out             | out   | IOR45[A] | RPLL2_T_in      | LVCMOS33 | 8     | DOWN      | NA        | NA         | OFF        | NA         | OFF             | NA            | 3.3  
49/3     | cpu_data[1]       | io    | IOR49[A] | -               | LVCMOS33 | 8     | UP        | NA        | NONE       | OFF        | NA         | OFF             | NA            | 3.3  
48/3     | cpu_data[0]       | io    | IOR49[B] | -               | LVCMOS33 | 8     | UP        | NA        | NONE       | OFF        | NA         | OFF             | NA            | 3.3  
----------------------------------------------------------------------------------------------------------------------------------------------------------------------------------------------
==============================================================================================================================================================================================
