lfantoniosi/CoCoTANG/fpga/cpu_test/impl/gwsynthesis/CoCoTANG_cpu_test_syn.rpt.html

- Synthesis Messages
- Synthesis Details
- Resource
  - Resource Usage Summary
  - Resource Utilization Summary
- Timing
  - Clock Summary
  - Max Frequency Summary
  - Detail Timing Paths Informations

# Synthesis Messages

Report Title | GowinSynthesis Report

Design File

/Users/felipe/src/fpga/CoCoTANG/fpga/src/gowin_rpll/clk108.v
/Users/felipe/src/fpga/CoCoTANG/fpga/src/gowin_rpll/clk270.v
/Users/felipe/src/fpga/CoCoTANG/fpga/src/coco_clocks.v
/Users/felipe/src/fpga/CoCoTANG/fpga/src/coco_startup.v
/Users/felipe/src/fpga/CoCoTANG/fpga/src/bus/input_filter.v
/Users/felipe/src/fpga/CoCoTANG/fpga/src/bus/coco_bus_mux.v
/Users/felipe/src/fpga/CoCoTANG/fpga/src/coco2/coco_sam.v
/Users/felipe/src/fpga/CoCoTANG/fpga/src/memory/spi_flash_reader.v
/Users/felipe/src/fpga/CoCoTANG/fpga/src/memory/coco_flash_loader.v
/Users/felipe/src/fpga/CoCoTANG/fpga/src/memory/sdram.v
/Users/felipe/src/fpga/CoCoTANG/fpga/src/memory/cpu_sdram_arbiter.v
/Users/felipe/src/fpga/CoCoTANG/fpga/src/memory/cpu_test_memory.v
/Users/felipe/src/fpga/CoCoTANG/fpga/src/coco2/mc6847_char_rom.v
/Users/felipe/src/fpga/CoCoTANG/fpga/src/coco2/coco_vdg.v
/Users/felipe/src/fpga/CoCoTANG/fpga/src/video/coco_framebuffer.v
/Users/felipe/src/fpga/CoCoTANG/fpga/src/video/coco_cvbs_ntsc.v
/Users/felipe/src/fpga/CoCoTANG/fpga/src/video/hdmi/audio_clock_regeneration_packet.sv
/Users/felipe/src/fpga/CoCoTANG/fpga/src/video/hdmi/audio_info_frame.sv
/Users/felipe/src/fpga/CoCoTANG/fpga/src/video/hdmi/audio_sample_packet.sv
/Users/felipe/src/fpga/CoCoTANG/fpga/src/video/hdmi/auxiliary_video_information_info_frame.sv
/Users/felipe/src/fpga/CoCoTANG/fpga/src/video/hdmi/source_product_description_info_frame.sv
/Users/felipe/src/fpga/CoCoTANG/fpga/src/video/hdmi/packet_assembler.sv
/Users/felipe/src/fpga/CoCoTANG/fpga/src/video/hdmi/packet_picker.sv
/Users/felipe/src/fpga/CoCoTANG/fpga/src/video/hdmi/tmds_channel.sv
/Users/felipe/src/fpga/CoCoTANG/fpga/src/video/hdmi/hdmi.sv
/Users/felipe/src/fpga/CoCoTANG/fpga/src/video/hdmi/serializer.sv
/Users/felipe/src/fpga/CoCoTANG/fpga/src/video/hdmi_debug_overlay.sv
/Users/felipe/src/fpga/CoCoTANG/fpga/src/video/cpu_test_hdmi.sv
/Users/felipe/src/fpga/CoCoTANG/fpga/src/top_cpu_test.v
/Users/felipe/src/fpga/CoCoTANG/fpga/src/coco2/mc6847.vhd
GowinSynthesis Constraints File | ---
Tool Version | V1.9.11.03 Education
Part Number | GW2AR-LV18QN88C8/I7
Device | GW2AR-18
Device Version | C
Created Time | Tue Sep 15 21:44:48 2026
Legal Announcement | Copyright (C)2014-2025 Gowin Semiconductor Corporation. ALL rights reserved.

# Synthesis Details

Top Level Module | top_cpu_test

Synthesis Process

Running parser:
CPU time = 0h 0m 0.106s, Elapsed time = 0h 0m 0.106s, Peak memory usage = 56.922MB
Running netlist conversion:
CPU time = 0h 0m 0s, Elapsed time = 0h 0m 0s, Peak memory usage = 0MB
Running device independent optimization:
Optimizing Phase 0: CPU time = 0h 0m 0.034s, Elapsed time = 0h 0m 0.034s, Peak memory usage = 57.500MB
Optimizing Phase 1: CPU time = 0h 0m 0.012s, Elapsed time = 0h 0m 0.012s, Peak memory usage = 57.594MB
Optimizing Phase 2: CPU time = 0h 0m 0.063s, Elapsed time = 0h 0m 0.063s, Peak memory usage = 57.906MB
Running inference:
Inferring Phase 0: CPU time = 0h 0m 0.013s, Elapsed time = 0h 0m 0.013s, Peak memory usage = 58.438MB
Inferring Phase 1: CPU time = 0h 0m 0.001s, Elapsed time = 0h 0m 0.001s, Peak memory usage = 58.609MB
Inferring Phase 2: CPU time = 0h 0m 0.001s, Elapsed time = 0h 0m 0.001s, Peak memory usage = 58.672MB
Inferring Phase 3: CPU time = 0h 0m 0.006s, Elapsed time = 0h 0m 0.01s, Peak memory usage = 58.719MB
Running technical mapping:
Tech-Mapping Phase 0: CPU time = 0h 0m 0.059s, Elapsed time = 0h 0m 0.059s, Peak memory usage = 58.797MB
Tech-Mapping Phase 1: CPU time = 0h 0m 0.011s, Elapsed time = 0h 0m 0.011s, Peak memory usage = 58.797MB
Tech-Mapping Phase 2: CPU time = 0h 0m 0.01s, Elapsed time = 0h 0m 0.01s, Peak memory usage = 58.797MB
Tech-Mapping Phase 3: CPU time = 0h 0m 4s, Elapsed time = 0h 0m 4s, Peak memory usage = 106.625MB
Tech-Mapping Phase 4: CPU time = 0h 0m 0.06s, Elapsed time = 0h 0m 0.06s, Peak memory usage = 106.906MB
Generate output files:
CPU time = 0h 0m 0.039s, Elapsed time = 0h 0m 0.039s, Peak memory usage = 126.422MB
Total Time and Memory Usage | CPU time = 0h 0m 4s, Elapsed time = 0h 0m 4s, Peak memory usage = 126.422MB

# Resource

## Resource Usage Summary

Resource | Usage
I/O Port | 46
Embedded Port | 55
I/O Buf | 95
IBUF | 11
OBUF | 40
IOBUF | 40
ELVDS_OBUF | 4
Register | 1201
DFF | 7
DFFE | 97
DFFS | 18
DFFSE | 9
DFFR | 195
DFFRE | 92
DFFP | 6
DFFPE | 127
DFFC | 116
DFFCE | 534
LUT | 1680
LUT2 | 202
LUT3 | 539
LUT4 | 939
ALU | 214
ALU | 214
INV | 37
INV | 37
IOLOGIC | 11
ODDR | 8
OSER10 | 3
BSRAM | 3
SDPB | 2
pROM | 1
CLOCK | 3
CLKDIV | 1
rPLL | 2

## Resource Utilization Summary

Resource | Usage | Utilization
Logic | 1931(1717 LUT, 214 ALU) / 20736 | 10%
Register | 1201 / 15915 | 8%
--Register as Latch | 0 / 15915 | 0%
--Register as FF | 1201 / 15915 | 8%
BSRAM | 3 / 46 | 7%

# Timing

## Clock Summary:

NO. | Clock Name | Type | Period | Frequency(MHz) | Rise | Fall | Source | Master | Object
1 | clkin | Base | 37.037 | 27.000 | 0.000 | 18.519 | | | clkin_ibuf/I
2 | clocks/sdram_pll/rpll_inst/CLKOUT.default_gen_clk | Generated | 9.259 | 108.000 | 0.000 | 4.630 | clkin_ibuf/I | clkin | clocks/sdram_pll/rpll_inst/CLKOUT
3 | clocks/sdram_pll/rpll_inst/CLKOUTP.default_gen_clk | Generated | 9.259 | 108.000 | 4.630 | 0.000 | clkin_ibuf/I | clkin | clocks/sdram_pll/rpll_inst/CLKOUTP
4 | clocks/sdram_pll/rpll_inst/CLKOUTD.default_gen_clk | Generated | 18.519 | 54.000 | 0.000 | 9.259 | clkin_ibuf/I | clkin | clocks/sdram_pll/rpll_inst/CLKOUTD
5 | clocks/sdram_pll/rpll_inst/CLKOUTD3.default_gen_clk | Generated | 27.778 | 36.000 | 0.000 | 13.889 | clkin_ibuf/I | clkin | clocks/sdram_pll/rpll_inst/CLKOUTD3
6 | clocks/video_pll/rpll_inst/CLKOUT.default_gen_clk | Generated | 3.704 | 270.000 | 0.000 | 1.852 | clkin_ibuf/I | clkin | clocks/video_pll/rpll_inst/CLKOUT
7 | clocks/video_pll/rpll_inst/CLKOUTP.default_gen_clk | Generated | 3.704 | 270.000 | 0.000 | 1.852 | clkin_ibuf/I | clkin | clocks/video_pll/rpll_inst/CLKOUTP
8 | clocks/video_pll/rpll_inst/CLKOUTD.default_gen_clk | Generated | 7.407 | 135.000 | 0.000 | 3.704 | clkin_ibuf/I | clkin | clocks/video_pll/rpll_inst/CLKOUTD
9 | clocks/video_pll/rpll_inst/CLKOUTD3.default_gen_clk | Generated | 11.111 | 90.000 | 0.000 | 5.556 | clkin_ibuf/I | clkin | clocks/video_pll/rpll_inst/CLKOUTD3
10 | clocks/video_pixel_divider/CLKOUT.default_gen_clk | Generated | 37.037 | 27.000 | 0.000 | 18.519 | clocks/video_pll/rpll_inst/CLKOUTD | clocks/video_pll/rpll_inst/CLKOUTD.default_gen_clk | clocks/video_pixel_divider/CLKOUT

## Max Frequency Summary:

NO. | Clock Name | Constraint | Actual Fmax | Logic Level | Entity
1 | clkin | 27.000(MHz) | 373.273(MHz) | 3 | TOP
2 | clocks/sdram_pll/rpll_inst/CLKOUT.default_gen_clk | 108.000(MHz) | 109.018(MHz) | 10 | TOP
3 | clocks/video_pll/rpll_inst/CLKOUT.default_gen_clk | 270.000(MHz) | 417.397(MHz) | 3 | TOP
4 | clocks/video_pll/rpll_inst/CLKOUTD.default_gen_clk | 135.000(MHz) | 145.412(MHz) | 7 | TOP
5 | clocks/video_pixel_divider/CLKOUT.default_gen_clk | 27.000(MHz) | 139.758(MHz) | 8 | TOP

## Detail Timing Paths Information

### Path 1

Path Summary:

Slack | -4.513
Data Arrival Time | 14.562
Data Required Time | 10.049
From | bus_mux/address_high_1_s0
To | vdg/pia1_pb_7_s0
Launch Clk | clocks/video_pll/rpll_inst/CLKOUTD.default_gen_clk[R]
Latch Clk | clocks/sdram_pll/rpll_inst/CLKOUT.default_gen_clk[R]

Data Arrival Path:

AT | DELAY | TYPE | RF | FANOUT | NODE
7.407 | 0.000 | | | | clocks/video_pll/rpll_inst/CLKOUTD.default_gen_clk
7.891 | 0.484 | tCL | RR | 185 | clocks/video_pll/rpll_inst/CLKOUTD
8.251 | 0.360 | tNET | RR | 1 | bus_mux/address_high_1_s0/CLK
8.483 | 0.232 | tC2Q | RF | 3 | bus_mux/address_high_1_s0/Q
8.957 | 0.474 | tNET | FF | 1 | memory/cpu_mem_read_s3/I1
9.512 | 0.555 | tINS | FF | 3 | memory/cpu_mem_read_s3/F
9.986 | 0.474 | tNET | FF | 1 | cpu_started_s5/I3
10.357 | 0.371 | tINS | FF | 7 | cpu_started_s5/F
10.831 | 0.474 | tNET | FF | 1 | vdg/n679_s3/I3
11.202 | 0.371 | tINS | FF | 1 | vdg/n679_s3/F
11.676 | 0.474 | tNET | FF | 1 | vdg/n679_s1/I1
12.231 | 0.555 | tINS | FF | 2 | vdg/n679_s1/F
12.705 | 0.474 | tNET | FF | 1 | vdg/n687_s1/I2
13.158 | 0.453 | tINS | FF | 2 | vdg/n687_s1/F
13.632 | 0.474 | tNET | FF | 1 | vdg/n687_s0/I1
14.202 | 0.570 | tINS | FR | 3 | vdg/n687_s0/F
14.562 | 0.360 | tNET | RR | 1 | vdg/pia1_pb_7_s0/CE

Data Required Path:

AT | DELAY | TYPE | RF | FANOUT | NODE
9.259 | 0.000 | | | | clocks/sdram_pll/rpll_inst/CLKOUT.default_gen_clk
9.759 | 0.500 | tCL | RR | 914 | clocks/sdram_pll/rpll_inst/CLKOUT
10.119 | 0.360 | tNET | RR | 1 | vdg/pia1_pb_7_s0/CLK
10.084 | -0.035 | tUnc | | | vdg/pia1_pb_7_s0
10.049 | -0.035 | tSu | | 1 | vdg/pia1_pb_7_s0

Path Statistics:

Clock Skew: | 0.016
Setup Relationship: | 1.852
Logic Level: | 7
Arrival Clock Path Delay: | cell: 0.000, 0.000%; route: 0.360, 100.000%
Arrival Data Path Delay: | cell: 2.875, 45.555%; route: 3.204, 50.769%; tC2Q: 0.232, 3.676%
Required Clock Path Delay: | cell: 0.000, 0.000%; route: 0.360, 100.000%

### Path 2

Path Summary:

Slack | -4.513
Data Arrival Time | 14.562
Data Required Time | 10.049
From | bus_mux/address_high_1_s0
To | vdg/pia1_ddrb_3_s0
Launch Clk | clocks/video_pll/rpll_inst/CLKOUTD.default_gen_clk[R]
Latch Clk | clocks/sdram_pll/rpll_inst/CLKOUT.default_gen_clk[R]

Data Arrival Path:

AT | DELAY | TYPE | RF | FANOUT | NODE
7.407 | 0.000 | | | | clocks/video_pll/rpll_inst/CLKOUTD.default_gen_clk
7.891 | 0.484 | tCL | RR | 185 | clocks/video_pll/rpll_inst/CLKOUTD
8.251 | 0.360 | tNET | RR | 1 | bus_mux/address_high_1_s0/CLK
8.483 | 0.232 | tC2Q | RF | 3 | bus_mux/address_high_1_s0/Q
8.957 | 0.474 | tNET | FF | 1 | memory/cpu_mem_read_s3/I1
9.512 | 0.555 | tINS | FF | 3 | memory/cpu_mem_read_s3/F
9.986 | 0.474 | tNET | FF | 1 | cpu_started_s5/I3
10.357 | 0.371 | tINS | FF | 7 | cpu_started_s5/F
10.831 | 0.474 | tNET | FF | 1 | vdg/n679_s3/I3
11.202 | 0.371 | tINS | FF | 1 | vdg/n679_s3/F
11.676 | 0.474 | tNET | FF | 1 | vdg/n679_s1/I1
12.231 | 0.555 | tINS | FF | 2 | vdg/n679_s1/F
12.705 | 0.474 | tNET | FF | 1 | vdg/n687_s1/I2
13.158 | 0.453 | tINS | FF | 2 | vdg/n687_s1/F
13.632 | 0.474 | tNET | FF | 1 | vdg/pia1_ddrb_7_s2/I1
14.202 | 0.570 | tINS | FR | 3 | vdg/pia1_ddrb_7_s2/F
14.562 | 0.360 | tNET | RR | 1 | vdg/pia1_ddrb_3_s0/CE

Data Required Path:

AT | DELAY | TYPE | RF | FANOUT | NODE
9.259 | 0.000 | | | | clocks/sdram_pll/rpll_inst/CLKOUT.default_gen_clk
9.759 | 0.500 | tCL | RR | 914 | clocks/sdram_pll/rpll_inst/CLKOUT
10.119 | 0.360 | tNET | RR | 1 | vdg/pia1_ddrb_3_s0/CLK
10.084 | -0.035 | tUnc | | | vdg/pia1_ddrb_3_s0
10.049 | -0.035 | tSu | | 1 | vdg/pia1_ddrb_3_s0

Path Statistics:

Clock Skew: | 0.016
Setup Relationship: | 1.852
Logic Level: | 7
Arrival Clock Path Delay: | cell: 0.000, 0.000%; route: 0.360, 100.000%
Arrival Data Path Delay: | cell: 2.875, 45.555%; route: 3.204, 50.769%; tC2Q: 0.232, 3.676%
Required Clock Path Delay: | cell: 0.000, 0.000%; route: 0.360, 100.000%

### Path 3

Path Summary:

Slack | -4.513
Data Arrival Time | 14.562
Data Required Time | 10.049
From | bus_mux/address_high_1_s0
To | vdg/pia1_ddrb_4_s0
Launch Clk | clocks/video_pll/rpll_inst/CLKOUTD.default_gen_clk[R]
Latch Clk | clocks/sdram_pll/rpll_inst/CLKOUT.default_gen_clk[R]

Data Arrival Path:

AT | DELAY | TYPE | RF | FANOUT | NODE
7.407 | 0.000 | | | | clocks/video_pll/rpll_inst/CLKOUTD.default_gen_clk
7.891 | 0.484 | tCL | RR | 185 | clocks/video_pll/rpll_inst/CLKOUTD
8.251 | 0.360 | tNET | RR | 1 | bus_mux/address_high_1_s0/CLK
8.483 | 0.232 | tC2Q | RF | 3 | bus_mux/address_high_1_s0/Q
8.957 | 0.474 | tNET | FF | 1 | memory/cpu_mem_read_s3/I1
9.512 | 0.555 | tINS | FF | 3 | memory/cpu_mem_read_s3/F
9.986 | 0.474 | tNET | FF | 1 | cpu_started_s5/I3
10.357 | 0.371 | tINS | FF | 7 | cpu_started_s5/F
10.831 | 0.474 | tNET | FF | 1 | vdg/n679_s3/I3
11.202 | 0.371 | tINS | FF | 1 | vdg/n679_s3/F
11.676 | 0.474 | tNET | FF | 1 | vdg/n679_s1/I1
12.231 | 0.555 | tINS | FF | 2 | vdg/n679_s1/F
12.705 | 0.474 | tNET | FF | 1 | vdg/n687_s1/I2
13.158 | 0.453 | tINS | FF | 2 | vdg/n687_s1/F
13.632 | 0.474 | tNET | FF | 1 | vdg/pia1_ddrb_7_s2/I1
14.202 | 0.570 | tINS | FR | 3 | vdg/pia1_ddrb_7_s2/F
14.562 | 0.360 | tNET | RR | 1 | vdg/pia1_ddrb_4_s0/CE

Data Required Path:

AT | DELAY | TYPE | RF | FANOUT | NODE
9.259 | 0.000 | | | | clocks/sdram_pll/rpll_inst/CLKOUT.default_gen_clk
9.759 | 0.500 | tCL | RR | 914 | clocks/sdram_pll/rpll_inst/CLKOUT
10.119 | 0.360 | tNET | RR | 1 | vdg/pia1_ddrb_4_s0/CLK
10.084 | -0.035 | tUnc | | | vdg/pia1_ddrb_4_s0
10.049 | -0.035 | tSu | | 1 | vdg/pia1_ddrb_4_s0

Path Statistics:

Clock Skew: | 0.016
Setup Relationship: | 1.852
Logic Level: | 7
Arrival Clock Path Delay: | cell: 0.000, 0.000%; route: 0.360, 100.000%
Arrival Data Path Delay: | cell: 2.875, 45.555%; route: 3.204, 50.769%; tC2Q: 0.232, 3.676%
Required Clock Path Delay: | cell: 0.000, 0.000%; route: 0.360, 100.000%

### Path 4

Path Summary:

Slack | -4.513
Data Arrival Time | 14.562
Data Required Time | 10.049
From | bus_mux/address_high_1_s0
To | vdg/pia1_ddrb_7_s0
Launch Clk | clocks/video_pll/rpll_inst/CLKOUTD.default_gen_clk[R]
Latch Clk | clocks/sdram_pll/rpll_inst/CLKOUT.default_gen_clk[R]

Data Arrival Path:

AT | DELAY | TYPE | RF | FANOUT | NODE
7.407 | 0.000 | | | | clocks/video_pll/rpll_inst/CLKOUTD.default_gen_clk
7.891 | 0.484 | tCL | RR | 185 | clocks/video_pll/rpll_inst/CLKOUTD
8.251 | 0.360 | tNET | RR | 1 | bus_mux/address_high_1_s0/CLK
8.483 | 0.232 | tC2Q | RF | 3 | bus_mux/address_high_1_s0/Q
8.957 | 0.474 | tNET | FF | 1 | memory/cpu_mem_read_s3/I1
9.512 | 0.555 | tINS | FF | 3 | memory/cpu_mem_read_s3/F
9.986 | 0.474 | tNET | FF | 1 | cpu_started_s5/I3
10.357 | 0.371 | tINS | FF | 7 | cpu_started_s5/F
10.831 | 0.474 | tNET | FF | 1 | vdg/n679_s3/I3
11.202 | 0.371 | tINS | FF | 1 | vdg/n679_s3/F
11.676 | 0.474 | tNET | FF | 1 | vdg/n679_s1/I1
12.231 | 0.555 | tINS | FF | 2 | vdg/n679_s1/F
12.705 | 0.474 | tNET | FF | 1 | vdg/n687_s1/I2
13.158 | 0.453 | tINS | FF | 2 | vdg/n687_s1/F
13.632 | 0.474 | tNET | FF | 1 | vdg/pia1_ddrb_7_s2/I1
14.202 | 0.570 | tINS | FR | 3 | vdg/pia1_ddrb_7_s2/F
14.562 | 0.360 | tNET | RR | 1 | vdg/pia1_ddrb_7_s0/CE

Data Required Path:

AT | DELAY | TYPE | RF | FANOUT | NODE
9.259 | 0.000 | | | | clocks/sdram_pll/rpll_inst/CLKOUT.default_gen_clk
9.759 | 0.500 | tCL | RR | 914 | clocks/sdram_pll/rpll_inst/CLKOUT
10.119 | 0.360 | tNET | RR | 1 | vdg/pia1_ddrb_7_s0/CLK
10.084 | -0.035 | tUnc | | | vdg/pia1_ddrb_7_s0
10.049 | -0.035 | tSu | | 1 | vdg/pia1_ddrb_7_s0

Path Statistics:

Clock Skew: | 0.016
Setup Relationship: | 1.852
Logic Level: | 7
Arrival Clock Path Delay: | cell: 0.000, 0.000%; route: 0.360, 100.000%
Arrival Data Path Delay: | cell: 2.875, 45.555%; route: 3.204, 50.769%; tC2Q: 0.232, 3.676%
Required Clock Path Delay: | cell: 0.000, 0.000%; route: 0.360, 100.000%

### Path 5

Path Summary:

Slack | -4.513
Data Arrival Time | 14.562
Data Required Time | 10.049
From | bus_mux/address_high_1_s0
To | vdg/pia1_pb_3_s0
Launch Clk | clocks/video_pll/rpll_inst/CLKOUTD.default_gen_clk[R]
Latch Clk | clocks/sdram_pll/rpll_inst/CLKOUT.default_gen_clk[R]

Data Arrival Path:

AT | DELAY | TYPE | RF | FANOUT | NODE
7.407 | 0.000 | | | | clocks/video_pll/rpll_inst/CLKOUTD.default_gen_clk
7.891 | 0.484 | tCL | RR | 185 | clocks/video_pll/rpll_inst/CLKOUTD
8.251 | 0.360 | tNET | RR | 1 | bus_mux/address_high_1_s0/CLK
8.483 | 0.232 | tC2Q | RF | 3 | bus_mux/address_high_1_s0/Q
8.957 | 0.474 | tNET | FF | 1 | memory/cpu_mem_read_s3/I1
9.512 | 0.555 | tINS | FF | 3 | memory/cpu_mem_read_s3/F
9.986 | 0.474 | tNET | FF | 1 | cpu_started_s5/I3
10.357 | 0.371 | tINS | FF | 7 | cpu_started_s5/F
10.831 | 0.474 | tNET | FF | 1 | vdg/n679_s3/I3
11.202 | 0.371 | tINS | FF | 1 | vdg/n679_s3/F
11.676 | 0.474 | tNET | FF | 1 | vdg/n679_s1/I1
12.231 | 0.555 | tINS | FF | 2 | vdg/n679_s1/F
12.705 | 0.474 | tNET | FF | 1 | vdg/n687_s1/I2
13.158 | 0.453 | tINS | FF | 2 | vdg/n687_s1/F
13.632 | 0.474 | tNET | FF | 1 | vdg/n687_s0/I1
14.202 | 0.570 | tINS | FR | 3 | vdg/n687_s0/F
14.562 | 0.360 | tNET | RR | 1 | vdg/pia1_pb_3_s0/CE

Data Required Path:

AT | DELAY | TYPE | RF | FANOUT | NODE
9.259 | 0.000 | | | | clocks/sdram_pll/rpll_inst/CLKOUT.default_gen_clk
9.759 | 0.500 | tCL | RR | 914 | clocks/sdram_pll/rpll_inst/CLKOUT
10.119 | 0.360 | tNET | RR | 1 | vdg/pia1_pb_3_s0/CLK
10.084 | -0.035 | tUnc | | | vdg/pia1_pb_3_s0
10.049 | -0.035 | tSu | | 1 | vdg/pia1_pb_3_s0

Path Statistics:

Clock Skew: | 0.016
Setup Relationship: | 1.852
Logic Level: | 7
Arrival Clock Path Delay: | cell: 0.000, 0.000%; route: 0.360, 100.000%
Arrival Data Path Delay: | cell: 2.875, 45.555%; route: 3.204, 50.769%; tC2Q: 0.232, 3.676%
Required Clock Path Delay: | cell: 0.000, 0.000%; route: 0.360, 100.000%
