lfantoniosi/CoCoTANG/fpga/cpu_test/impl/gwsynthesis/CoCoTANG_cpu_test_syn_resource.html

# Hierarchy Module Resource

MODULE NAME | REG NUMBER | ALU NUMBER | LUT NUMBER | DSP NUMBER | BSRAM NUMBER | SSRAM NUMBER | ROM16 NUMBER
top_cpu_test (/Users/felipe/src/fpga/CoCoTANG/fpga/src/top_cpu_test.v) | 55 | - | 90 | - | - | - | -
|--clocks (/Users/felipe/src/fpga/CoCoTANG/fpga/src/top_cpu_test.v) | 20 | 7 | 24 | - | - | - | -
|--sdram_pll (/Users/felipe/src/fpga/CoCoTANG/fpga/src/coco_clocks.v) | - | - | - | - | - | - | -
|--video_pll (/Users/felipe/src/fpga/CoCoTANG/fpga/src/coco_clocks.v) | - | - | - | - | - | - | -
|--sam (/Users/felipe/src/fpga/CoCoTANG/fpga/src/top_cpu_test.v) | 41 | 21 | 33 | - | - | - | -
|--bus_mux (/Users/felipe/src/fpga/CoCoTANG/fpga/src/top_cpu_test.v) | 24 | - | 13 | - | - | - | -
|--startup (/Users/felipe/src/fpga/CoCoTANG/fpga/src/top_cpu_test.v) | 13 | - | 24 | - | - | - | -
|--sdram_controller (/Users/felipe/src/fpga/CoCoTANG/fpga/src/top_cpu_test.v) | 55 | 14 | 69 | - | - | - | -
|--memory (/Users/felipe/src/fpga/CoCoTANG/fpga/src/top_cpu_test.v) | 333 | 34 | 430 | - | - | - | -
|--loader (/Users/felipe/src/fpga/CoCoTANG/fpga/src/memory/cpu_test_memory.v) | 23 | 14 | 23 | - | - | - | -
|--reader (/Users/felipe/src/fpga/CoCoTANG/fpga/src/memory/coco_flash_loader.v) | 57 | - | 86 | - | - | - | -
|--arbiter (/Users/felipe/src/fpga/CoCoTANG/fpga/src/memory/cpu_test_memory.v) | 104 | - | 139 | - | - | - | -
|--vdg (/Users/felipe/src/fpga/CoCoTANG/fpga/src/top_cpu_test.v) | 14 | 7 | 14 | - | - | - | -
|--character_rom (/Users/felipe/src/fpga/CoCoTANG/fpga/src/coco2/coco_vdg.v) | - | - | - | - | 1 | - | -
|--vdg (/Users/felipe/src/fpga/CoCoTANG/fpga/src/coco2/coco_vdg.v) | 187 | 7 | 374 | - | 1 | - | -
|--hdmi_output (/Users/felipe/src/fpga/CoCoTANG/fpga/src/top_cpu_test.v) | 32 | 8 | 73 | - | 1 | - | -
|--encoder (/Users/felipe/src/fpga/CoCoTANG/fpga/src/video/cpu_test_hdmi.sv) | 30 | 9 | 31 | - | - | - | -
|--tmds_gen[0].tmds_channel (/Users/felipe/src/fpga/CoCoTANG/fpga/src/video/hdmi/hdmi.sv) | 11 | 6 | 36 | - | - | - | -
|--tmds_gen[1].tmds_channel (/Users/felipe/src/fpga/CoCoTANG/fpga/src/video/hdmi/hdmi.sv) | 11 | 6 | 30 | - | - | - | -
|--tmds_gen[2].tmds_channel (/Users/felipe/src/fpga/CoCoTANG/fpga/src/video/hdmi/hdmi.sv) | 11 | 6 | 30 | - | - | - | -
|--serializer_inst (/Users/felipe/src/fpga/CoCoTANG/fpga/src/video/cpu_test_hdmi.sv) | - | - | - | - | - | - | -
|--analog_encoder (/Users/felipe/src/fpga/CoCoTANG/fpga/src/top_cpu_test.v) | 180 | 75 | 198 | - | - | - | -
