lfantoniosi/CoCoTANG/fpga/impl/pnr/cvbs-chroma-timing-fix-pnr-options.txt

-d /Users/felipe/src/fpga/CoCoTANG/fpga/impl/gwsynthesis/CoCoTANG-cvbs-minimal.vg
-p GW2AR-18C-QFN88-8
-pn GW2AR-LV18QN88C8/I7
-cst /Users/felipe/src/fpga/CoCoTANG/fpga/src/top_coco3.cst
-cfg /Users/felipe/src/fpga/CoCoTANG/fpga/impl/pnr/device.cfg
-sdc /Users/felipe/src/fpga/CoCoTANG/fpga/src/top_coco3_pal.sdc
-bit
-tr
-ph
-timing
-cst_error
-convert_sdp32_36_to_sdp16_18
-place_option 1
-route_option 1
-clock_route_order 0
-correct_hold 1
-route_maxfan 23
-global_freq 100.000
