lfantoniosi/CoCoTANG/fpga/impl/pnr/CoCoTANG-contras-debug.rpt.txt

//Copyright (C)2014-2025 Gowin Semiconductor Corporation.
//All rights reserved.

1. PnR Messages

  <Report Title>: PnR Report
  <Design File>: /Users/felipe/src/fpga/CoCoTANG/fpga/impl/gwsynthesis/CoCoTANG-contras-debug.vg
  <Physical Constraints File>: /Users/felipe/src/fpga/CoCoTANG/fpga/src/top_coco3.cst
  <Timing Constraints File>: /Users/felipe/src/fpga/CoCoTANG/fpga/src/top_coco3_pal.sdc
  <Tool Version>: V1.9.11.03 Education
  <Part Number>: GW2AR-LV18QN88C8/I7
  <Device>: GW2AR-18
  <Device Version>: C
  <Created Time>:Fri Oct  9 02:03:47 2026

2. PnR Details

  Running placement:
    Placement Phase 0: CPU time = 0h 0m 0.561s, Elapsed time = 0h 0m 0.561s
    Placement Phase 1: CPU time = 0h 0m 0.113s, Elapsed time = 0h 0m 0.113s
    Placement Phase 2: CPU time = 0h 0m 1s, Elapsed time = 0h 0m 1s
    Placement Phase 3: CPU time = 0h 0m 1s, Elapsed time = 0h 0m 1s
    Total Placement: CPU time = 0h 0m 3s, Elapsed time = 0h 0m 3s
 Running routing:
    Routing Phase 0: CPU time = 0h 0m 0.001s, Elapsed time = 0h 0m 0.001s
    Routing Phase 1: CPU time = 0h 0m 0.819s, Elapsed time = 0h 0m 0.822s
    Routing Phase 2: CPU time = 0h 0m 5s, Elapsed time = 0h 0m 5s
    Routing Phase 3: CPU time = 0h 0m 0s, Elapsed time = 0h 0m 0s
    Total Routing: CPU time = 0h 0m 6s, Elapsed time = 0h 0m 6s
 Generate output files:
    CPU time = 0h 0m 0.684s, Elapsed time = 0h 0m 0.689s

 Total Time and Memory Usage: CPU time = 0h 0m 10s, Elapsed time = 0h 0m 10s, Peak memory usage = 500MB

3. Resource Usage Summary

  --------------------------------------------------------------------------------
  Resources                   | Usage                               | Utilization
  --------------------------------------------------------------------------------
  Logic                       | 9050/20736                          |  44%
    --LUT,ALU,ROM16           | 8726(7614 LUT, 1112 ALU, 0 ROM16)   | -
    --SSRAM(RAM16)            | 54                                  | -
  Register                    | 4682/15915                          |  30%
    --Logic Register as Latch | 0/15552                             |  0%
    --Logic Register as FF    | 4625/15552                          |  30%
    --I/O Register as Latch   | 0/363                               |  0%
    --I/O Register as FF      | 57/363                              |  16%
  CLS                         | 6452/10368                          |  63%
  I/O Port                    | 53/66                               |  81%
  I/O Buf                     | 49                                  | -
    --Input Buf               | 12                                  | -
    --Output Buf              | 28                                  | -
    --Inout Buf               | 9                                   | -
  IOLOGIC                     | 22/121                              | 19%
    --IDDR                    | 8
    --ODDR                    | 8
    --OSER10                  | 3
  BSRAM                       | 43/46                               | 94%
    --SDPB                    | 40
    --DPB                     | 1
    --pROM                    | 2
  DSP                         | 1.25/24                             | 6%
    --MULT9X9                 | 1
    --MULTADDALU18X18         | 1
  ================================================================================

4. I/O Bank Usage Summary

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

5. Clock Resource Usage Summary

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

6. Global Clock Signals

  -------------------------------------------
  Signal         | Global Clock   | Location
  -------------------------------------------
  clkin_d        | PRIMARY        |  BR BL
  O_sdram_clk_d  | PRIMARY        |  TR
  core/clk27     | PRIMARY        |  TR TL BR BL
  core/clk108    | PRIMARY        |  TR TL BR BL
  core/clk270    | PRIMARY        |  TL BR BL
  core/clk135    | PRIMARY        |  TR TL BR BL
  core/pia1_audio_clk| PRIMARY        |  BR
  core/n857_6    | LW             |  -
  core/sdram_reset_n_Z| LW             |  -
  core/system_ready_Z| LW             |  -
  core/gime_register_debug[79]| LW             |  -
  core/machine/n689_5| LW             |  -
  core/machine/fill_border_rgb_3_20| LW             |  -
  core/machine/scanlines/artifact_shift_260_7| LW             |  -
  core/hdmi_output/encoder/true_hdmi_output.packet_picker/n3827_4| LW             |  -
  core/clk135    | HCLK           | BANK4_BANK5_HCLK0
  ===========================================

7. Pinout by Port Name

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

8. All Package Pins

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
