lfantoniosi/CoCoTANG/fpga/docs/fab.pdf

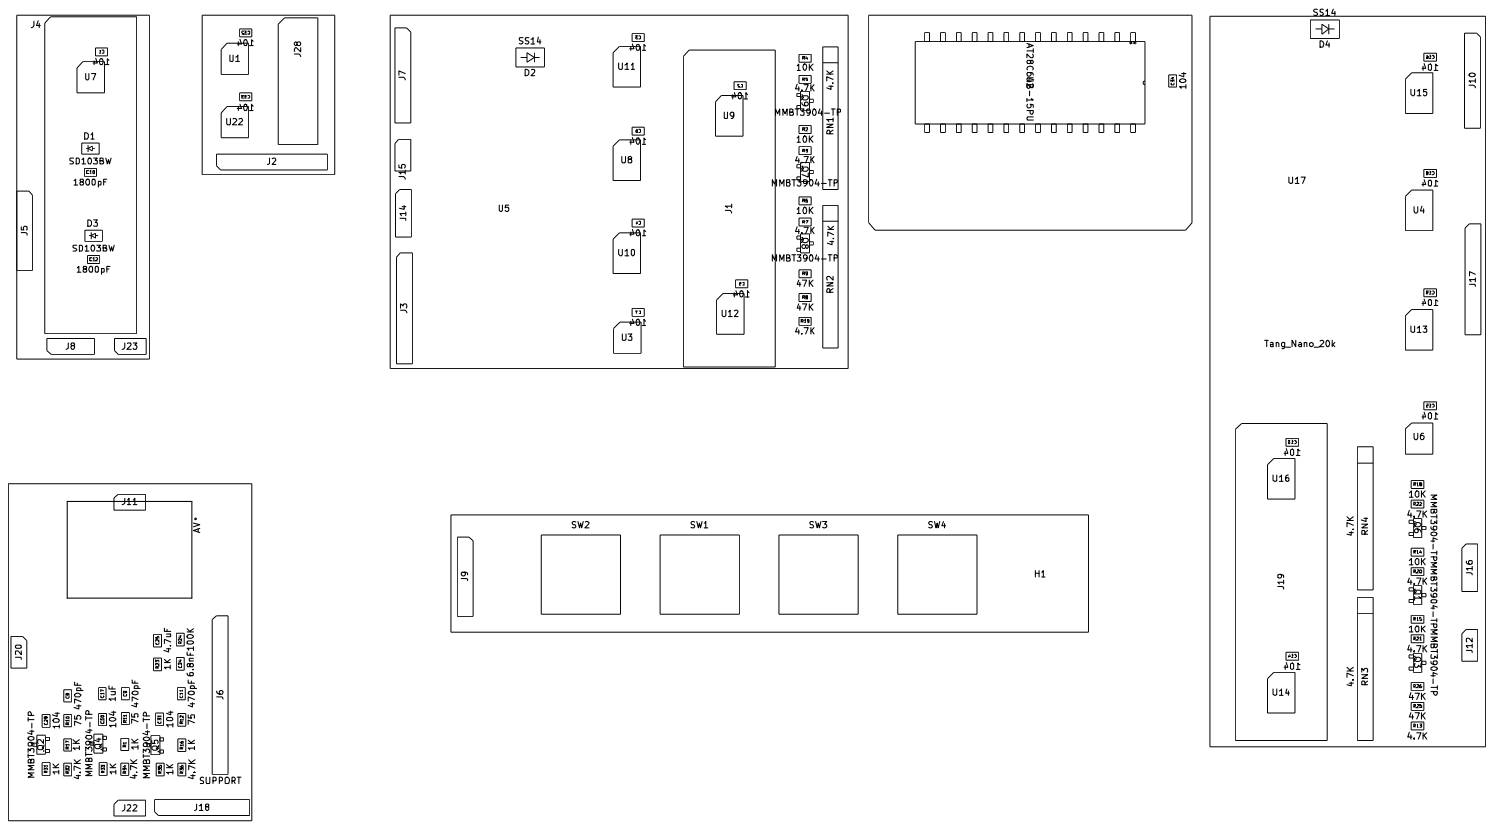
[picture p45: page 1]
