lfantoniosi/CoCoTANG/kicad/CoCoTANG.kicad_pcb

## KiCad design kicad/CoCoTANG.kicad_pcb (2026-11-13)

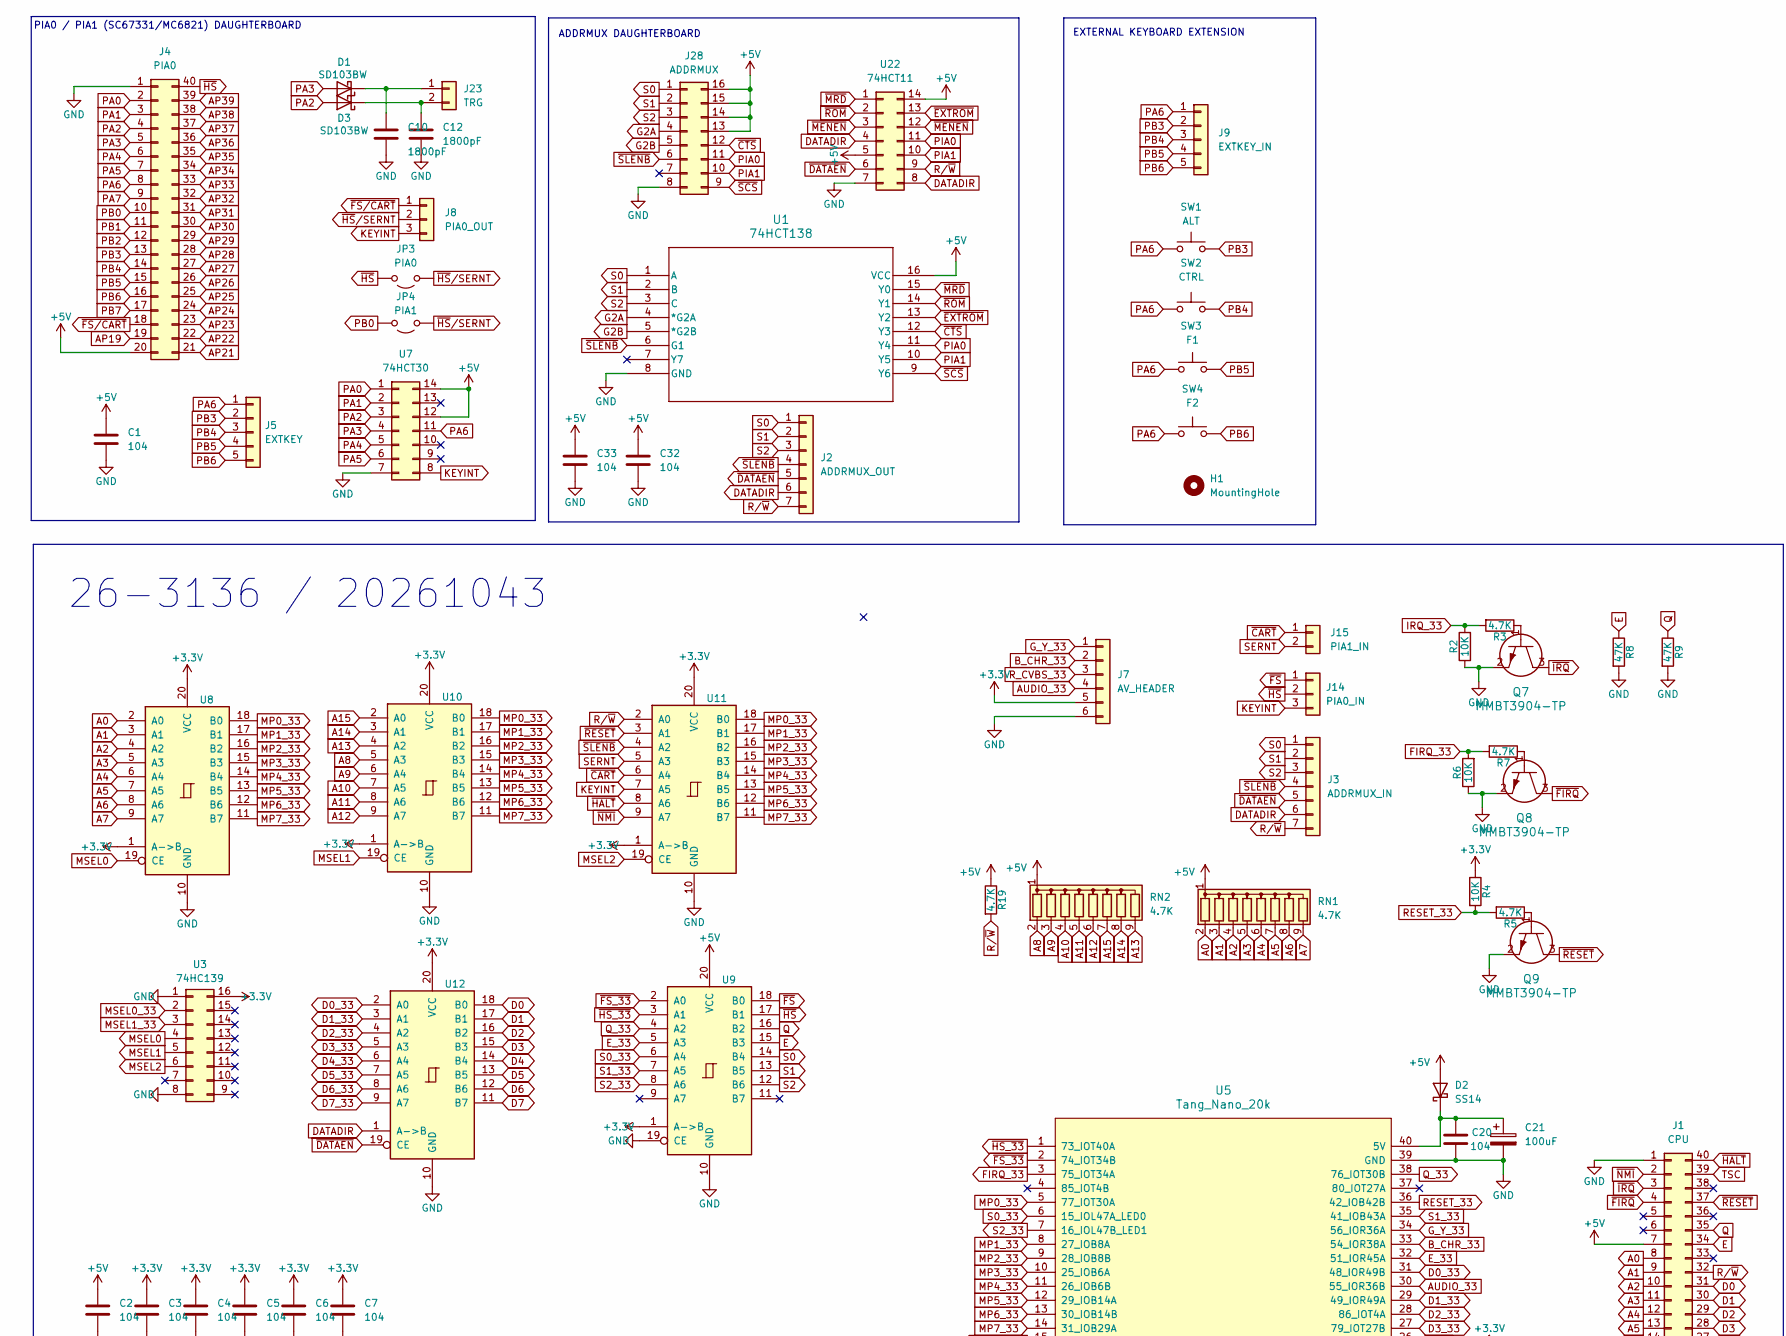
[picture p46: schematic CoCoTANG.kicad_sch, part in row 1, column 1]

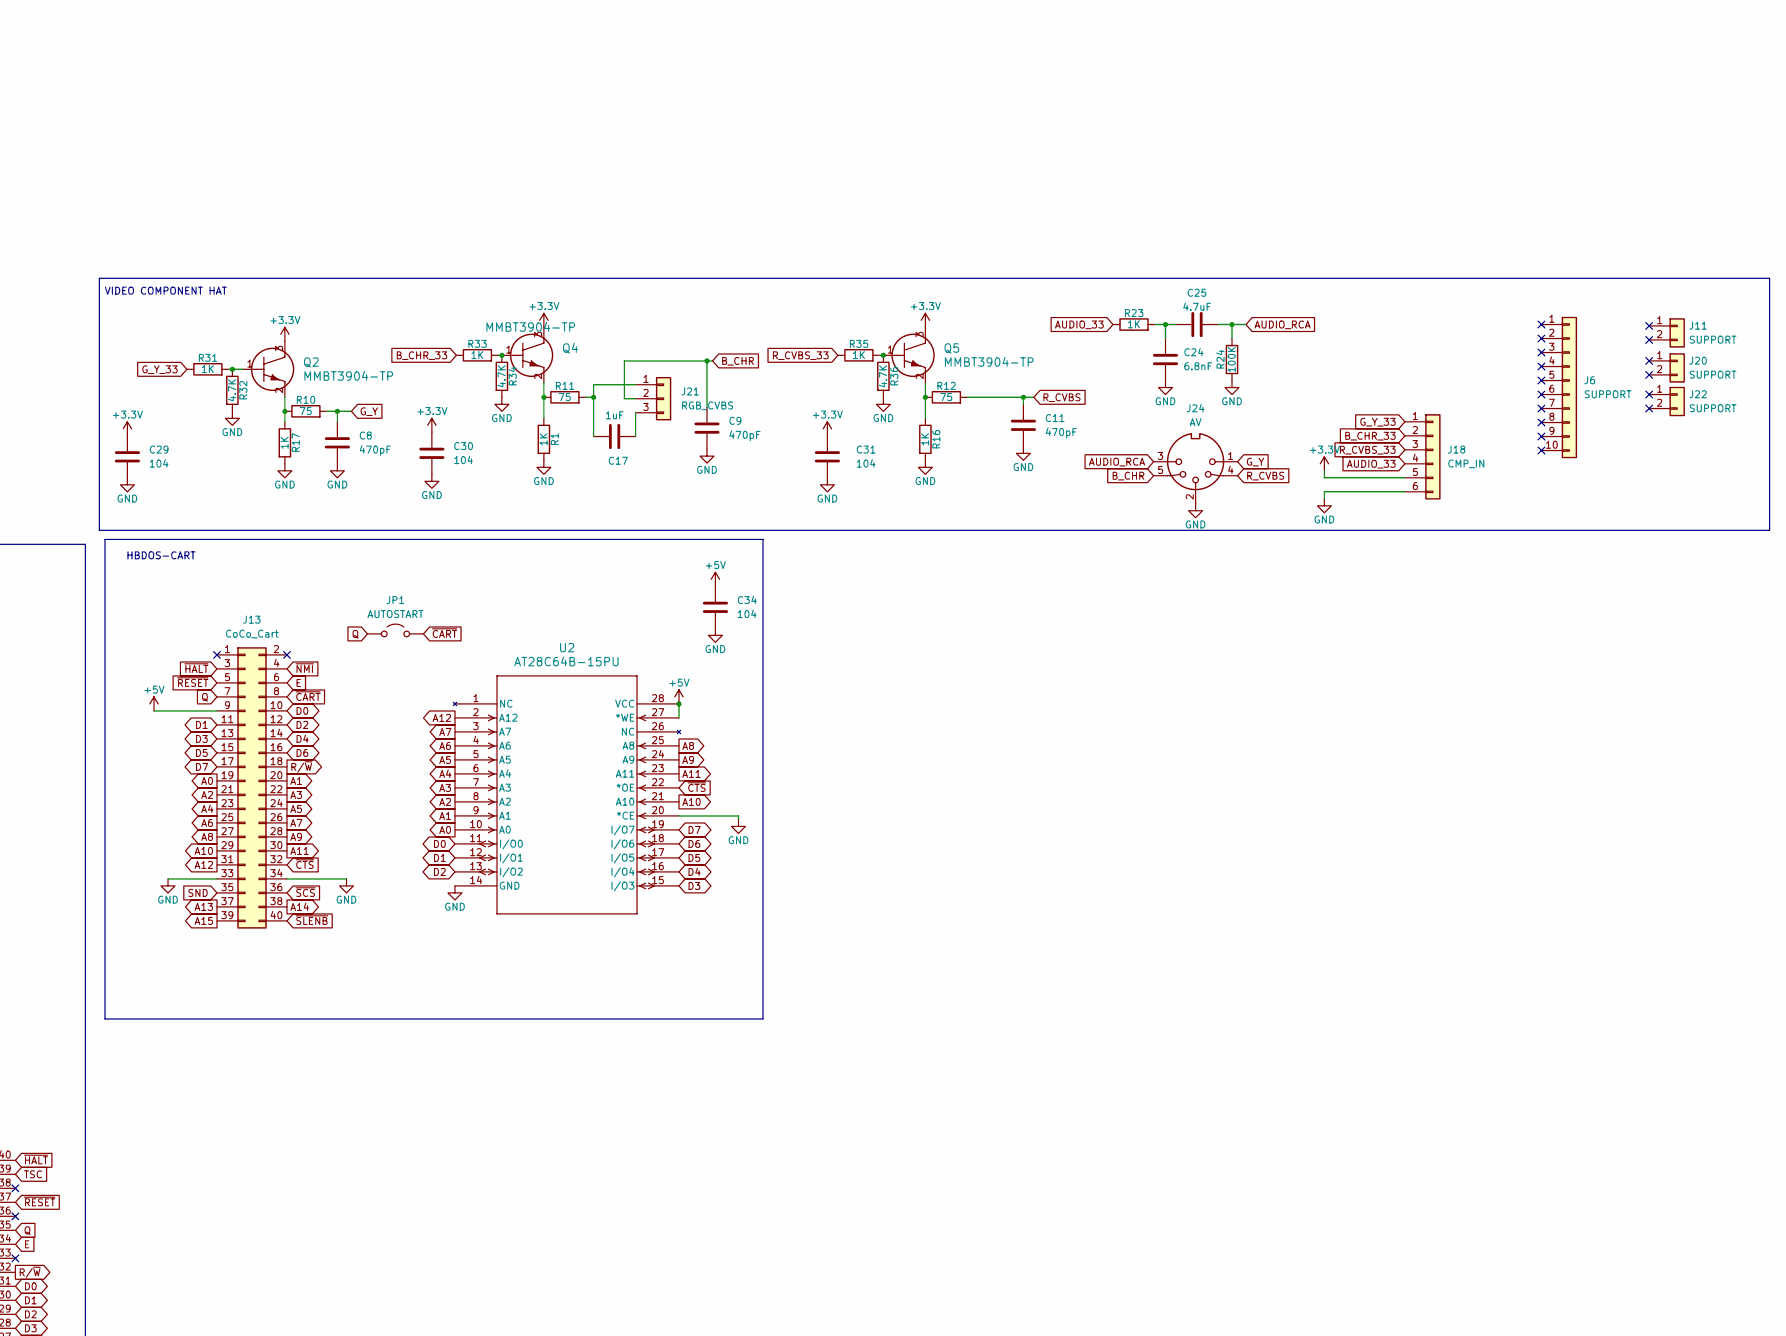
[picture p47: schematic CoCoTANG.kicad_sch, part in row 1, column 2]

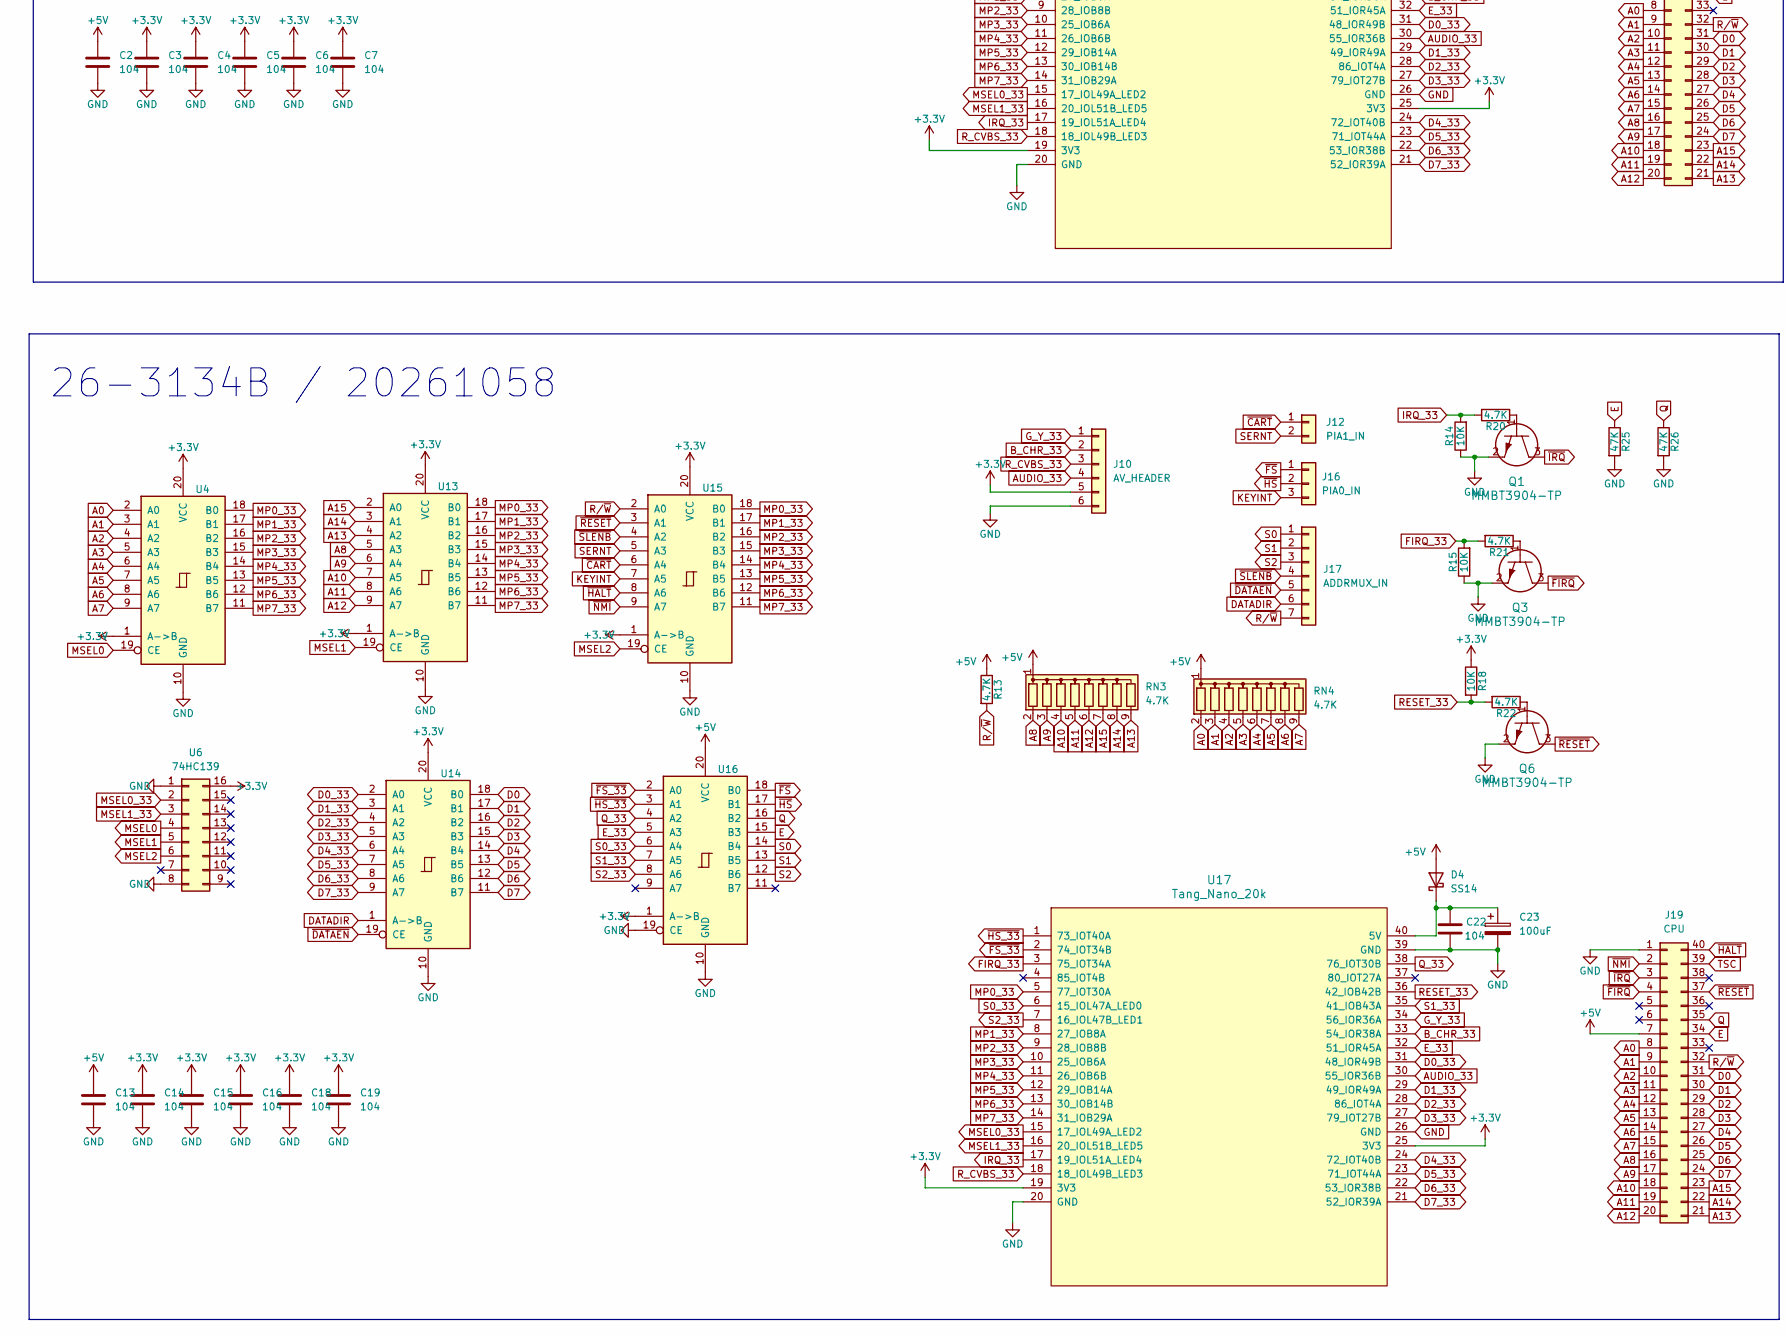
[picture p48: schematic CoCoTANG.kicad_sch, part in row 2, column 1]

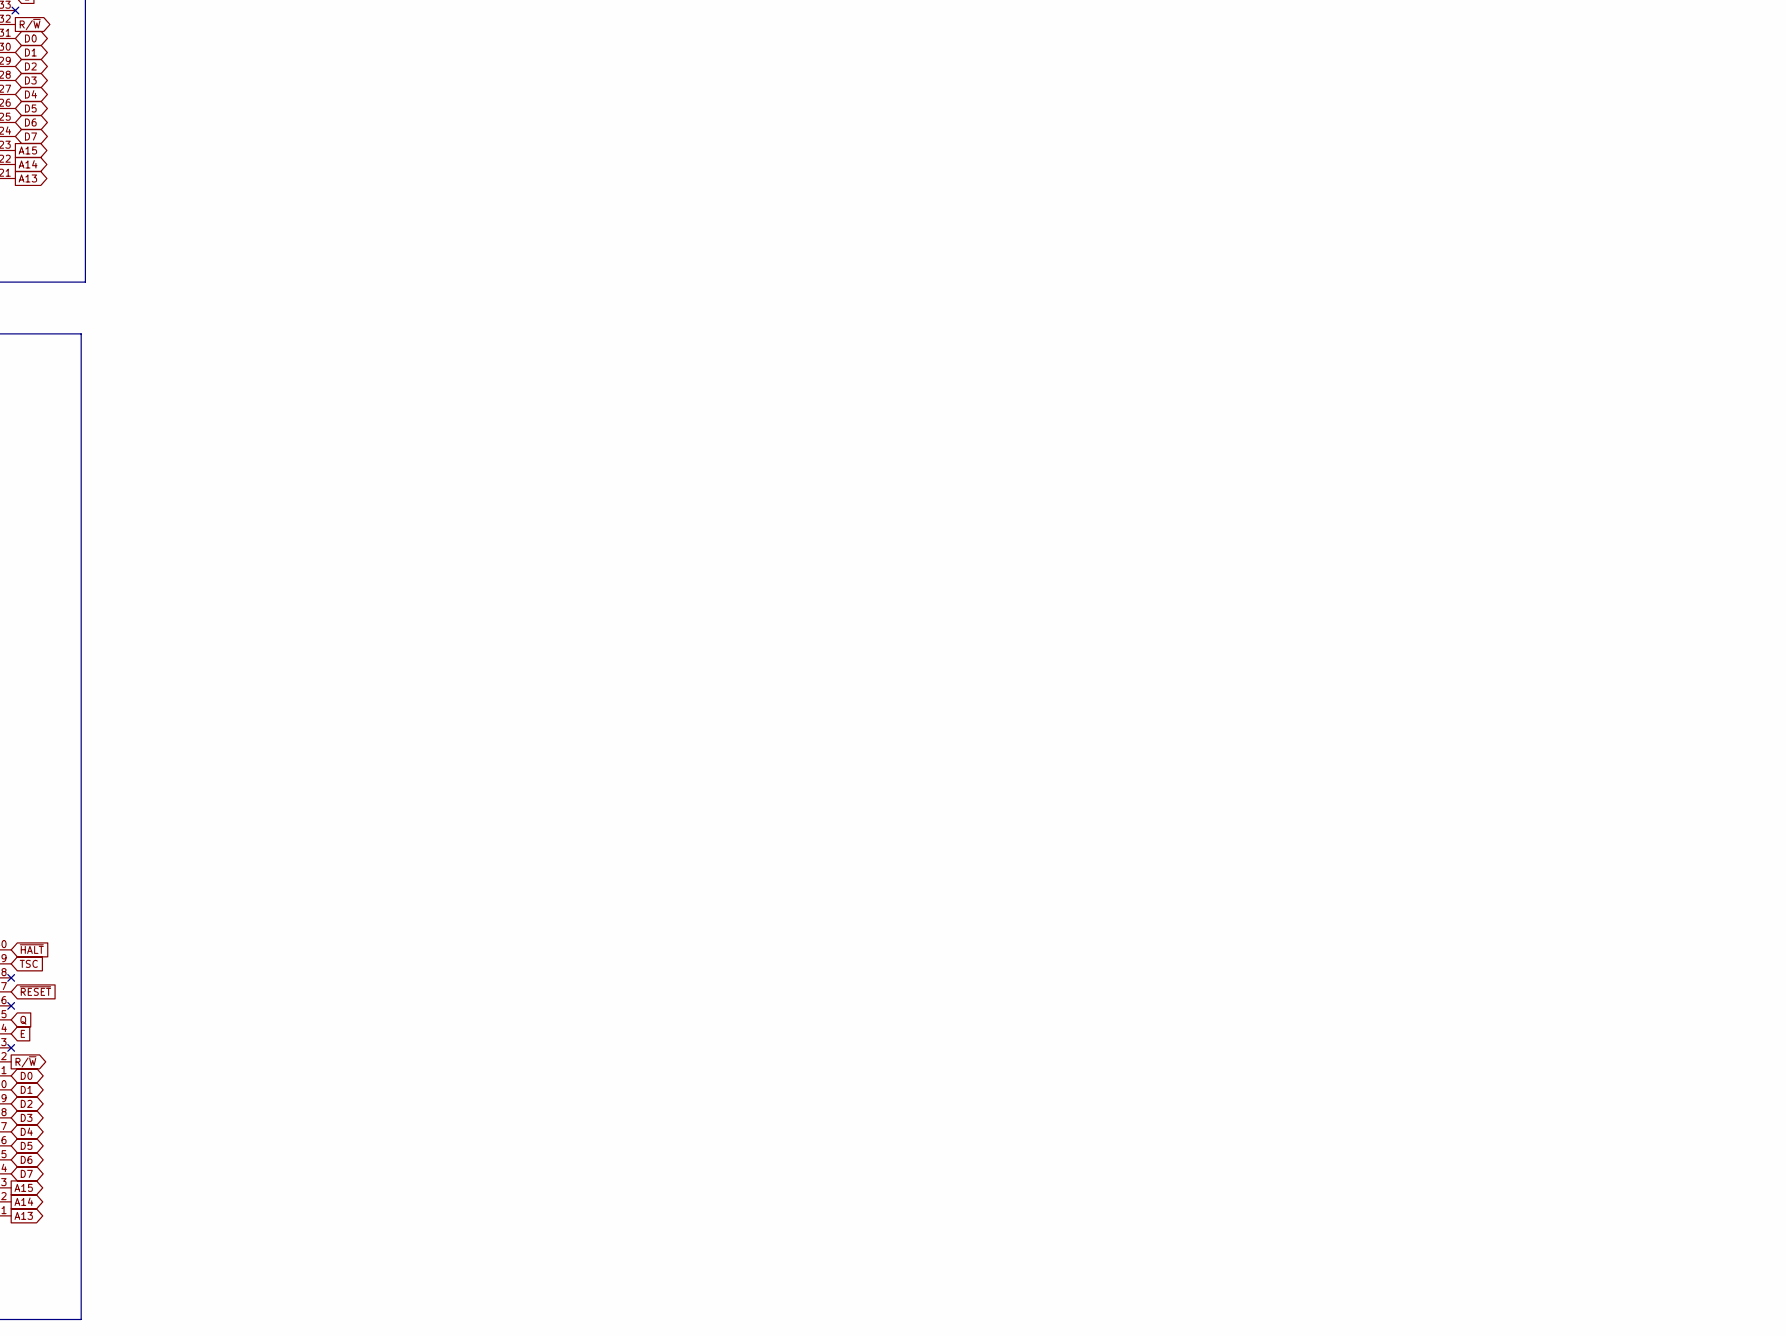
[picture p49: schematic CoCoTANG.kicad_sch, part in row 2, column 2]

Parts:
C1, C2, C3, C4, C5, C6, C7, C13, C14, C15, C16, C18, C19, C20, C22, C29, C30, C31, C32, C33, C34: 104; C_0805_2012Metric_Pad1.18x1.45mm_HandSolder
C8, C9, C11: 470pF; C_0805_2012Metric_Pad1.18x1.45mm_HandSolder
C10, C12: 1800pF; C_0805_2012Metric_Pad1.18x1.45mm_HandSolder
C17: 1uF; C_0805_2012Metric_Pad1.18x1.45mm_HandSolder
C21, C23: 100uF; CP_Radial_D5.0mm_P2.50mm
C24: 6.8nF; C_0805_2012Metric_Pad1.18x1.45mm_HandSolder
C25: 4.7uF; C_0805_2012Metric_Pad1.18x1.45mm_HandSolder
D1, D3: SD103BW; D_SOD-123F
D2, D4: SS14; D_SMA
H1: MountingHole; MountingHole_4.3mm_M4
J1, J19: CPU; DIP-40_W15.24mm-OVERSIZED
J2: ADDRMUX_OUT; PinHeader_1x07_P2.54mm_Vertical
J3, J17: ADDRMUX_IN; PinHeader_1x07_P2.54mm_Vertical
J4: PIA0; DIP-40_W15.24mm-OVERSIZED
J5: EXTKEY; PinSocket_1x05_P2.54mm_Vertical
J6: SUPPORT; PinHeader_1x10_P2.54mm_Vertical
J7, J10: AV_HEADER; PinSocket_1x06_P2.54mm_Vertical
J8: PIA0_OUT; PinHeader_1x03_P2.54mm_Vertical
J9: EXTKEY_IN; PinSocket_1x05_P2.54mm_Vertical
J11, J20, J22: SUPPORT; PinSocket_1x02_P2.54mm_Vertical
J12, J15: PIA1_IN; PinHeader_1x02_P2.54mm_Vertical
J13: CoCo_Cart; COCO_CART
J14, J16: PIA0_IN; PinHeader_1x03_P2.54mm_Vertical
J18: CMP_IN; PinHeader_1x06_P2.54mm_Vertical
J21: RGB_CVBS; PinSocket_1x03_P2.54mm_Vertical
J23: TRG; PinHeader_1x02_P2.54mm_Vertical
J24: AV; SWITCHCRAFT_57PC5F
J28: ADDRMUX; DIP-16_W7.62mm-OVERSIZED
JP1: AUTOSTART; SolderJumper-2_P1.3mm_Open_Pad1.0x1.5mm
JP3: PIA0; SolderJumper-2_P1.3mm_Open_Pad1.0x1.5mm
JP4: PIA1; SolderJumper-2_P1.3mm_Open_Pad1.0x1.5mm
Q1, Q2, Q3, Q4, Q5, Q6, Q7, Q8, Q9: MMBT3904-TP; SOT-23_MCC
R1, R16, R17, R23, R31, R33, R35: 1K; R_0805_2012Metric_Pad1.20x1.40mm_HandSolder
R2, R4, R6, R14, R15, R18: 10K; R_0805_2012Metric_Pad1.20x1.40mm_HandSolder
R3, R5, R7, R13, R19, R20, R21, R22, R32, R34, R36: 4.7K; R_0805_2012Metric_Pad1.20x1.40mm_HandSolder
R8, R9, R25, R26: 47K; R_0805_2012Metric_Pad1.20x1.40mm_HandSolder
R10, R11, R12: 75; R_0805_2012Metric_Pad1.20x1.40mm_HandSolder
R24: 100K; R_0805_2012Metric_Pad1.20x1.40mm_HandSolder
RN1, RN2, RN3, RN4: 4.7K; R_Array_SIP9
SW1: ALT; SW_Cherry_MX_1.00u_PCB
SW2: CTRL; SW_Cherry_MX_1.00u_PCB
SW3: F1; SW_Cherry_MX_1.00u_PCB
SW4: F2; SW_Cherry_MX_1.00u_PCB
U1: 74HCT138; TSSOP-16_4.4x5mm_P0.65mm
U2: AT28C64B-15PU; 28P6_ATM
U3, U6: 74HC139; TSSOP-16_4.4x5mm_P0.65mm
U4, U8, U10, U11, U12, U13, U14, U15: 74LVC245; TSSOP-20_4.4x6.5mm_P0.65mm
U5, U17: Tang_Nano_20k
U7: 74HCT30; TSSOP-14_4.4x5mm_P0.65mm
U9, U16: 74HCT245; TSSOP-20_4.4x6.5mm_P0.65mm
U22: 74HCT11; TSSOP-14_4.4x5mm_P0.65mm

Connections:
+3.3V: C3.1, C4.1, C5.1, C6.1, C7.1, C14.1, C15.1, C16.1, C18.1, C19.1, C29.1, C30.1, C31.1, J7.5, J10.5, J18.5, Q2.3, Q4.3, Q5.3, R4.1, R18.1, U3.16, U4.1 (A->B), U4.20 (VCC), U5.19 (3V3), U5.25 (3V3), U6.16, U8.1 (A->B), U8.20 (VCC), U9.1 (A->B), U10.1 (A->B), U10.20 (VCC), U11.1 (A->B), U11.20 (VCC), U12.20 (VCC), U13.1 (A->B), U13.20 (VCC), U14.20 (VCC), U15.1 (A->B), U15.20 (VCC), U16.1 (A->B), U17.19 (3V3), U17.25 (3V3)
+5V: C1.1, C2.1, C13.1, C32.1, C33.1, C34.1, D2.2 (A), D4.2 (A), J1.7, J4.20, J13.9, J19.7, J28.13, J28.14, J28.15, J28.16, R13.1, R19.1, RN1.1 (common), RN2.1 (common), RN3.1 (common), RN4.1 (common), U1.16 (VCC), U2.27 (*WE), U2.28 (VCC), U7.12, U7.14, U9.20 (VCC), U16.20 (VCC), U22.5, U22.14
A0: J1.8, J13.19, J19.8, RN1.2 (R1), RN4.2 (R1), U2.10 (A0), U4.2 (A0), U8.2 (A0)
A1: J1.9, J13.20, J19.9, RN1.3 (R2), RN4.3 (R2), U2.9 (A1), U4.3 (A1), U8.3 (A1)
A2: J1.10, J13.21, J19.10, RN1.4 (R3), RN4.4 (R3), U2.8 (A2), U4.4 (A2), U8.4 (A2)
A3: J1.11, J13.22, J19.11, RN1.5 (R4), RN4.5 (R4), U2.7 (A3), U4.5 (A3), U8.5 (A3)
A4: J1.12, J13.23, J19.12, RN1.6 (R5), RN4.6 (R5), U2.6 (A4), U4.6 (A4), U8.6 (A4)
A5: J1.13, J13.24, J19.13, RN1.7 (R6), RN4.7 (R6), U2.5 (A5), U4.7 (A5), U8.7 (A5)
A6: J1.14, J13.25, J19.14, RN1.8 (R7), RN4.8 (R7), U2.4 (A6), U4.8 (A6), U8.8 (A6)
A7: J1.15, J13.26, J19.15, RN1.9 (R8), RN4.9 (R8), U2.3 (A7), U4.9 (A7), U8.9 (A7)
A8: J1.16, J13.27, J19.16, RN2.2 (R1), RN3.2 (R1), U2.25 (A8), U10.5 (A3), U13.5 (A3)
A9: J1.17, J13.28, J19.17, RN2.3 (R2), RN3.3 (R2), U2.24 (A9), U10.6 (A4), U13.6 (A4)
A10: J1.18, J13.29, J19.18, RN2.4 (R3), RN3.4 (R3), U2.21 (A10), U10.7 (A5), U13.7 (A5)
A11: J1.19, J13.30, J19.19, RN2.5 (R4), RN3.5 (R4), U2.23 (A11), U10.8 (A6), U13.8 (A6)
A12: J1.20, J13.31, J19.20, RN2.6 (R5), RN3.6 (R5), U2.2 (A12), U10.9 (A7), U13.9 (A7)
A13: J1.21, J13.37, J19.21, RN2.9 (R8), RN3.9 (R8), U10.4 (A2), U13.4 (A2)
A14: J1.22, J13.38, J19.22, RN2.8 (R7), RN3.8 (R7), U10.3 (A1), U13.3 (A1)
A15: J1.23, J13.39, J19.23, RN2.7 (R6), RN3.7 (R6), U10.2 (A0), U13.2 (A0)
AP19: J4.19
AP21: J4.21
AP22: J4.22
AP23: J4.23
AP24: J4.24
AP25: J4.25
AP26: J4.26
AP27: J4.27
AP28: J4.28
AP29: J4.29
AP30: J4.30
AP31: J4.31
AP32: J4.32
AP33: J4.33
AP34: J4.34
AP35: J4.35
AP36: J4.36
AP37: J4.37
AP38: J4.38
AP39: J4.39
AUDIO_33: J7.4, J10.4, J18.4, R23.1, U5.30 (55_IOR36B), U17.30 (55_IOR36B)
AUDIO_RCA: C25.2, J24.3, R24.2
B_CHR: C9.1, J21.2, J24.5
B_CHR_33: J7.2, J10.2, J18.2, R33.1, U5.33 (54_IOR38A), U17.33 (54_IOR38A)
D0: J1.31, J13.10, J19.31, U2.11 (I/O0), U12.18 (B0), U14.18 (B0)
D0_33: U5.31 (48_IOR49B), U12.2 (A0), U14.2 (A0), U17.31 (48_IOR49B)
D1: J1.30, J13.11, J19.30, U2.12 (I/O1), U12.17 (B1), U14.17 (B1)
D1_33: U5.29 (49_IOR49A), U12.3 (A1), U14.3 (A1), U17.29 (49_IOR49A)
D2: J1.29, J13.12, J19.29, U2.13 (I/O2), U12.16 (B2), U14.16 (B2)
D2_33: U5.28 (86_IOT4A), U12.4 (A2), U14.4 (A2), U17.28 (86_IOT4A)
D3: J1.28, J13.13, J19.28, U2.15 (I/O3), U12.15 (B3), U14.15 (B3)
D3_33: U5.27 (79_IOT27B), U12.5 (A3), U14.5 (A3), U17.27 (79_IOT27B)
D4: J1.27, J13.14, J19.27, U2.16 (I/O4), U12.14 (B4), U14.14 (B4)
D4_33: U5.24 (72_IOT40B), U12.6 (A4), U14.6 (A4), U17.24 (72_IOT40B)
D5: J1.26, J13.15, J19.26, U2.17 (I/O5), U12.13 (B5), U14.13 (B5)
D5_33: U5.23 (71_IOT44A), U12.7 (A5), U14.7 (A5), U17.23 (71_IOT44A)
D6: J1.25, J13.16, J19.25, U2.18 (I/O6), U12.12 (B6), U14.12 (B6)
D6_33: U5.22 (53_IOR38B), U12.8 (A6), U14.8 (A6), U17.22 (53_IOR38B)
D7: J1.24, J13.17, J19.24, U2.19 (I/O7), U12.11 (B7), U14.11 (B7)
D7_33: U5.21 (52_IOR39A), U12.9 (A7), U14.9 (A7), U17.21 (52_IOR39A)
DATADIR: J2.6, J3.6, J17.6, U12.1 (A->B), U14.1 (A->B), U22.4, U22.8
E: J1.34, J13.6, J19.34, R8.1, R25.1, U9.15 (B3), U16.15 (B3)
E_33: U5.32 (51_IOR45A), U9.5 (A3), U16.5 (A3), U17.32 (51_IOR45A)
FIRQ_33: R6.2, R7.2, R15.2, R21.2, U5.3 (75_IOT34A), U17.3 (75_IOT34A)
G2A: J28.4, U1.4 (*G2A)
G2B: J28.5, U1.5 (*G2B)
GND: C1.2, C2.2, C3.2, C4.2, C5.2, C6.2, C7.2, C8.2, C9.2, C10.2, C11.2, C12.2, C13.2, C14.2, C15.2, C16.2, C18.2, C19.2, C20.2, C21.2, C22.2, C23.2, C24.1, C29.2, C30.2, C31.2, C32.2, C33.2, C34.2, J1.1, J4.1, J7.6, J10.6, J13.33, J13.34, J18.6, J19.1, J24.2, J28.8, Q1.2, Q3.2, Q6.2, Q7.2, Q8.2, Q9.2, R1.2, R2.1, R6.1, R8.2, R9.2, R14.1, R15.1, R16.2, R17.2, R24.1, R25.2, R26.2, R32.2, R34.2, R36.2, U1.8 (GND), U2.14 (GND), U2.20 (*CE), U3.1, U3.8, U4.10 (GND), U5.20 (GND), U5.26 (GND), U5.39 (GND), U6.1, U6.8, U7.7, U8.10 (GND), U9.10 (GND), U9.19 (CE), U10.10 (GND), U11.10 (GND), U12.10 (GND), U13.10 (GND), U14.10 (GND), U15.10 (GND), U16.10 (GND), U16.19 (CE), U17.20 (GND), U17.26 (GND), U17.39 (GND), U22.7
G_Y: C8.1, J24.1, R10.2
G_Y_33: J7.1, J10.1, J18.1, R31.1, U5.34 (56_IOR36A), U17.34 (56_IOR36A)
IRQ_33: R2.2, R3.2, R14.2, R20.2, U5.17 (19_IOL51A_LED4), U17.17 (19_IOL51A_LED4)
KEYINT: J8.3, J14.3, J16.3, U7.8, U11.7 (A5), U15.7 (A5)
MP0_33: U4.18 (B0), U5.5 (77_IOT30A), U8.18 (B0), U10.18 (B0), U11.18 (B0), U13.18 (B0), U15.18 (B0), U17.5 (77_IOT30A)
MP1_33: U4.17 (B1), U5.8 (27_IOB8A), U8.17 (B1), U10.17 (B1), U11.17 (B1), U13.17 (B1), U15.17 (B1), U17.8 (27_IOB8A)
MP2_33: U4.16 (B2), U5.9 (28_IOB8B), U8.16 (B2), U10.16 (B2), U11.16 (B2), U13.16 (B2), U15.16 (B2), U17.9 (28_IOB8B)
MP3_33: U4.15 (B3), U5.10 (25_IOB6A), U8.15 (B3), U10.15 (B3), U11.15 (B3), U13.15 (B3), U15.15 (B3), U17.10 (25_IOB6A)
MP4_33: U4.14 (B4), U5.11 (26_IOB6B), U8.14 (B4), U10.14 (B4), U11.14 (B4), U13.14 (B4), U15.14 (B4), U17.11 (26_IOB6B)
MP5_33: U4.13 (B5), U5.12 (29_IOB14A), U8.13 (B5), U10.13 (B5), U11.13 (B5), U13.13 (B5), U15.13 (B5), U17.12 (29_IOB14A)
MP6_33: U4.12 (B6), U5.13 (30_IOB14B), U8.12 (B6), U10.12 (B6), U11.12 (B6), U13.12 (B6), U15.12 (B6), U17.13 (30_IOB14B)
MP7_33: U4.11 (B7), U5.14 (31_IOB29A), U8.11 (B7), U10.11 (B7), U11.11 (B7), U13.11 (B7), U15.11 (B7), U17.14 (31_IOB29A)
MSEL0: U3.4, U4.19 (CE), U6.4, U8.19 (CE)
MSEL0_33: U3.2, U5.15 (17_IOL49A_LED2), U6.2, U17.15 (17_IOL49A_LED2)
MSEL1: U3.5, U6.5, U10.19 (CE), U13.19 (CE)
MSEL1_33: U3.3, U5.16 (20_IOL51B_LED5), U6.3, U17.16 (20_IOL51B_LED5)
MSEL2: U3.6, U6.6, U11.19 (CE), U15.19 (CE)
unnamed: C24.2, C25.1, R23.2
unnamed: C10.1, D1.1 (K), J23.1
unnamed: C20.1, C21.1, D2.1 (K), U5.40 (5V)
unnamed: C12.1, D3.1 (K), J23.2
unnamed: C22.1, C23.1, D4.1 (K), U17.40 (5V)
unnamed: C17.1, J21.1, R11.2
unnamed: C17.2, J21.3
unnamed: Q1.1, R20.1
unnamed: Q2.1, R31.2, R32.1
unnamed: Q2.2, R10.1, R17.1
unnamed: Q3.1, R21.1
unnamed: Q4.1, R33.2, R34.1
unnamed: Q4.2, R1.1, R11.1
unnamed: Q5.1, R35.2, R36.1
unnamed: Q5.2, R12.1, R16.1
unnamed: Q6.1, R22.1
unnamed: Q7.1, R3.1
unnamed: Q8.1, R7.1
unnamed: Q9.1, R5.1
PA0: J4.2, U7.1
PA1: J4.3, U7.2
PA2: D3.2 (A), J4.4, U7.3
PA3: D1.2 (A), J4.5, U7.4
PA4: J4.6, U7.5
PA5: J4.7, U7.6
PA6: J4.8, J5.1, J9.1, SW1.1, SW2.1, SW3.1, SW4.1, U7.11
PA7: J4.9
PB0: J4.10, JP4.2 (B)
PB1: J4.11
PB2: J4.12
PB3: J4.13, J5.2, J9.2, SW1.2
PB4: J4.14, J5.3, J9.3, SW2.2
PB5: J4.15, J5.4, J9.4, SW3.2
PB6: J4.16, J5.5, J9.5, SW4.2
PB7: J4.17
PIA0: J28.11, U1.11 (Y4), U22.11
PIA1: J28.10, U1.10 (Y5), U22.10
Q: J1.35, J13.7, J19.35, JP1.1 (A), R9.1, R26.1, U9.16 (B2), U16.16 (B2)
Q_33: U5.38 (76_IOT30B), U9.4 (A2), U16.4 (A2), U17.38 (76_IOT30B)
RESET_33: R4.2, R5.2, R18.2, R22.2, U5.36 (42_IOB42B), U17.36 (42_IOB42B)
R_CVBS: C11.1, J24.4, R12.2
R_CVBS_33: J7.3, J10.3, J18.3, R35.1, U5.18 (18_IOL49B_LED3), U17.18 (18_IOL49B_LED3)
R/~W: J1.32, J2.7, J3.7, J13.18, J17.7, J19.32, R13.2, R19.2, U11.2 (A0), U15.2 (A0), U22.9
S0: J2.1, J3.1, J17.1, J28.1, U1.1 (A), U9.14 (B4), U16.14 (B4)
S0_33: U5.6 (15_IOL47A_LED0), U9.6 (A4), U16.6 (A4), U17.6 (15_IOL47A_LED0)
S1: J2.2, J3.2, J17.2, J28.2, U1.2 (B), U9.13 (B5), U16.13 (B5)
S1_33: U5.35 (41_IOB43A), U9.7 (A5), U16.7 (A5), U17.35 (41_IOB43A)
S2: J2.3, J3.3, J17.3, J28.3, U1.3 (C), U9.12 (B6), U16.12 (B6)
S2_33: U5.7 (16_IOL47B_LED1), U9.8 (A6), U16.8 (A6), U17.7 (16_IOL47B_LED1)
SERNT: J12.2, J15.2, U11.5 (A3), U15.5 (A3)
SND: J13.35
TSC: J1.39, J19.39
~CART: J12.1, J13.8, J15.1, JP1.2 (B), U11.6 (A4), U15.6 (A4)
~CTS: J13.32, J28.12, U1.12 (Y3), U2.22 (*OE)
~DATAEN: J2.5, J3.5, J17.5, U12.19 (CE), U14.19 (CE), U22.6
~EXTROM: U1.13 (Y2), U22.13
~FIRQ: J1.4, J19.4, Q3.3, Q8.3
~FS_33: U5.2 (74_IOT34B), U9.2 (A0), U16.2 (A0), U17.2 (74_IOT34B)
~FS/CART: J4.18, J8.1
~FS: J14.1, J16.1, U9.18 (B0), U16.18 (B0)
~HALT: J1.40, J13.3, J19.40, U11.8 (A6), U15.8 (A6)
~HS_33: U5.1 (73_IOT40A), U9.3 (A1), U16.3 (A1), U17.1 (73_IOT40A)
~HS: J4.40, J14.2, J16.2, JP3.2 (B), U9.17 (B1), U16.17 (B1)
~HS/SERNT: J8.2, JP3.1 (A), JP4.1 (A)
~IRQ: J1.3, J19.3, Q1.3, Q7.3
~MENEN: U22.3, U22.12
~MRD: U1.15 (Y0), U22.1
~NMI: J1.2, J13.4, J19.2, U11.9 (A7), U15.9 (A7)
~RESET: J1.37, J13.5, J19.37, Q6.3, Q9.3, U11.3 (A1), U15.3 (A1)
~ROM: U1.14 (Y1), U22.2
~SCS: J13.36, J28.9, U1.9 (Y6)
~SLENB: J2.4, J3.4, J13.40, J17.4, J28.6, U1.6 (G1), U11.4 (A2), U15.4 (A2)

Notes on the sheet:
ADDRMUX DAUGHTERBOARD
26-3136 / 20261043
26-3134B / 20261058
EXTERNAL KEYBOARD EXTENSION
HBDOS-CART
PIA0 / PIA1 (SC67331/MC6821) DAUGHTERBOARD
VIDEO COMPONENT HAT

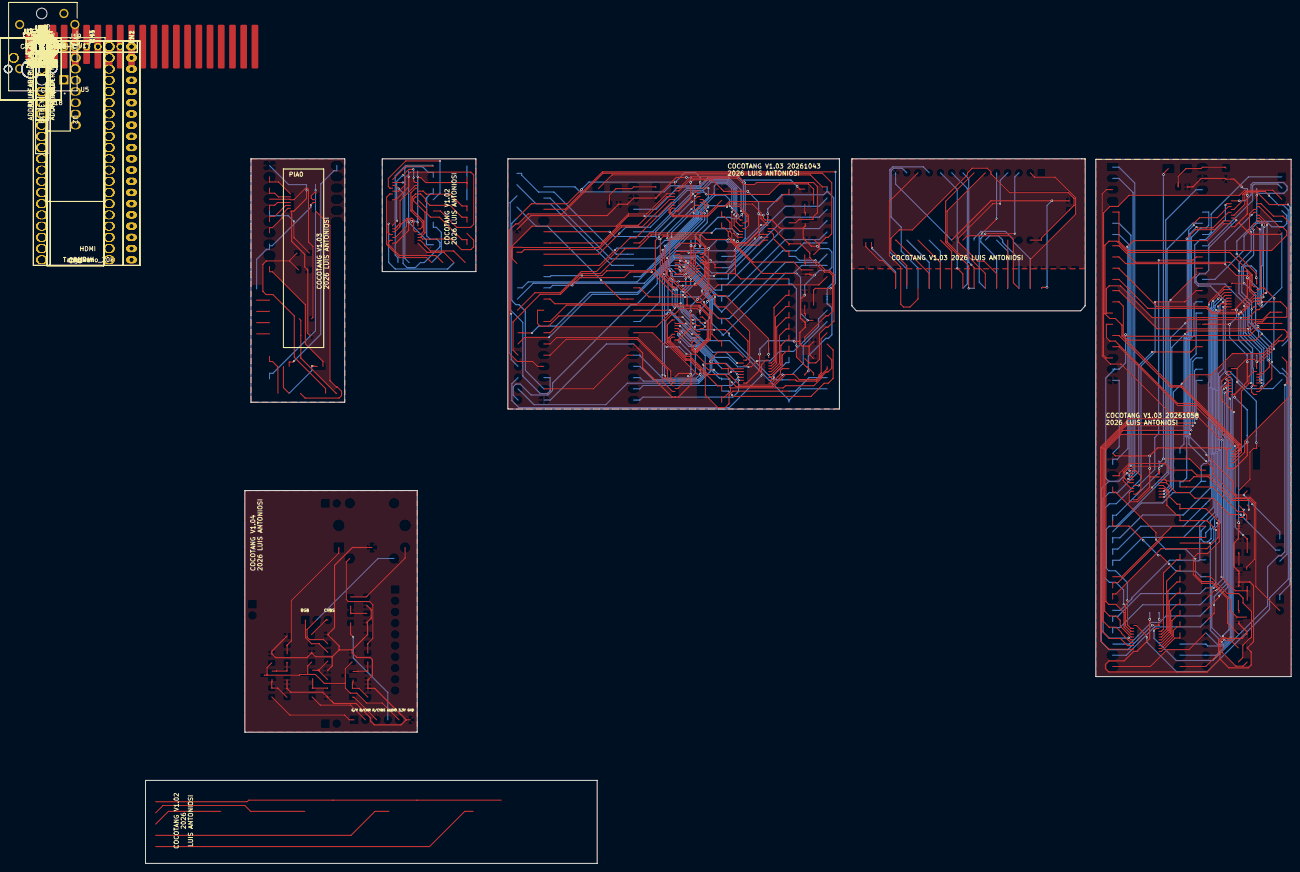
[picture p50: board CoCoTANG.kicad_pcb from above]

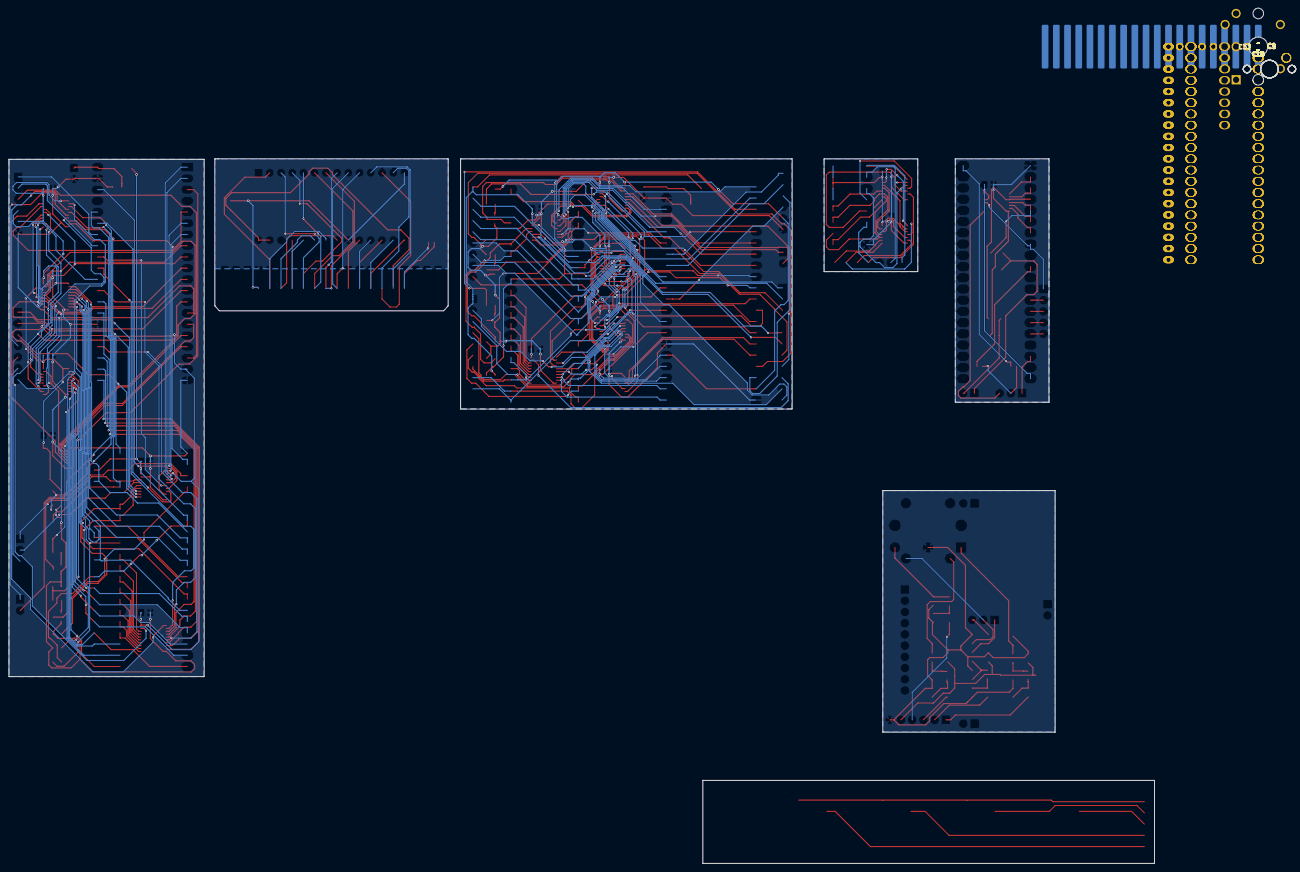
[picture p51: board CoCoTANG.kicad_pcb from below]

Board: 2 copper layers, 259.3 x 159.5 mm, 131 parts (15 on the bottom side), 129 nets.
