lfantoniosi/CoCoTANG/kicad/CoCoTANGv1.0.0-ADDRMUX.kicad_pcb

## KiCad design kicad/CoCoTANGv1.0.0-ADDRMUX.kicad_pcb (2026-09-28)

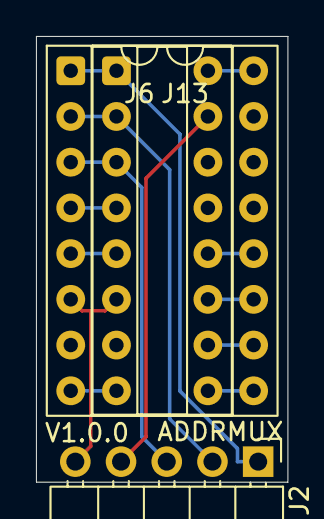
[picture p52: board CoCoTANGv1.0.0-ADDRMUX.kicad_pcb from above]

Board: 2 copper layers, 14.0 x 24.8 mm, 3 parts (0 on the bottom side), 13 nets.

Parts:
J2: ADDRMUX; PinHeader_1x05_P2.54mm_Horizontal
J6: ADDRMUX; DIP-16_W7.62mm_Socket
J13: ADDRMUX_SOCKET; DIP-16_W7.62mm_Socket

Connections:
DP4: J6.4, J13.4
DP5: J6.5, J13.5
DP8: J6.8, J13.8
DP16: J6.16, J13.16
PIA0: J6.11, J13.11
PIA1: J6.10, J13.10
S0: J2.1, J6.1, J13.1
S1: J2.2, J6.2, J13.2
S2: J2.3, J6.3, J13.3
~CTS: J6.12, J13.12
~MRD: J2.4, J6.15
~SCS: J6.9, J13.9
~SLENB: J2.5, J6.6, J13.6
