lfantoniosi/CoCoTANG/kicad/SC67331_Board.kicad_pcb

## KiCad design kicad/SC67331_Board.kicad_pcb (2026-09-28)

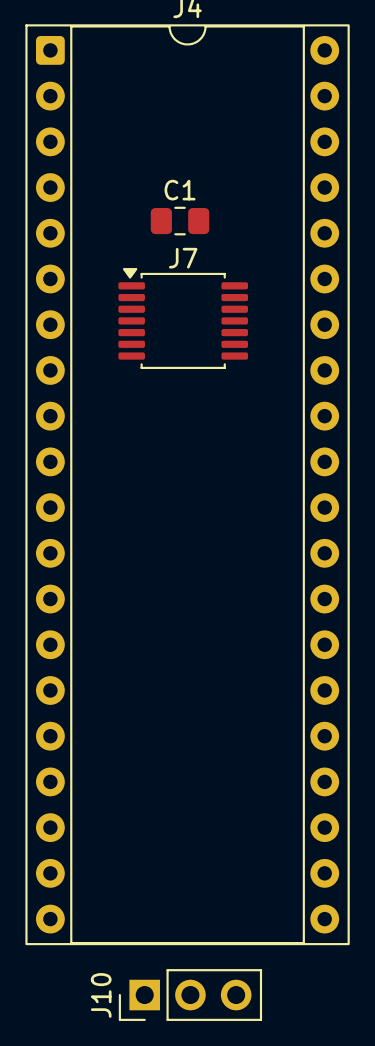
[picture p53: board SC67331_Board.kicad_pcb from above]

Board: 2 copper layers, 4 parts (0 on the bottom side), 12 nets, no tracks yet.

Parts:
C1: 104; C_0805_2012Metric_Pad1.18x1.45mm_HandSolder
J4: SC67331; DIP-40_W15.24mm_Socket
J7: 74HC30; TSSOP-14_4.4x5mm_P0.65mm
J10: SC67331_HEADER; PinHeader_1x03_P2.54mm_Vertical

Connections:
+5V: C1.1, J4.20, J7.12, J7.14
FS: J4.18, J10.2
GND: C1.2, J4.1, J7.7
HS: J4.40, J10.1
KEYINT: J7.8, J10.3
ROW0: J4.2, J7.1
ROW1: J4.3, J7.2
ROW2: J4.4, J7.3
ROW3: J4.5, J7.4
ROW4: J4.6, J7.5
ROW5: J4.7, J7.6
ROW6: J4.8, J7.11
