lfantoniosi/CoCoTANG/kicad/CoCoTANG-CPU.kicad_pcb

## KiCad design kicad/CoCoTANG-CPU.kicad_pcb (2026-09-04)

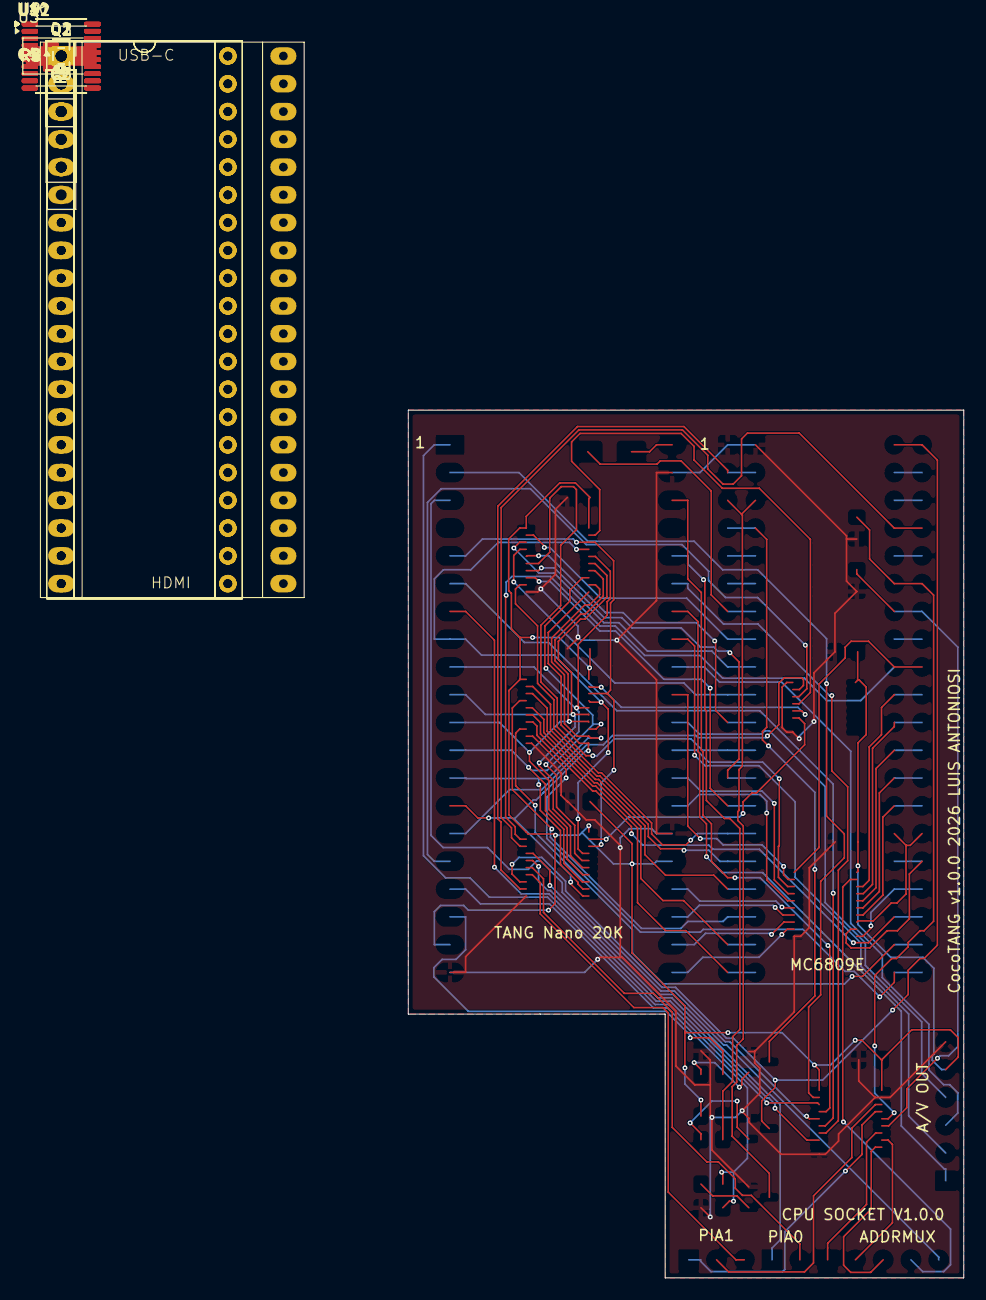
[picture p54: board CoCoTANG-CPU.kicad_pcb from above]

Board: 2 copper layers, 50.8 x 79.4 mm, 31 parts (0 on the bottom side), 90 nets.

Parts:
C2, C3, C4, C5, C6, C7: 104; C_0805_2012Metric_Pad1.18x1.45mm_HandSolder
D2: SS14; D_SMA
J1: CPU; DIP-40_W15.24mm_Socket
J2: ADDRMUX; PinHeader_1x05_P2.54mm_Vertical
J3: CPU_SOCKET; DIP-40_W15.24mm_Socket
J7: AV_HEADER; PinSocket_1x06_P2.54mm_Vertical
J10: PIA0; PinHeader_1x03_P2.54mm_Vertical
J11: PIA1; PinHeader_1x02_P2.54mm_Vertical
Q1, Q2, Q3: 2N3904; SOT-23
R2, R4, R6: 10K; R_0805_2012Metric_Pad1.20x1.40mm_HandSolder
R3, R5, R7: 4.7K; R_0805_2012Metric_Pad1.20x1.40mm_HandSolder
R8, R9: 47K; R_0805_2012Metric_Pad1.20x1.40mm_HandSolder
U3: 74HC139; TSSOP-16_4.4x5mm_P0.65mm
U5: Tang_Nano_20k
U8, U9, U10, U11, U12: SN74LVC245AN; TSSOP-20_4.4x6.5mm_P0.65mm

Connections:
+3.3V: C2.1, C3.1, C4.1, C5.1, C6.1, C7.1, J7.5, R4.1, U3.16, U5.19 (3V3), U5.25 (3V3), U8.1 (A->B), U8.20 (VCC), U9.1 (A->B), U9.20 (VCC), U10.1 (A->B), U10.20 (VCC), U11.1 (A->B), U11.20 (VCC), U12.20 (VCC)
+5V: D2.2 (A), J1.7, J3.7
A0: J1.8, J3.8, U8.2 (A0)
A1: J1.9, J3.9, U8.3 (A1)
A2: J1.10, J3.10, U8.4 (A2)
A3: J1.11, J3.11, U8.5 (A3)
A4: J1.12, J3.12, U8.6 (A4)
A5: J1.13, J3.13, U8.7 (A5)
A6: J1.14, J3.14, U8.8 (A6)
A7: J1.15, J3.15, U8.9 (A7)
A8: J1.16, J3.16, U10.2 (A0)
A9: J1.17, J3.17, U10.3 (A1)
A10: J1.18, J3.18, U10.4 (A2)
A11: J1.19, J3.19, U10.5 (A3)
A12: J1.20, J3.20, U10.6 (A4)
A13: J1.21, J3.21, U10.9 (A7)
A14: J1.22, J3.22, U10.8 (A6)
A15: J1.23, J3.23, U10.7 (A5)
AUDIO_33: J7.4, U5.30 (55_IOR36B)
CP5: J1.5, J3.5
CP6: J1.6, J3.6
CP33: J1.33, J3.33
CP36: J1.36, J3.36
CP38: J1.38, J3.38
CP39: J1.39, J3.39
D0: J1.24, J3.24, U12.11 (B7)
D0_33: U5.21 (52_IOR39A), U12.9 (A7)
D1: J1.25, J3.25, U12.12 (B6)
D1_33: U5.22 (53_IOR38B), U12.8 (A6)
D2: J1.26, J3.26, U12.13 (B5)
D2_33: U5.23 (71_IOT44A), U12.7 (A5)
D3: J1.27, J3.27, U12.14 (B4)
D3_33: U5.24 (72_IOT40B), U12.6 (A4)
D4: J1.28, J3.28, U12.15 (B3)
D4_33: U5.27 (79_IOT27B), U12.5 (A3)
D5: J1.29, J3.29, U12.16 (B2)
D5_33: U5.28 (86_IOT4A), U12.4 (A2)
D6: J1.30, J3.30, U12.17 (B1)
D6_33: U5.29 (49_IOR49A), U12.3 (A1)
D7: J1.31, J3.31, U12.18 (B0)
D7_33: U5.31 (48_IOR49B), U12.2 (A0)
E: J1.34, J3.34, R8.1, U9.15 (B3)
E_33: U5.3 (75_IOT34A), U9.5 (A3)
FIRQ_33: R6.2, R7.2, U5.18 (18_IOL49B_LED3)
GND: C2.2, C3.2, C4.2, C5.2, C6.2, C7.2, J1.1, J3.1, J7.6, Q1.1 (E), Q2.1 (E), Q3.1 (E), R2.1, R6.1, R8.2, R9.2, U3.1, U3.8, U5.20 (GND), U5.26 (GND), U5.39 (GND), U8.10 (GND), U9.10 (GND), U9.19 (CE), U10.10 (GND), U11.10 (GND), U12.10 (GND)
HALT_33: R4.2, R5.2, U5.36 (42_IOB42B)
IRQ_33: R2.2, R3.2, U5.17 (19_IOL51A_LED4)
KEYINT: J10.3, U11.7 (A5)
MP0_33: U5.5 (77_IOT30A), U8.18 (B0), U10.18 (B0), U11.18 (B0)
MP1_33: U5.8 (27_IOB8A), U8.17 (B1), U10.17 (B1), U11.17 (B1)
MP2_33: U5.9 (28_IOB8B), U8.16 (B2), U10.16 (B2), U11.16 (B2)
MP3_33: U5.10 (25_IOB6A), U8.15 (B3), U10.15 (B3), U11.15 (B3)
MP4_33: U5.11 (26_IOB6B), U8.14 (B4), U10.14 (B4), U11.14 (B4)
MP5_33: U5.12 (29_IOB14A), U8.13 (B5), U10.13 (B5), U11.13 (B5)
MP6_33: U5.13 (30_IOB14B), U8.12 (B6), U10.12 (B6), U11.12 (B6)
MP7_33: U5.14 (31_IOB29A), U8.11 (B7), U10.11 (B7), U11.11 (B7)
MSEL0: U3.4, U8.19 (CE)
MSEL0_33: U3.2, U5.15 (17_IOL49A_LED2)
MSEL1: U3.5, U10.19 (CE)
MSEL1_33: U3.3, U5.16 (20_IOL51B_LED5)
MSEL2: U3.6, U11.19 (CE)
unnamed: D2.1 (K), U5.40 (5V)
unnamed: Q1.2 (B), R3.1
unnamed: Q2.2 (B), R5.1
unnamed: Q3.2 (B), R7.1
PB_33: J7.2, U5.33 (54_IOR38A)
PR_33: J7.3, U5.32 (51_IOR45A)
Q: J1.35, J3.35, R9.1, U9.16 (B2)
Q_33: U5.38 (78_IOT30B), U9.4 (A2)
R/~W: J1.32, J3.32, U11.2 (A0), U12.1 (A->B)
S0: J2.1, U9.14 (B4)
S0_33: U5.6 (15_IOL47A_LED0), U9.6 (A4)
S1: J2.2, U9.13 (B5)
S1_33: U5.35 (41_IOB43A), U9.7 (A5)
S2: J2.3, U9.12 (B6)
S2_33: U5.7 (16_IOL47B_LED1), U9.8 (A6)
SERNT: J11.1, U11.5 (A3)
Y_33: J7.1, U5.34 (56_IOR36A)
~CART: J11.2, U11.6 (A4)
~FIRQ: J1.4, J3.4, Q3.3 (C)
~FS_33: U5.2 (74_IOT34B), U9.2 (A0)
~FS: J10.2, U9.18 (B0)
~HALT: J1.40, J3.40, Q2.3 (C), U11.8 (A6)
~HS_33: U5.1 (73_IOT40A), U9.3 (A1)
~HS: J10.1, U9.17 (B1)
~IRQ: J1.3, J3.3, Q1.3 (C)
~MRD: J2.4, U12.19 (CE)
~NMI: J1.2, J3.2, U11.9 (A7)
~RESET: J1.37, J3.37, U11.3 (A1)
~SLENB: J2.5, U11.4 (A2)
