lfantoniosi/CoCoTANG/kicad/CoCoTANG-VDG.kicad_pcb

## KiCad design kicad/CoCoTANG-VDG.kicad_pcb (2026-09-04)

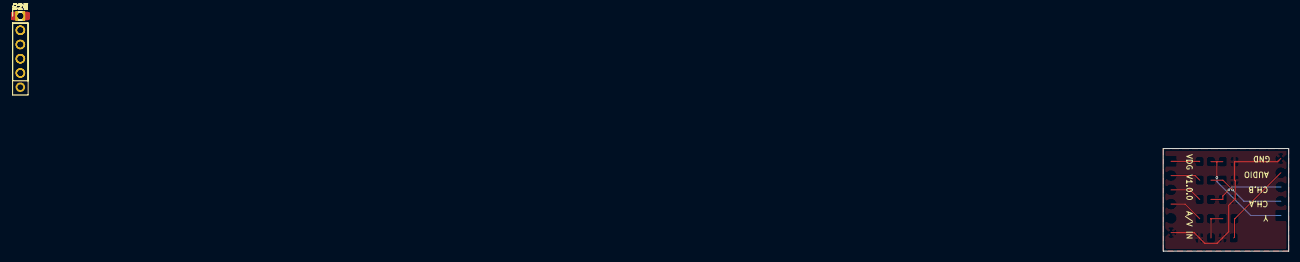
[picture p55: board CoCoTANG-VDG.kicad_pcb from above]

Board: 2 copper layers, 22.4 x 18.3 mm, 12 parts (0 on the bottom side), 10 nets.

Parts:
C17, C18, C19: 68pF; C_0805_2012Metric_Pad1.18x1.45mm_HandSolder
C20: 4.7uF; C_0805_2012Metric_Pad1.18x1.45mm_HandSolder
C21: 6.8nF; C_0805_2012Metric_Pad1.18x1.45mm_HandSolder
J16: VDG_IN; PinHeader_1x06_P2.54mm_Vertical
J19: VDG_OUT; PinHeader_1x05_P2.54mm_Vertical
R16: 1K; R_0805_2012Metric_Pad1.20x1.40mm_HandSolder
R17: 100K; R_0805_2012Metric_Pad1.20x1.40mm_HandSolder
R19, R20, R21: 100; R_0805_2012Metric_Pad1.20x1.40mm_HandSolder

Connections:
AUDIO_33: J16.4, R16.1
AUDIO_RCA: C20.2, J19.4, R17.2
CHA_33: J16.2, R20.1
CHA_VDG: C18.1, J19.2, R20.2
CHB_33: J16.3, R21.1
CHB_VDG: C19.1, J19.3, R21.2
GND: C17.2, C18.2, C19.2, C21.1, J16.6, J19.5, R17.1
unnamed: C20.1, C21.2, R16.2
Y_33: J16.1, R19.1
Y_VDG: C17.1, J19.1, R19.2
