lfantoniosi/CoCoTANG/kicad/CoCoTANG-PIA1.kicad_pcb

## KiCad design kicad/CoCoTANG-PIA1.kicad_pcb (2026-09-04)

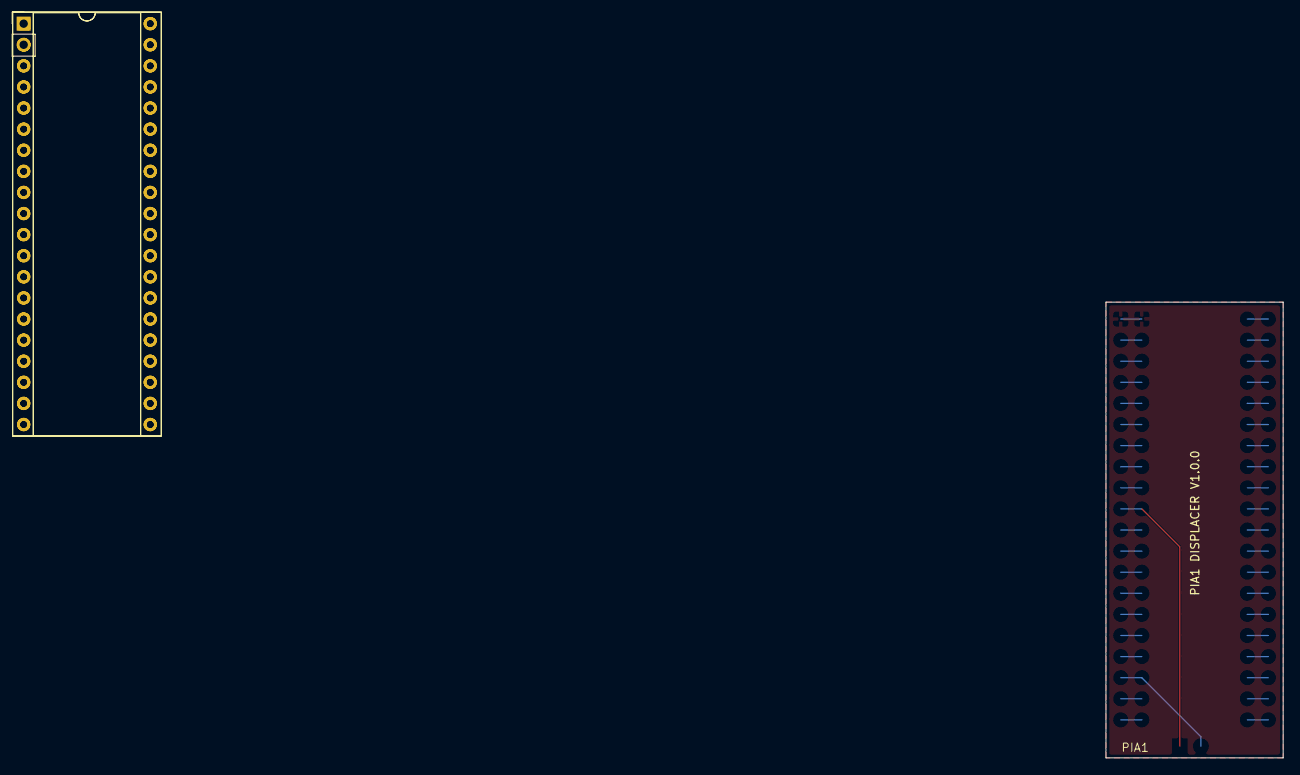
[picture p56: board CoCoTANG-PIA1.kicad_pcb from above]

Board: 2 copper layers, 21.3 x 54.9 mm, 3 parts (0 on the bottom side), 40 nets.

Parts:
J5: PIA1; DIP-40_W15.24mm_Socket
J12: PIA1_SOCKET; DIP-40_W15.24mm_Socket
J15: PIA1; PinHeader_1x02_P2.54mm_Vertical

Connections:
+5V: J5.20, J12.20
BP2: J5.2, J12.2
BP3: J5.3, J12.3
BP4: J5.4, J12.4
BP5: J5.5, J12.5
BP6: J5.6, J12.6
BP7: J5.7, J12.7
BP8: J5.8, J12.8
BP9: J5.9, J12.9
BP11: J5.11, J12.11
BP12: J5.12, J12.12
BP13: J5.13, J12.13
BP14: J5.14, J12.14
BP15: J5.15, J12.15
BP16: J5.16, J12.16
BP17: J5.17, J12.17
BP19: J5.19, J12.19
BP21: J5.21, J12.21
BP22: J5.22, J12.22
BP23: J5.23, J12.23
BP24: J5.24, J12.24
BP25: J5.25, J12.25
BP26: J5.26, J12.26
BP27: J5.27, J12.27
BP28: J5.28, J12.28
BP29: J5.29, J12.29
BP30: J5.30, J12.30
BP31: J5.31, J12.31
BP32: J5.32, J12.32
BP33: J5.33, J12.33
BP34: J5.34, J12.34
BP35: J5.35, J12.35
BP36: J5.36, J12.36
BP37: J5.37, J12.37
BP38: J5.38, J12.38
BP39: J5.39, J12.39
BP40: J5.40, J12.40
GND: J5.1, J12.1
SERNT: J5.10, J12.10, J15.1
~CART: J5.18, J12.18, J15.2
