lfantoniosi/CoCoTANG/kicad/CoCoTANG-PIA0.kicad_pcb

## KiCad design kicad/CoCoTANG-PIA0.kicad_pcb (2026-09-04)

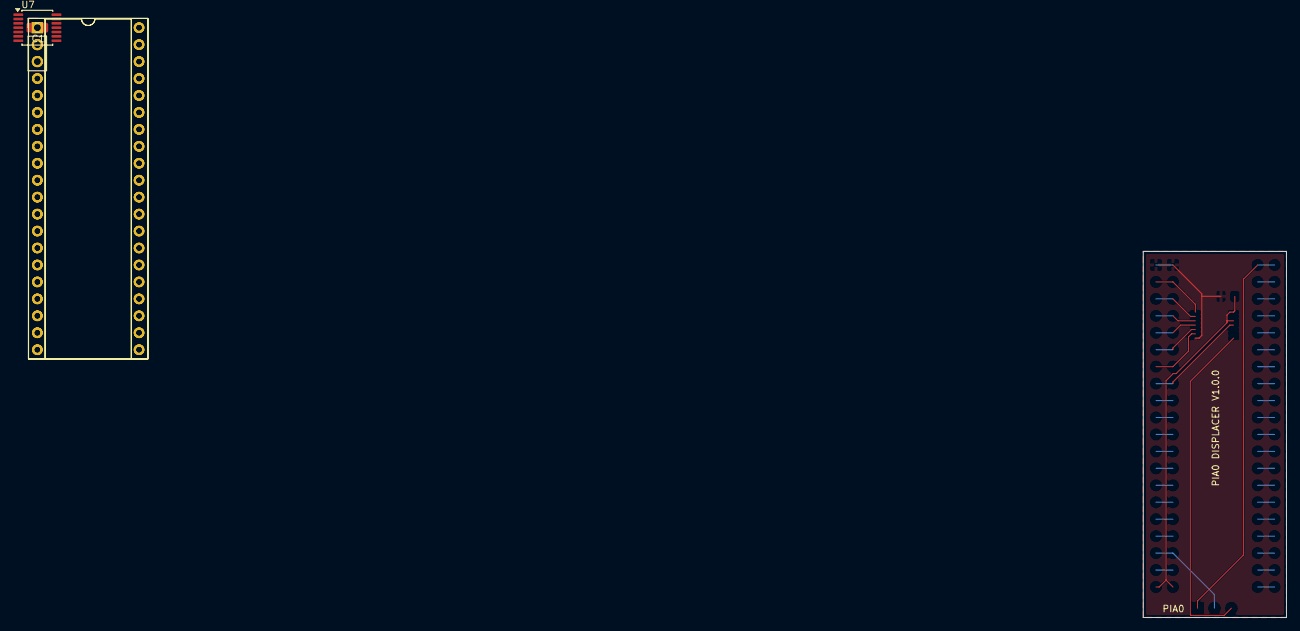
[picture p57: board CoCoTANG-PIA0.kicad_pcb from above]

Board: 2 copper layers, 21.5 x 54.9 mm, 5 parts (0 on the bottom side), 41 nets.

Parts:
C1: 104; C_0805_2012Metric_Pad1.18x1.45mm_HandSolder
J4: PIA0; DIP-40_W15.24mm_Socket
J9: PIA0_SOCKET; DIP-40_W15.24mm_Socket
J14: PIA0; PinHeader_1x03_P2.54mm_Vertical
U7: 74HC30; TSSOP-14_4.4x5mm_P0.65mm

Connections:
+5V: C1.1, J4.20, J9.20, U7.12, U7.14
AP9: J4.9, J9.9
AP10: J4.10, J9.10
AP11: J4.11, J9.11
AP12: J4.12, J9.12
AP13: J4.13, J9.13
AP14: J4.14, J9.14
AP15: J4.15, J9.15
AP16: J4.16, J9.16
AP17: J4.17, J9.17
AP18: J4.19, J9.19
AP21: J4.21, J9.21
AP22: J4.22, J9.22
AP23: J4.23, J9.23
AP24: J4.24, J9.24
AP25: J4.25, J9.25
AP26: J4.26, J9.26
AP27: J4.27, J9.27
AP28: J4.28, J9.28
AP29: J4.29, J9.29
AP30: J4.30, J9.30
AP31: J4.31, J9.31
AP32: J4.32, J9.32
AP33: J4.33, J9.33
AP34: J4.34, J9.34
AP35: J4.35, J9.35
AP36: J4.36, J9.36
AP37: J4.37, J9.37
AP38: J4.38, J9.38
AP39: J4.39, J9.39
GND: C1.2, J4.1, J9.1, U7.7
KEYINT: J14.3, U7.8
ROW0: J4.2, J9.2, U7.1
ROW1: J4.3, J9.3, U7.2
ROW2: J4.4, J9.4, U7.3
ROW3: J4.5, J9.5, U7.4
ROW4: J4.6, J9.6, U7.5
ROW5: J4.7, J9.7, U7.6
ROW6: J4.8, J9.8, U7.11
~FS: J4.18, J9.18, J14.2
~HS: J4.40, J9.40, J14.1
