lfantoniosi/CoCoTANG/kicad/CoCoTANG-SVIDEO.kicad_pcb

## KiCad design kicad/CoCoTANG-SVIDEO.kicad_pcb (2026-09-04)

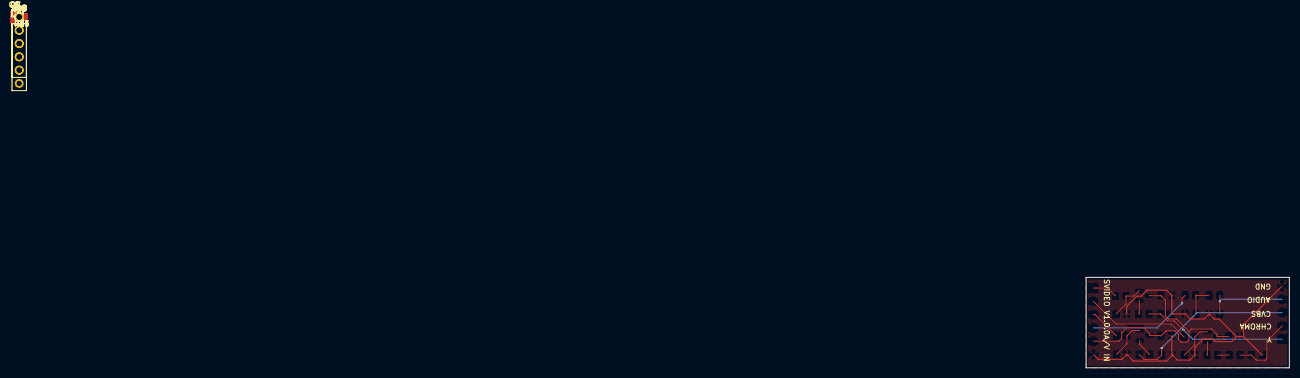
[picture p58: board CoCoTANG-SVIDEO.kicad_pcb from above]

Board: 2 copper layers, 38.9 x 17.3 mm, 25 parts (0 on the bottom side), 18 nets.

Parts:
C13, C16: 470pF; C_0805_2012Metric_Pad1.18x1.45mm_HandSolder
C14: 680pF; C_0805_2012Metric_Pad1.18x1.45mm_HandSolder
C15: 1uF; C_0805_2012Metric_Pad1.18x1.45mm_HandSolder
C22: 6.8nF; C_0805_2012Metric_Pad1.18x1.45mm_HandSolder
C23: 4.7uF; C_0805_2012Metric_Pad1.18x1.45mm_HandSolder
C26, C27, C28: 104; C_0805_2012Metric_Pad1.18x1.45mm_HandSolder
J17: AV_IN; PinHeader_1x06_P2.54mm_Vertical
J20: AV_OUT; PinHeader_1x05_P2.54mm_Vertical
Q7, Q8, Q9: MMBT3904; SOT-23
R13, R14, R15: 75; R_0805_2012Metric_Pad1.20x1.40mm_HandSolder
R18, R25, R27, R29: 1K; R_0805_2012Metric_Pad1.20x1.40mm_HandSolder
R22: 100K; R_0805_2012Metric_Pad1.20x1.40mm_HandSolder
R26, R28, R30: 4.7K; R_0805_2012Metric_Pad1.20x1.40mm_HandSolder

Connections:
+3.3V: C26.1, C27.1, C28.1, J17.5, Q7.3 (C), Q8.3 (C), Q9.3 (C)
AUDIO_33: J17.4, R18.1
AUDIO_RCA: C23.2, J20.4, R22.2
CHROMA_33: J17.2, R27.1
CVBS_33: J17.3, R29.1
CVBS_RCA: C16.1, J20.3, R15.2
C_RCA: C14.1, C15.2, J20.2
GND: C13.2, C14.2, C16.2, C22.1, C26.2, C27.2, C28.2, J17.6, J20.5, R22.1, R26.2, R28.2, R30.2
unnamed: C15.1, R14.1
unnamed: C22.2, C23.1, R18.2
unnamed: Q7.1 (B), R25.2, R26.1
unnamed: Q7.2 (E), R13.2
unnamed: Q8.1 (B), R27.2, R28.1
unnamed: Q8.2 (E), R14.2
unnamed: Q9.1 (B), R29.2, R30.1
unnamed: Q9.2 (E), R15.1
Y_33: J17.1, R25.1
Y_RCA: C13.1, J20.1, R13.1
