lfantoniosi/CoCoTANG/kicad/CoCoTANG-COMP.kicad_pcb

## KiCad design kicad/CoCoTANG-COMP.kicad_pcb (2026-09-04)

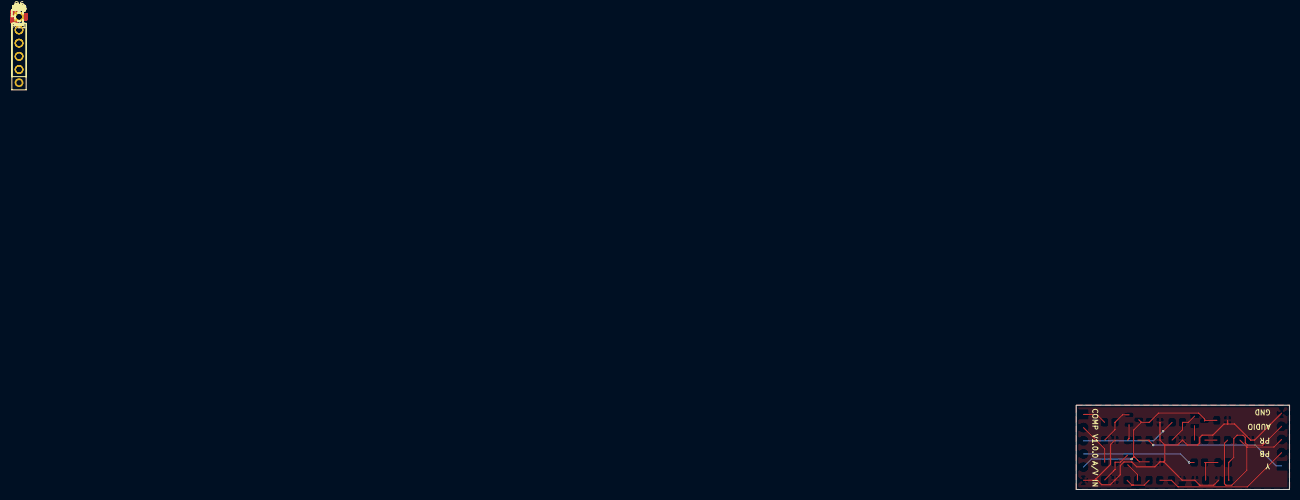
[picture p59: board CoCoTANG-COMP.kicad_pcb from above]

Board: 2 copper layers, 41.1 x 16.3 mm, 26 parts (0 on the bottom side), 19 nets.

Parts:
C8, C9, C11: 470pF; C_0805_2012Metric_Pad1.18x1.45mm_HandSolder
C10, C12: 22uF; C_0805_2012Metric_Pad1.18x1.45mm_HandSolder
C24: 6.8nF; C_0805_2012Metric_Pad1.18x1.45mm_HandSolder
C25: 4.7uF; C_0805_2012Metric_Pad1.18x1.45mm_HandSolder
C29, C30, C31: 104; C_0805_2012Metric_Pad1.18x1.45mm_HandSolder
J18: CMP_IN; PinHeader_1x06_P2.54mm_Vertical
J21: CMP_OUT; PinHeader_1x05_P2.54mm_Vertical
Q4, Q5, Q6: MMBT3904; SOT-23
R10, R11, R12: 75; R_0805_2012Metric_Pad1.20x1.40mm_HandSolder
R23, R31, R33, R35: 1K; R_0805_2012Metric_Pad1.20x1.40mm_HandSolder
R24: 100K; R_0805_2012Metric_Pad1.20x1.40mm_HandSolder
R32, R34, R36: 4.7K; R_0805_2012Metric_Pad1.20x1.40mm_HandSolder

Connections:
+3.3V: C29.1, C30.1, C31.1, J18.5, Q4.3 (C), Q5.3 (C), Q6.3 (C)
AUDIO_33: J18.4, R23.1
AUDIO_RCA: C25.2, J21.4, R24.2
GND: C8.2, C9.2, C11.2, C24.1, C29.2, C30.2, C31.2, J18.6, J21.5, R24.1, R32.2, R34.2, R36.2
unnamed: C10.1, R11.2
unnamed: C12.1, R12.2
unnamed: C24.2, C25.1, R23.2
unnamed: Q4.1 (B), R31.2, R32.1
unnamed: Q4.2 (E), R10.1
unnamed: Q5.1 (B), R33.2, R34.1
unnamed: Q5.2 (E), R11.1
unnamed: Q6.1 (B), R35.2, R36.1
unnamed: Q6.2 (E), R12.1
PB_33: J18.2, R33.1
PB_RCA: C9.1, C10.2, J21.2
PR_33: J18.3, R35.1
PR_RCA: C11.1, C12.2, J21.3
Y_33: J18.1, R31.1
Y_RCA: C8.1, J21.1, R10.2
