lfantoniosi/CoCoTANG/fpga/src/coco3/mc6847_char_rom.v

// MC6847-compatible character generator used by the CoCo 3 GIME's
// compatibility video modes.
module mc6847_char_rom (
    input clk,
    input [10:0] addr,
    output reg [7:0] data
);
    reg [7:0] memory [0:1023];
    integer i;
    initial begin
        for (i = 0; i < 1024; i = i + 1)
            memory[i] = 8'h00;
        memory[3] = 8'h1c;
        memory[4] = 8'h22;
        memory[5] = 8'h02;
        memory[6] = 8'h1a;
        memory[7] = 8'h2a;
        memory[8] = 8'h2a;
        memory[9] = 8'h1c;
        memory[19] = 8'h08;
        memory[20] = 8'h14;
        memory[21] = 8'h22;
        memory[22] = 8'h22;
        memory[23] = 8'h3e;
        memory[24] = 8'h22;
        memory[25] = 8'h22;
        memory[35] = 8'h3c;
        memory[36] = 8'h12;
        memory[37] = 8'h12;
        memory[38] = 8'h1c;
        memory[39] = 8'h12;
        memory[40] = 8'h12;
        memory[41] = 8'h3c;
        memory[51] = 8'h1c;
        memory[52] = 8'h22;
        memory[53] = 8'h20;
        memory[54] = 8'h20;
        memory[55] = 8'h20;
        memory[56] = 8'h22;
        memory[57] = 8'h1c;
        memory[67] = 8'h3c;
        memory[68] = 8'h12;
        memory[69] = 8'h12;
        memory[70] = 8'h12;
        memory[71] = 8'h12;
        memory[72] = 8'h12;
        memory[73] = 8'h3c;
        memory[83] = 8'h3e;
        memory[84] = 8'h20;
        memory[85] = 8'h20;
        memory[86] = 8'h38;
        memory[87] = 8'h20;
        memory[88] = 8'h20;
        memory[89] = 8'h3e;
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
        memory[1000] = 8'h08;
        memory[1001] = 8'h10;
        memory[1011] = 8'h18;
        memory[1012] = 8'h24;
        memory[1013] = 8'h04;
        memory[1014] = 8'h08;
        memory[1015] = 8'h08;
        memory[1017] = 8'h08;
    end
    always @(posedge clk)
        data <= memory[addr[9:0]];
endmodule
