lfantoniosi/CoCoTANG/fpga/src/memory/sdram.v

// Simple SDRAM controller for Tang 20k
// nand2mario
// 
// 2023.3: ported to use GW2AR-18's embedded 64Mbit SDRAM.
//         changed to byte-based access.
// 2022.9: iniital version.
//
// This is a byte-based, low-latency and non-bursting controller for the embedded SDRAM
// on Tang Nano 20K. The SDRAM module is 64Mbit 32bit. (2K rows x 256 columns x 4 banks x 32 bits).
//
// Under default settings (max 66.7Mhz):
// - Data read latency is 4 cycles. 
// - Read/write operations take 5 cycles to complete. There's no overlap between
//   reads/writes.
// - All reads/writes are done with auto-precharge. So user does not need to deal with
//   row activations and precharges.
// - SDRAMs need periodic refreshes or they lose data. So they provide an "auto-refresh"
//   function to do one row of refresh. This "auto-refresh" operation is controlled with
//   the 'refresh' input. 4096 or more refreshes should happen in any 64ms for the memory
//   to not lose data. So the main circuit should invoke auto-refresh at least once 
//   **every ~15us**.
//
// Finally you need a 180-degree phase-shifted clock signal (clk_sdram) for SDRAM. 
// This can be generated with PLL's clkoutp output.
//

module sdram
#(
    // Timing defaults for the project's 108 MHz controller clock.
    parameter         FREQ = 108_000_000,
    parameter         DATA_WIDTH = 32,
    parameter         ROW_WIDTH = 11,  // 2K rows
    parameter         COL_WIDTH = 8,   // 256 words per row (1Kbytes)
    parameter         BANK_WIDTH = 2,  // 4 banks

    parameter [4:0]   CAS  = 5'd3,
    parameter [4:0]   T_WR = 5'd3,
    parameter [4:0]   T_MRD= 5'd2,
    parameter [4:0]   T_RP = 5'd2,
    parameter [4:0]   T_RCD= 5'd2,
    parameter [4:0]   T_RC = 5'd7
)
(
    // SDRAM side interface
    inout [DATA_WIDTH-1:0]      SDRAM_DQ,
    output [ROW_WIDTH-1:0]  SDRAM_A,
    output [BANK_WIDTH-1:0] SDRAM_BA,
    output            SDRAM_nCS,    // not strictly necessary, always 0
    output            SDRAM_nWE,
    output            SDRAM_nRAS,
    output            SDRAM_nCAS,
    output            SDRAM_CLK,
    output            SDRAM_CKE,    // not strictly necessary, always 1
    output [3:0] SDRAM_DQM,
    
    // Logic side interface
    input             clk,
    input             clk_sdram,    // phase shifted from clk (normally 180-degrees)
    input             resetn,
    input             rd,           // command: read
    input             wr,           // command: write
    input             refresh,      // command: auto refresh. 4096 refresh cycles in 64ms. Once per 15us.
    input      [22:0] addr,         // byte address
    input       [15:0] din,          // data input
    input          [1:0] wdm,        // write data mask
    output      [15:0] dout,         // data output
    output [DATA_WIDTH-1:0] dout32, // 32-bit data output
    output            data_ready,   // available 6 cycles after wr is set
    output            busy,          // 0: ready for next command
    output            enabled
);

// Tri-state DQ input/output
reg dq_oen;         // 0 means output
reg [DATA_WIDTH-1:0] dq_out;
assign SDRAM_DQ = dq_oen ? 32'bzzzz_zzzz_zzzz_zzzz_zzzz_zzzz_zzzz_zzzz : dq_out;
wire [DATA_WIDTH-1:0] dq_in = SDRAM_DQ;     // DQ input
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
