lfantoniosi/CoCoTANG/(commit log)

2026-09-17 upscaler filter
2026-09-20 screen filter
2026-09-26 new board
2026-09-29 cleanup kicad
2026-09-30 final PCB v1.0.0
2026-09-30 landing page
2026-10-03 Filter CVBS picture luma across adjacent samples
2026-10-11 update bom
2026-10-11 update bom / kicad lock
2026-10-11 fix missing board pin
2026-10-12 final board/gerber files
2026-10-13 set BOM per board
2026-10-15 Add NoCan3-compatible 8 MB memory mapping
    Extend CPU MMU pages and video banks across the full SDRAM while preserving legacy Disto mappings when the added bank bits are zero. Widen cache tags and trace addresses, and include the rebuilt standard image and a BASIC-launchable bank probe.
    Validation: CPU mapping coverage for all 1024 pages, video/cache regressions, and routed timing pass. The full suite retains its existing register-timer and HDMI-overlay failures. Hardware bank verification remains pending.
2026-10-15 Correct C10 and C12 capacitor values in BOM
2026-10-16 Add reset-selected SSC audio and stabilize video scanout
    Include SSC PSG and speech in the standard image but keep them disabled,
    silent, and off the bus at cold boot. Cycle six artifact/SSC selections
    with motherboard RESET, show SSC status on HDMI and an optional doubled
    analog banner, and boost the shared SSC mix by 1.5x with saturation.
    Read back the Disto page bits in all MMU registers. Keep PMODE 4 analog
    scanout behind the renderer in both fields, preserve border/CSS alignment,
    and cover the full slow-CPU video/refresh slot to prevent reproduced black
    HDMI scanlines under memory load. Retain FPGA resource and timing fixes.
    Document the features, defaults, commands, and remaining boa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
2026-10-23 kicad changes
2026-10-24 Preserve board bus remap and RESET drive; add standalone bus tester
2026-10-25 add prototype image
2026-10-25 final boards
2026-10-26 Align CVBS field phase for stationary chroma stripes
    Apply field-start phase correction only to CVBS picture chroma and burst. Keep the S-Video carrier continuous and disable the correction in RGB and component builds. RGB rebuild meets all clock-frequency targets; encoder comparison confirms RGB/component outputs match the original behavior.
2026-10-26 Improve RGB dot timing and protect doubled HDMI scanlines
    Implement the accurate RGB aperture and two-line vertical-sync shift with a small countdown sequencer. Register analog read-ahead addresses in the existing input stage and protect the displayed HDMI cache bank through horizontal blanking.
    Commit hardware-confirmed candidate D with original SSC logic and unchanged placement settings. Add RGB geometry, analog read-latency, PMODE3 deadline and HDMI bank-protection regressions.
2026-10-26 Document PIA adapter setup and joystick second-button wiring
2026-10-27 change video board DIN position
2026-11-04 litle adjust on diode position
2026-11-13 adding PSU cap filters
