lfantoniosi/CoCoTANG/fpga/docs/remove-plastic-supports.JPG

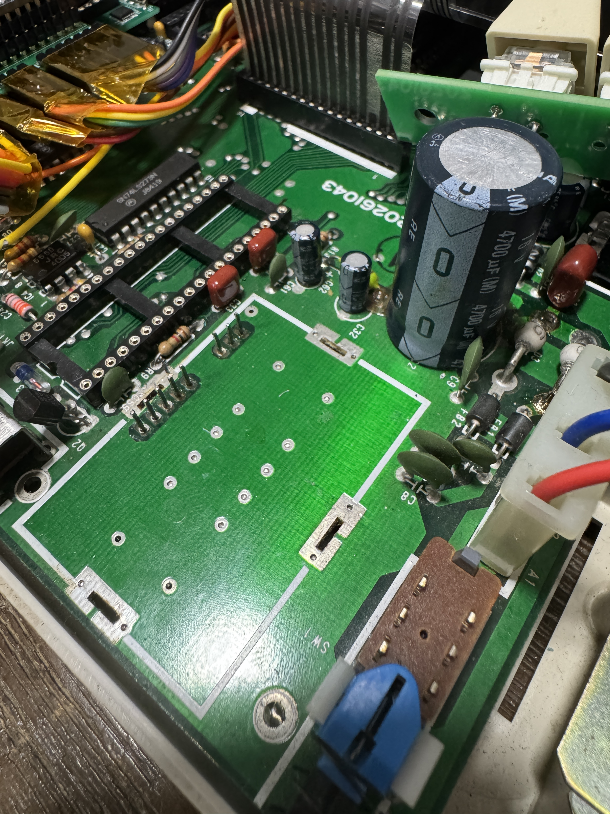
[picture p17: fpga/docs/remove-plastic-supports.JPG]
fpga/docs/remove-plastic-supports.JPG
